tonuonu/NASA-Sample-Return-Robot/README.md

NASA-Sample-Return-Robot
========================

Some code related to https://www.facebook.com/TeamKuukulgur
