tonuonu/NASA-Sample-Return-Robot/SPI-Gyro-shield/Debugging/Rubeet.xlsx

Sheet: Sheet1
tspeed | load | dist | pidp | pidi | phase | cycles | tspeed | load | dist | pidp | pidi | phase | cycles | tspeed | load | dist | pidp | pidi | phase | cycles | tspeed | load | dist | pidp | pidi | phase | cycles
0 | 1 | 0 | -8 | 0 | 2 | 296 | 0 | -5 | 0 | 4 | 0 | 4 | 1025 | 0 | 7 | 0 | -9 | 0 | 2 | 1025 | 0 | -6 | 0 | 6 | 0 | 0 | 1025
0 | 1 | 0 | -8 | 0 | 2 | 296 | 0 | -5 | 0 | 4 | 0 | 4 | 1025 | 0 | 2 | 0 | -9 | 0 | 2 | 1025 | 0 | 7 | 1 | -7 | 0 | 1 | 296
0 | -8 | 0 | 4 | 0 | 3 | 1025 | 0 | 4 | 1 | -4 | 0 | 5 | 296 | 0 | 2 | 0 | -9 | 0 | 2 | 1025 | 0 | 6 | 0 | -5 | 0 | 1 | 296
0 | -6 | 1 | 2 | 0 | 4 | 203 | 0 | 4 | 0 | -4 | 0 | 5 | 296 | 0 | 1 | 0 | -9 | 0 | 2 | 1025 | 0 | 1 | 0 | -5 | 0 | 1 | 296
0 | 0 | 0 | 2 | 0 | 4 | 203 | 0 | 0 | 0 | -4 | 0 | 5 | 296 | 0 | 2 | 0 | -9 | 0 | 2 | 1025 | 0 | 1 | 0 | -5 | 0 | 1 | 296
0 | -1 | 0 | 2 | 0 | 4 | 203 | 0 | 0 | 0 | -3 | 0 | 5 | 296 | 0 | 1 | 0 | -9 | 0 | 2 | 1025 | 0 | 1 | 0 | -5 | 0 | 1 | 296
0 | -1 | 0 | 2 | 0 | 4 | 203 | 0 | 0 | 0 | -4 | 0 | 5 | 296 | 0 | -9 | 0 | 5 | 0 | 3 | 1025 | 0 | 1 | 0 | -5 | 0 | 1 | 296
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
