tonuonu/NASA-Sample-Return-Robot/PowerSupply/Hardware/kulgurpower2-unrouted.brd

## EAGLE design PowerSupply/Hardware/kulgurpower2-unrouted.brd (2014-05-24)

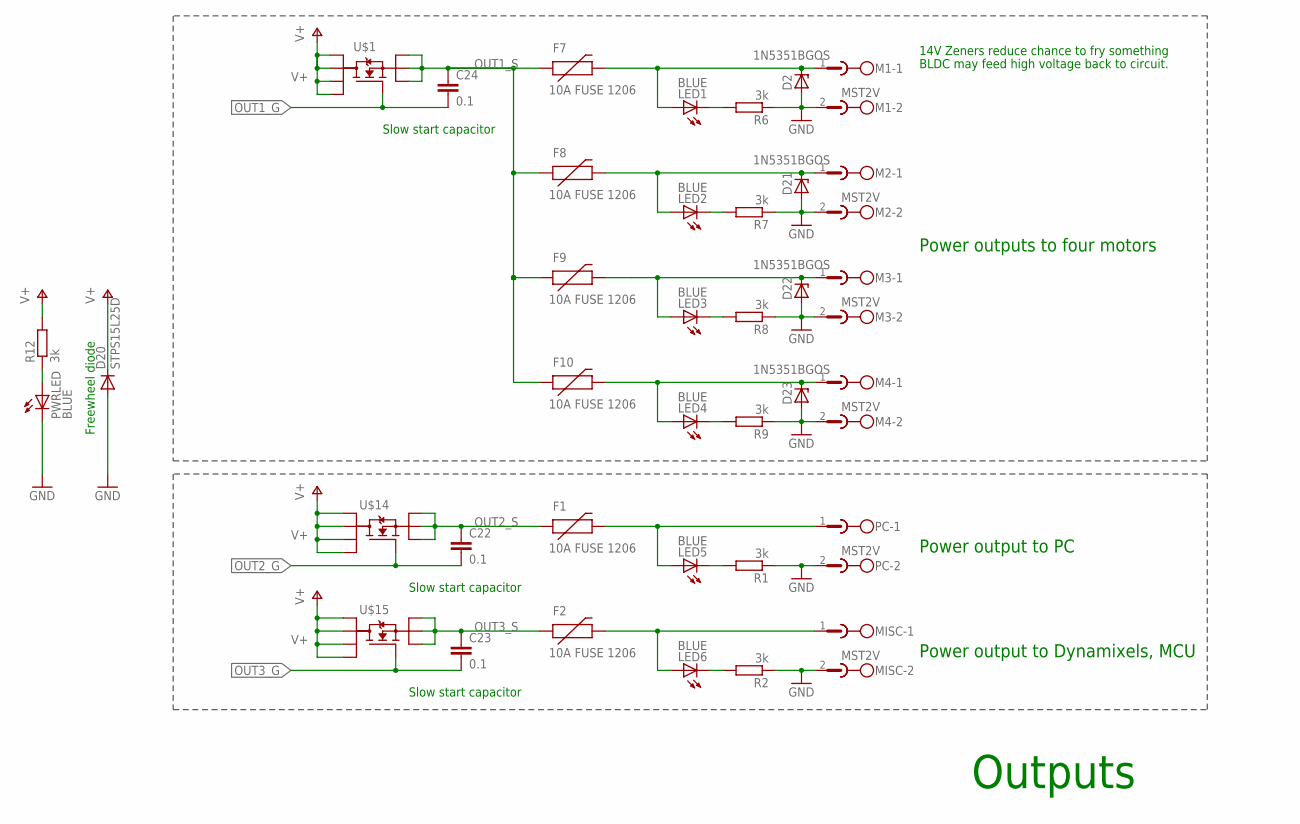
[picture p1: schematic kulgurpower2-unrouted.sch, sheet 1]

Parts:
C22, C23, C24: 0.1; C0603
D2, D21, D22, D23: 1N5351BGOS; C1702-15
D20: STPS15L25D; C221B1A
F1, F2, F7, F8, F9, F10: 10A FUSE 1206; PTC-1206
LED1, LED2, LED3, LED4, LED5, LED6: BLUE; CHIP-LED0603
M1, M2, M3, M4: MST2V; MSTBV2
MISC: MST2V; MSTBV2
PC: MST2V; MSTBV2
PWRLED: BLUE; CHIP-LED0603
R1, R2, R6, R7, R8, R9, R12: 3k; R0603
U$1, U$14, U$15: AON6500; POWER56

Connections:
GND: D2.A, D20.A, D21.A, D22.A, D23.A, M1.2, M2.2, M3.2, M4.2, MISC.2, PC.2, PWRLED.C, R1.1, R2.1, R6.1, R7.1, R8.1, R9.1; also elsewhere on the board
unnamed: LED1.C, R6.2
unnamed: LED2.C, R7.2
unnamed: LED3.C, R8.2
unnamed: LED4.C, R9.2
unnamed: LED5.C, R1.2
unnamed: LED6.C, R2.2
unnamed: PWRLED.A, R12.1
OUT1_G: C24.2, U$1.P$4 (G); also elsewhere on the board
OUT1_S: C24.1, F7.1, F8.1, F9.1, F10.1, U$1.P$1 (S1), U$1.P$2 (S2), U$1.P$3 (S3); also elsewhere on the board
OUT2_G: C22.2, U$14.P$4 (G); also elsewhere on the board
OUT2_S: C22.1, F1.1, U$14.P$1 (S1), U$14.P$2 (S2), U$14.P$3 (S3); also elsewhere on the board
OUT3_G: C23.2, U$15.P$4 (G); also elsewhere on the board
OUT3_S: C23.1, F2.1, U$15.P$1 (S1), U$15.P$2 (S2), U$15.P$3 (S3); also elsewhere on the board
PWR1: D2.C, F7.2, LED1.A, M1.1
PWR2: D21.C, F8.2, LED2.A, M2.1
PWR3: D22.C, F9.2, LED3.A, M3.1
PWR4: D23.C, F10.2, LED4.A, M4.1
PWR5: F1.2, LED5.A, PC.1
PWR6: F2.2, LED6.A, MISC.1
V+: D20.C, R12.2, U$1.P$5 (D4), U$1.P$6 (D3), U$1.P$7 (D2), U$1.P$8 (D1), U$14.P$5 (D4), U$14.P$6 (D3), U$14.P$7 (D2), U$14.P$8 (D1), U$15.P$5 (D4), U$15.P$6 (D3), U$15.P$7 (D2), U$15.P$8 (D1); also elsewhere on the board

Notes on the sheet:
Freewheel diode
BLDC may feed high voltage back to circuit.
14V Zeners reduce chance to fry something
Outputs
Power outputs to four motors
Power output to PC
Power output to Dynamixels, MCU
Slow start capacitor

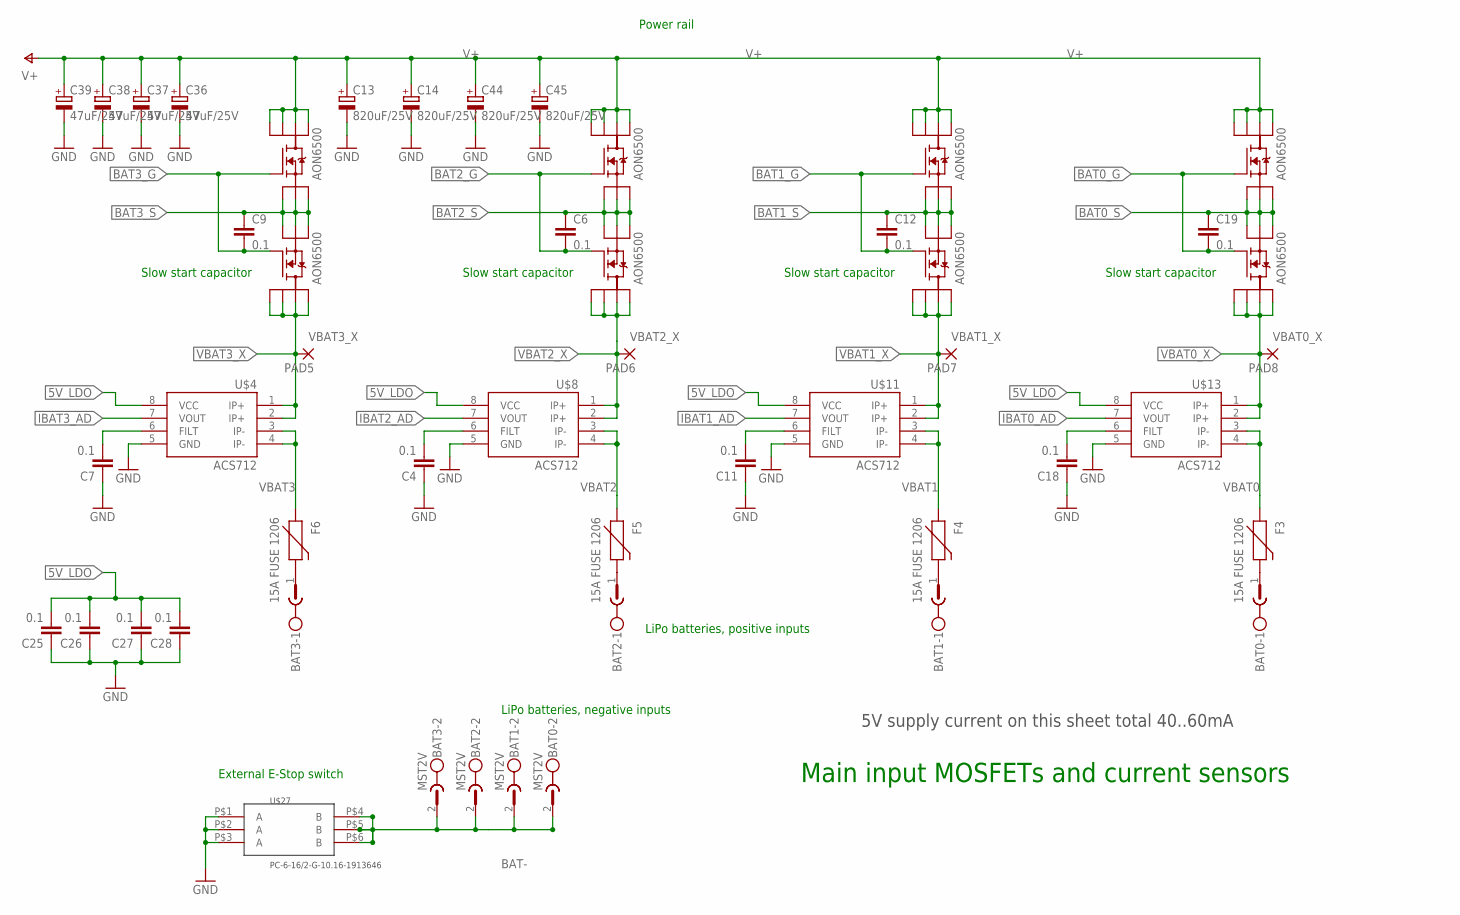
[picture p2: schematic kulgurpower2-unrouted.sch, sheet 2]

Parts:
BAT0, BAT1, BAT2, BAT3: MST2V; MSTBV2
C4, C6, C7, C9, C11, C12, C18, C19, C25, C26, C27, C28: 0.1; C0603
C13, C14, C44, C45: 820uF/25V; 153CLV-1014
C36, C37: 47uF/25V; C/6032-28R
C38, C39: 47uF/25V; 175TMP-0810
F3, F4, F5, F6: 15A FUSE 1206; PTC-1206
PAD5, PAD6, PAD7, PAD8: 1,6/0,9
U$2, U$3, U$5, U$6, U$7, U$9, U$10, U$12: AON6500; POWER56
U$4, U$8, U$11, U$13: ACS712; SO08
U$27: PC-6-16/2-G-10.16-1913646; PC-6-16/2-G-10.16

Connections:
5V_LDO: C25.2, C26.2, C27.2, C28.2, U$4.8 (VCC), U$8.8 (VCC), U$11.8 (VCC), U$13.8 (VCC); also elsewhere on the board
BAT0_G: C19.2, U$5.P$4 (G), U$12.P$4 (G); also elsewhere on the board
BAT0_S: C19.1, U$5.P$1 (S1), U$5.P$2 (S2), U$5.P$3 (S3), U$12.P$1 (S1), U$12.P$2 (S2), U$12.P$3 (S3); also elsewhere on the board
BAT1_G: C12.2, U$9.P$4 (G), U$10.P$4 (G); also elsewhere on the board
BAT1_S: C12.1, U$9.P$1 (S1), U$9.P$2 (S2), U$9.P$3 (S3), U$10.P$1 (S1), U$10.P$2 (S2), U$10.P$3 (S3); also elsewhere on the board
BAT2_G: C6.2, U$6.P$4 (G), U$7.P$4 (G); also elsewhere on the board
BAT2_S: C6.1, U$6.P$1 (S1), U$6.P$2 (S2), U$6.P$3 (S3), U$7.P$1 (S1), U$7.P$2 (S2), U$7.P$3 (S3); also elsewhere on the board
BAT3_G: C9.2, U$2.P$4 (G), U$3.P$4 (G); also elsewhere on the board
BAT3_S: C9.1, U$2.P$1 (S1), U$2.P$2 (S2), U$2.P$3 (S3), U$3.P$1 (S1), U$3.P$2 (S2), U$3.P$3 (S3); also elsewhere on the board
BAT-: BAT0.2, BAT1.2, BAT2.2, BAT3.2, U$27.P$4 (B), U$27.P$5 (B), U$27.P$6 (B)
GND: C4.1, C7.1, C11.1, C13.-, C14.-, C18.1, C25.1, C26.1, C27.1, C28.1, C36.-, C37.-, C38.-, C39.-, C44.-, C45.-, U$4.5 (GND), U$8.5 (GND), U$11.5 (GND), U$13.5 (GND), U$27.P$1 (A), U$27.P$2 (A), U$27.P$3 (A); also elsewhere on the board
IBAT0_AD: U$13.7 (VOUT); also elsewhere on the board
IBAT1_AD: U$11.7 (VOUT); also elsewhere on the board
IBAT2_AD: U$8.7 (VOUT); also elsewhere on the board
IBAT3_AD: U$4.7 (VOUT); also elsewhere on the board
unnamed: BAT0.1, F3.2
unnamed: BAT3.1, F6.2
unnamed: BAT1.1, F4.2
unnamed: C4.2, U$8.6 (FILT)
unnamed: BAT2.1, F5.2
unnamed: C11.2, U$11.6 (FILT)
unnamed: C7.2, U$4.6 (FILT)
unnamed: C18.2, U$13.6 (FILT)
V+: C13.+, C14.+, C36.+, C37.+, C38.+, C39.+, C44.+, C45.+, U$2.P$5 (D4), U$2.P$6 (D3), U$2.P$7 (D2), U$2.P$8 (D1), U$5.P$5 (D4), U$5.P$6 (D3), U$5.P$7 (D2), U$5.P$8 (D1), U$6.P$5 (D4), U$6.P$6 (D3), U$6.P$7 (D2), U$6.P$8 (D1), U$9.P$5 (D4), U$9.P$6 (D3), U$9.P$7 (D2), U$9.P$8 (D1); also elsewhere on the board
VBAT0: F3.1, U$13.3 (IP-), U$13.4 (IP-)
VBAT0_X: PAD8.1, U$12.P$5 (D4), U$12.P$6 (D3), U$12.P$7 (D2), U$12.P$8 (D1), U$13.1 (IP+), U$13.2 (IP+); also elsewhere on the board
VBAT1: F4.1, U$11.3 (IP-), U$11.4 (IP-)
VBAT1_X: PAD7.1, U$10.P$5 (D4), U$10.P$6 (D3), U$10.P$7 (D2), U$10.P$8 (D1), U$11.1 (IP+), U$11.2 (IP+); also elsewhere on the board
VBAT2: F5.1, U$8.3 (IP-), U$8.4 (IP-)
VBAT2_X: PAD6.1, U$7.P$5 (D4), U$7.P$6 (D3), U$7.P$7 (D2), U$7.P$8 (D1), U$8.1 (IP+), U$8.2 (IP+); also elsewhere on the board
VBAT3: F6.1, U$4.3 (IP-), U$4.4 (IP-)
VBAT3_X: PAD5.1, U$3.P$5 (D4), U$3.P$6 (D3), U$3.P$7 (D2), U$3.P$8 (D1), U$4.1 (IP+), U$4.2 (IP+); also elsewhere on the board

Notes on the sheet:
External E-Stop switch
LiPo batteries, positive inputs
LiPo batteries, negative inputs
Power rail
Main input MOSFETs and current sensors
5V supply current on this sheet total 40..60mA
Slow start capacitor

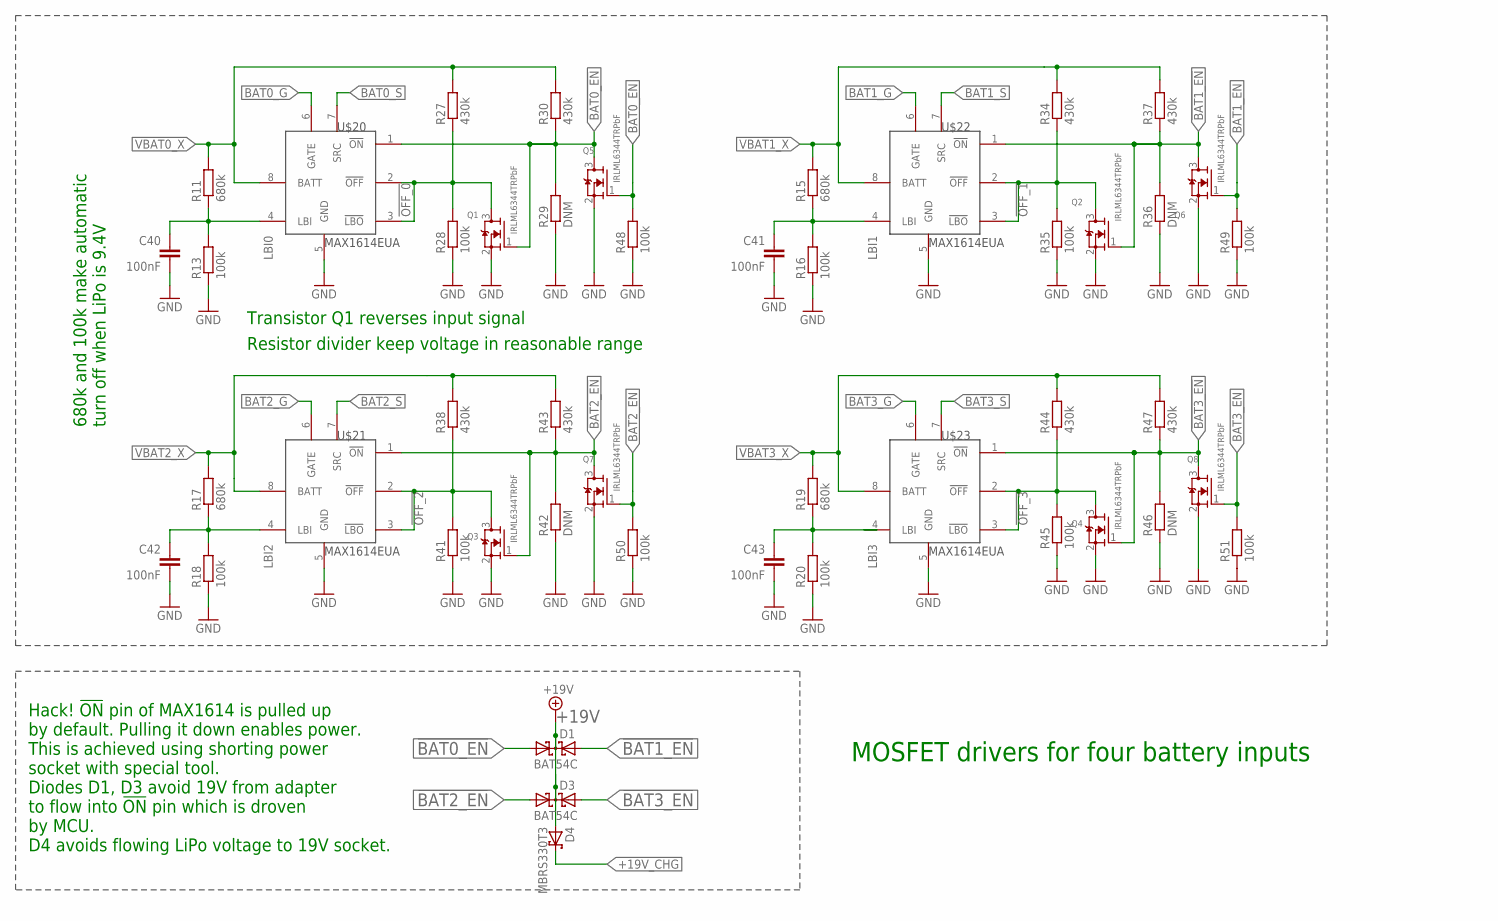
[picture p3: schematic kulgurpower2-unrouted.sch, sheet 3]

Parts:
C40, C41, C42, C43: 100nF; C0603
D1, D3: BAT54C; SOT23
D4: MBRS330T3; SMC
Q1, Q2, Q3, Q4, Q5, Q6, Q7, Q8: IRLML6344TRPbF; SOT23
R11, R15, R17, R19: 680k; R0603
R13, R16, R18, R20, R28, R35, R41, R45, R48, R49, R50, R51: 100k; R0603
R27, R30, R34, R37, R38, R43, R44, R47: 430k; R0603
R29, R36, R42, R46: DNM; R0603
U$20, U$21, U$22, U$23: MAX1614EUA

Connections:
!BAT0_EN: D1.1 (A1), Q1.1 (G), Q5.3 (D), R29.2, R30.1, U$20.1 (!ON)
!BAT1_EN: D1.2 (A2), Q2.1 (G), Q6.3 (D), R36.2, R37.1, U$22.1 (!ON)
!BAT2_EN: D3.1 (A1), Q3.1 (G), Q7.3 (D), R42.2, R43.1, U$21.1 (!ON)
!BAT3_EN: D3.2 (A2), Q4.1 (G), Q8.3 (D), R46.2, R47.1, U$23.1 (!ON)
!OFF_0: Q1.3 (D), R27.1, R28.2, U$20.2 (!OFF), U$20.3 (!LBO)
!OFF_1: Q2.3 (D), R34.1, R35.2, U$22.2 (!OFF), U$22.3 (!LBO)
!OFF_2: Q3.3 (D), R38.1, R41.2, U$21.2 (!OFF), U$21.3 (!LBO)
!OFF_3: Q4.3 (D), R44.1, R45.2, U$23.2 (!OFF), U$23.3 (!LBO)
+19V: D1.3 (CC), D3.3 (CC), D4.A; also elsewhere on the board
+19V_CHG: D4.C; also elsewhere on the board
BAT0_EN: Q5.1 (G), R48.2; also elsewhere on the board
BAT0_G: U$20.6 (GATE); also elsewhere on the board
BAT0_S: U$20.7 (SRC); also elsewhere on the board
BAT1_EN: Q6.1 (G), R49.2; also elsewhere on the board
BAT1_G: U$22.6 (GATE); also elsewhere on the board
BAT1_S: U$22.7 (SRC); also elsewhere on the board
BAT2_EN: Q7.1 (G), R50.2; also elsewhere on the board
BAT2_G: U$21.6 (GATE); also elsewhere on the board
BAT2_S: U$21.7 (SRC); also elsewhere on the board
BAT3_EN: Q8.1 (G), R51.2; also elsewhere on the board
BAT3_G: U$23.6 (GATE); also elsewhere on the board
BAT3_S: U$23.7 (SRC); also elsewhere on the board
GND: C40.2, C41.2, C42.2, C43.2, Q1.2 (S), Q2.2 (S), Q3.2 (S), Q4.2 (S), Q5.2 (S), Q6.2 (S), Q7.2 (S), Q8.2 (S), R13.1, R16.1, R18.1, R20.1, R28.1, R29.1, R35.1, R36.1, R41.1, R42.1, R45.1, R46.1, R48.1, R49.1, R50.1, R51.1, U$20.5 (GND), U$21.5 (GND), U$22.5 (GND), U$23.5 (GND); also elsewhere on the board
LBI0: C40.1, R11.1, R13.2, U$20.4 (LBI)
LBI1: C41.1, R15.1, R16.2, U$22.4 (LBI)
LBI2: C42.1, R17.1, R18.2, U$21.4 (LBI)
LBI3: C43.1, R19.1, R20.2, U$23.4 (LBI)
VBAT0_X: R11.2, R27.2, R30.2, U$20.8 (BATT); also elsewhere on the board
VBAT1_X: R15.2, R34.2, R37.2, U$22.8 (BATT); also elsewhere on the board
VBAT2_X: R17.2, R38.2, R43.2, U$21.8 (BATT); also elsewhere on the board
VBAT3_X: R19.2, R44.2, R47.2, U$23.8 (BATT); also elsewhere on the board

Notes on the sheet:
680k and 100k make automatic turn off when LiPo is 9.4V
MOSFET drivers for four battery inputs
Hack! !ON! pin of MAX1614 is pulled up by default. Pulling it down enables power. This is achieved using shorting power socket with special tool. Diodes D1, D3 avoid 19V from adapter to flow into !ON! pin which is droven by MCU. D4 avoids flowing LiPo voltage to 19V socket.
Resistor divider keep voltage in reasonable range
Transistor Q1 reverses input signal

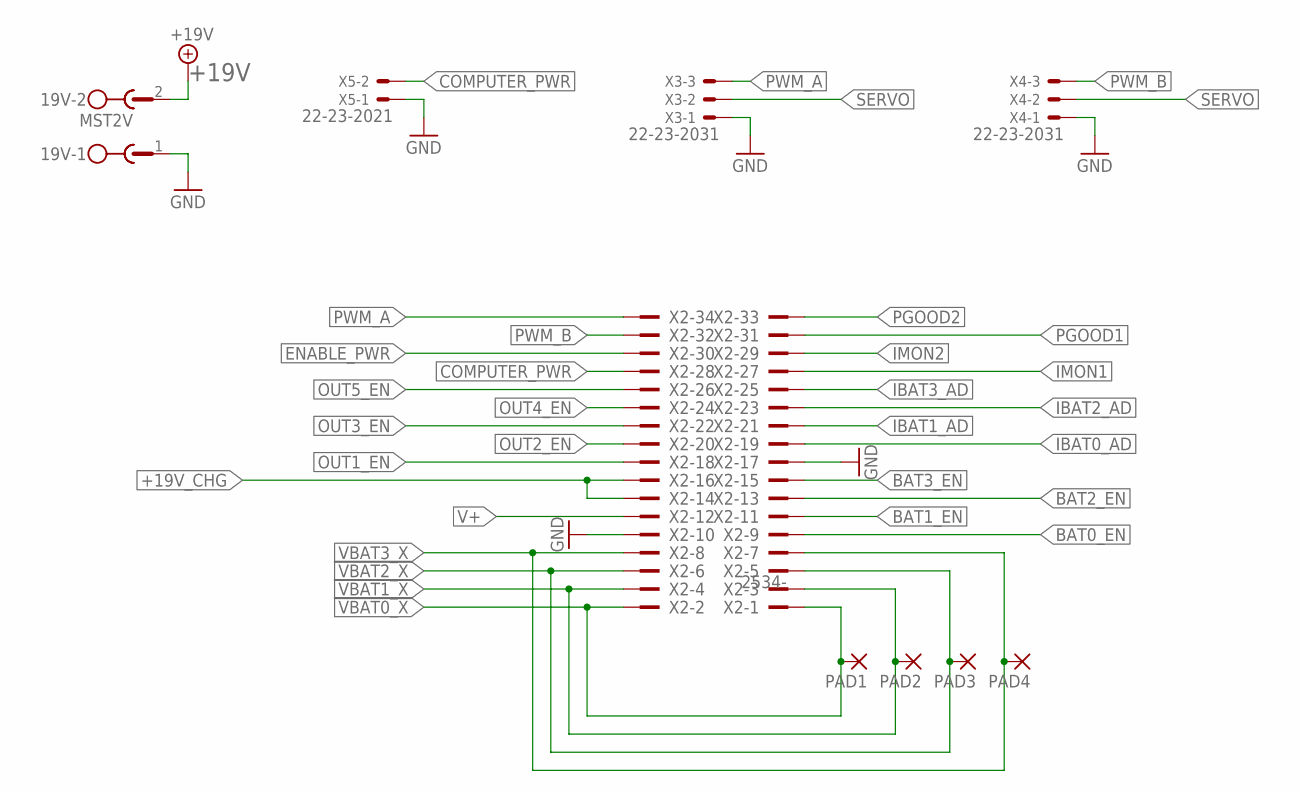
[picture p4: schematic kulgurpower2-unrouted.sch, sheet 4]

Parts:
19V: MST2V; MSTBV2
PAD1, PAD2, PAD3, PAD4: 1,6/0,9
X2: 2534-; PAK100/2500-34
X3, X4: 22-23-2031
X5: 22-23-2021

Connections:
+19V: 19V.2; also elsewhere on the board
+19V_CHG: X2.14, X2.16; also elsewhere on the board
BAT0_EN: X2.9; also elsewhere on the board
BAT1_EN: X2.11; also elsewhere on the board
BAT2_EN: X2.13; also elsewhere on the board
BAT3_EN: X2.15; also elsewhere on the board
COMPUTER_PWR: X2.28, X5.2
ENABLE_PWR: X2.30; also elsewhere on the board
GND: 19V.1, X2.10, X2.17, X3.1, X4.1, X5.1; also elsewhere on the board
IBAT0_AD: X2.19; also elsewhere on the board
IBAT1_AD: X2.21; also elsewhere on the board
IBAT2_AD: X2.23; also elsewhere on the board
IBAT3_AD: X2.25; also elsewhere on the board
IMON1: X2.27; also elsewhere on the board
IMON2: X2.29; also elsewhere on the board
OUT1_EN: X2.18; also elsewhere on the board
OUT2_EN: X2.20; also elsewhere on the board
OUT3_EN: X2.22; also elsewhere on the board
OUT4_EN: X2.24; also elsewhere on the board
OUT5_EN: X2.26; also elsewhere on the board
PGOOD1: X2.31; also elsewhere on the board
PGOOD2: X2.33; also elsewhere on the board
PWM_A: X2.34, X3.3
PWM_B: X2.32, X4.3
SERVO: X3.2, X4.2; also elsewhere on the board
V+: X2.12; also elsewhere on the board
VBAT0_X: PAD1.1, X2.1, X2.2; also elsewhere on the board
VBAT1_X: PAD2.1, X2.3, X2.4; also elsewhere on the board
VBAT2_X: PAD3.1, X2.5, X2.6; also elsewhere on the board
VBAT3_X: PAD4.1, X2.7, X2.8; also elsewhere on the board

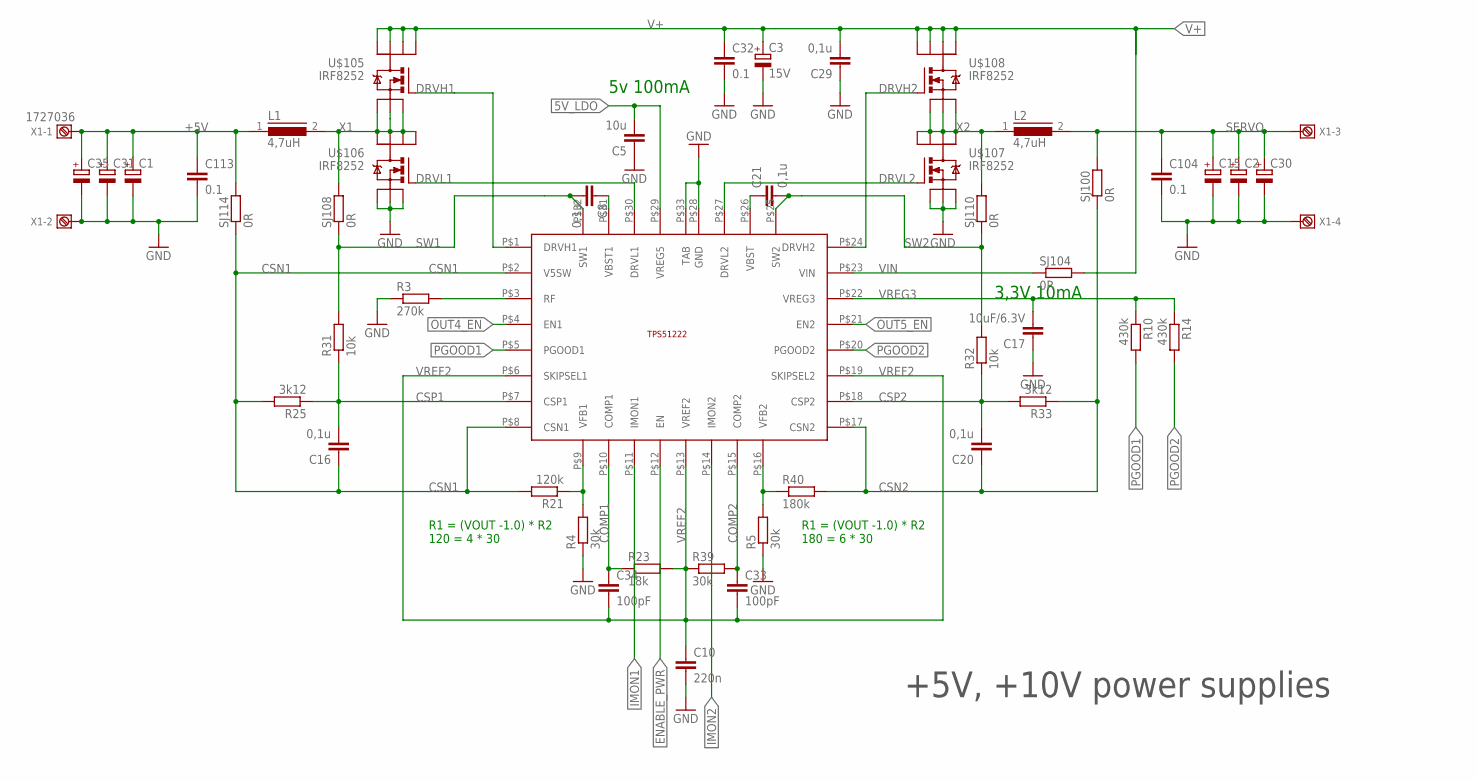
[picture p5: schematic kulgurpower2-unrouted.sch, sheet 5]

Parts:
C1, C2, C15, C30, C31, C35: CPOL-EUC/6032-28R; C/6032-28R
C3: 15V; C/6032-28R
C5: 10u; C1210
C8, C16, C20, C21, C29: 0,1u; C0603
C10: 220n; C0603
C17: 10uF/6.3V; C1210
C32, C104, C113: 0.1; C0603
C33, C34: 100pF; 0805
L1, L2: 4,7uH; DR125
R3: 270k; R0603
R4, R5, R39: 30k; R0603
R10, R14: 430k; R0603
R21: 120k; R0603
R23: 18k; R0603
R25, R33: 3k12; R0603
R31, R32: 10k; R0603
R40: 180k; R0603
SJ100, SJ104, SJ108, SJ110, SJ114: 0R; R0603
U$17: TPS51222RTVT; QFN-32
U$105, U$106, U$107, U$108: IRF8252; SO8
X1: 1727036

Connections:
5V_LDO: C5.2, U$17.P$29 (VREG5); also elsewhere on the board
+5V: C1.+, C31.+, C35.+, C113.1, L1.1, SJ114.2, X1.1
COMP1: C34.1, R23.1, U$17.P$10 (COMP1)
COMP2: C33.1, R39.2, U$17.P$15 (COMP2)
CSN1: C16.1, R21.2, R25.2, SJ114.1, U$17.P$2 (V5SW), U$17.P$8 (CSN1)
CSN2: C20.1, R33.1, R40.2, SJ100.1, U$17.P$17 (CSN2)
CSP1: C16.2, R25.1, R31.1, U$17.P$7 (CSP1)
CSP2: C20.2, R32.1, R33.2, U$17.P$18 (CSP2)
DRVH1: U$17.P$1 (DRVH1), U$105.4 (G)
DRVH2: U$17.P$24 (DRVH2), U$108.4 (G)
DRVL1: U$17.P$30 (DRVL1), U$106.4 (G)
DRVL2: U$17.P$27 (DRVL2), U$107.4 (G)
ENABLE_PWR: U$17.P$12 (EN); also elsewhere on the board
GND: C1.-, C2.-, C3.-, C5.1, C10.2, C15.-, C17.1, C29.1, C30.-, C31.-, C32.2, C35.-, C104.2, C113.2, R3.1, R4.1, R5.1, U$17.P$28 (GND), U$17.P$33 (TAB), U$106.1 (S), U$106.2 (S), U$106.3 (S), U$107.1 (S), U$107.2 (S), U$107.3 (S), X1.2, X1.4; also elsewhere on the board
IMON1: U$17.P$11 (IMON1); also elsewhere on the board
IMON2: U$17.P$14 (IMON2); also elsewhere on the board
unnamed: R4.2, R21.1, U$17.P$9 (VFB1)
unnamed: R5.2, R40.1, U$17.P$16 (VFB2)
unnamed: R3.2, U$17.P$3 (RF)
unnamed: C8.1, U$17.P$31 (VBST1)
unnamed: C21.1, U$17.P$26 (VBST)
OUT4_EN: U$17.P$4 (EN1); also elsewhere on the board
OUT5_EN: U$17.P$21 (EN2); also elsewhere on the board
PGOOD1: R10.2, U$17.P$5 (PGOOD1); also elsewhere on the board
PGOOD2: R14.2, U$17.P$20 (PGOOD2); also elsewhere on the board
SERVO: C2.+, C15.+, C30.+, C104.1, L2.2, SJ100.2, X1.3; also elsewhere on the board
SW1: C8.2, R31.2, SJ108.1, U$17.P$32 (SW1)
SW2: C21.2, R32.2, SJ110.1, U$17.P$25 (SW2)
V+: C3.+, C29.2, C32.1, SJ104.2, U$105.5 (D), U$105.6 (D), U$105.7 (D), U$105.8 (D), U$108.5 (D), U$108.6 (D), U$108.7 (D), U$108.8 (D); also elsewhere on the board
VIN: SJ104.1, U$17.P$23 (VIN)
VREF2: C10.1, C33.2, C34.2, R23.2, R39.1, U$17.P$6 (SKIPSEL1), U$17.P$13 (VREF2), U$17.P$19 (SKIPSEL2)
VREG3: C17.2, R10.1, R14.1, U$17.P$22 (VREG3)
X1: L1.2, SJ108.2, U$105.1 (S), U$105.2 (S), U$105.3 (S), U$106.5 (D), U$106.6 (D), U$106.7 (D), U$106.8 (D)
X2: L2.1, SJ110.2, U$107.5 (D), U$107.6 (D), U$107.7 (D), U$107.8 (D), U$108.1 (S), U$108.2 (S), U$108.3 (S)

Notes on the sheet:
+5V, +10V power supplies
3,3V 10mA
5v 100mA
R1 = (VOUT -1.0) * R2 120 = 4 * 30
R1 = (VOUT -1.0) * R2 180 = 6 * 30

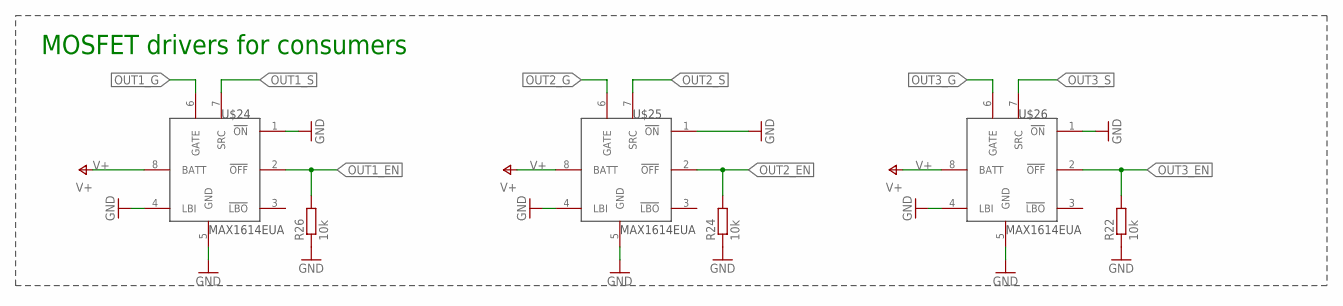
[picture p6: schematic kulgurpower2-unrouted.sch, sheet 6]

Parts:
R22, R24, R26: 10k; R0603
U$24, U$25, U$26: MAX1614EUA

Connections:
GND: R22.1, R24.1, R26.1, U$24.1 (!ON), U$24.4 (LBI), U$24.5 (GND), U$25.1 (!ON), U$25.4 (LBI), U$25.5 (GND), U$26.1 (!ON), U$26.4 (LBI), U$26.5 (GND); also elsewhere on the board
OUT1_EN: R26.2, U$24.2 (!OFF); also elsewhere on the board
OUT1_G: U$24.6 (GATE); also elsewhere on the board
OUT1_S: U$24.7 (SRC); also elsewhere on the board
OUT2_EN: R24.2, U$25.2 (!OFF); also elsewhere on the board
OUT2_G: U$25.6 (GATE); also elsewhere on the board
OUT2_S: U$25.7 (SRC); also elsewhere on the board
OUT3_EN: R22.2, U$26.2 (!OFF); also elsewhere on the board
OUT3_G: U$26.6 (GATE); also elsewhere on the board
OUT3_S: U$26.7 (SRC); also elsewhere on the board
V+: U$24.8 (BATT), U$25.8 (BATT), U$26.8 (BATT); also elsewhere on the board

Notes on the sheet:
MOSFET drivers for consumers

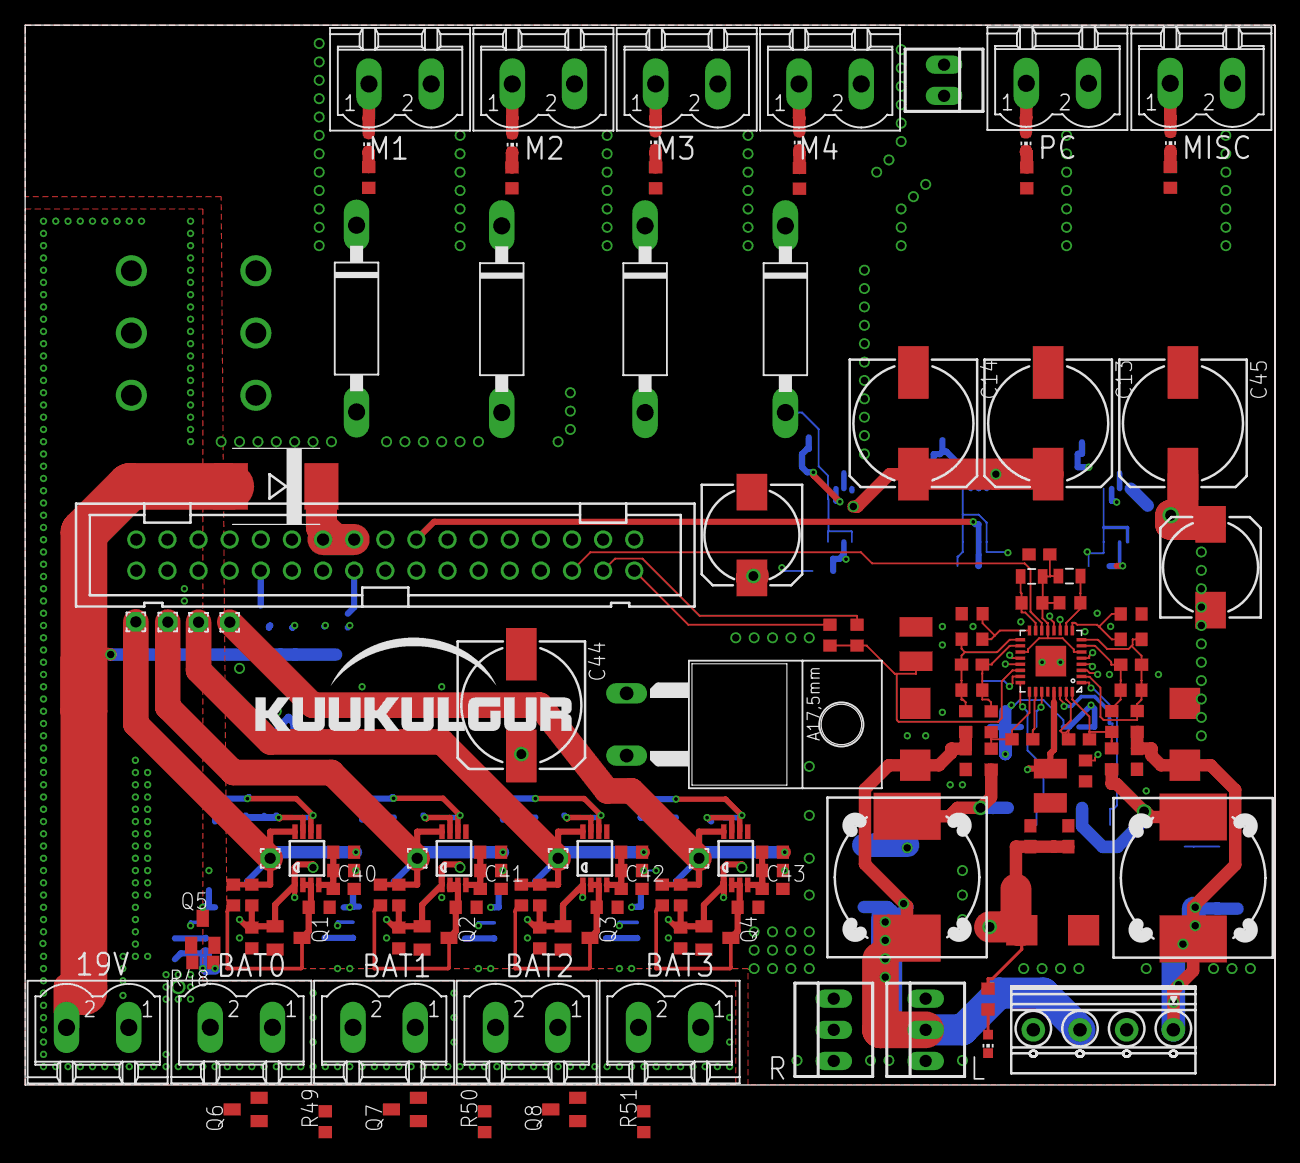
[picture p7: board kulgurpower2-unrouted.brd from above]

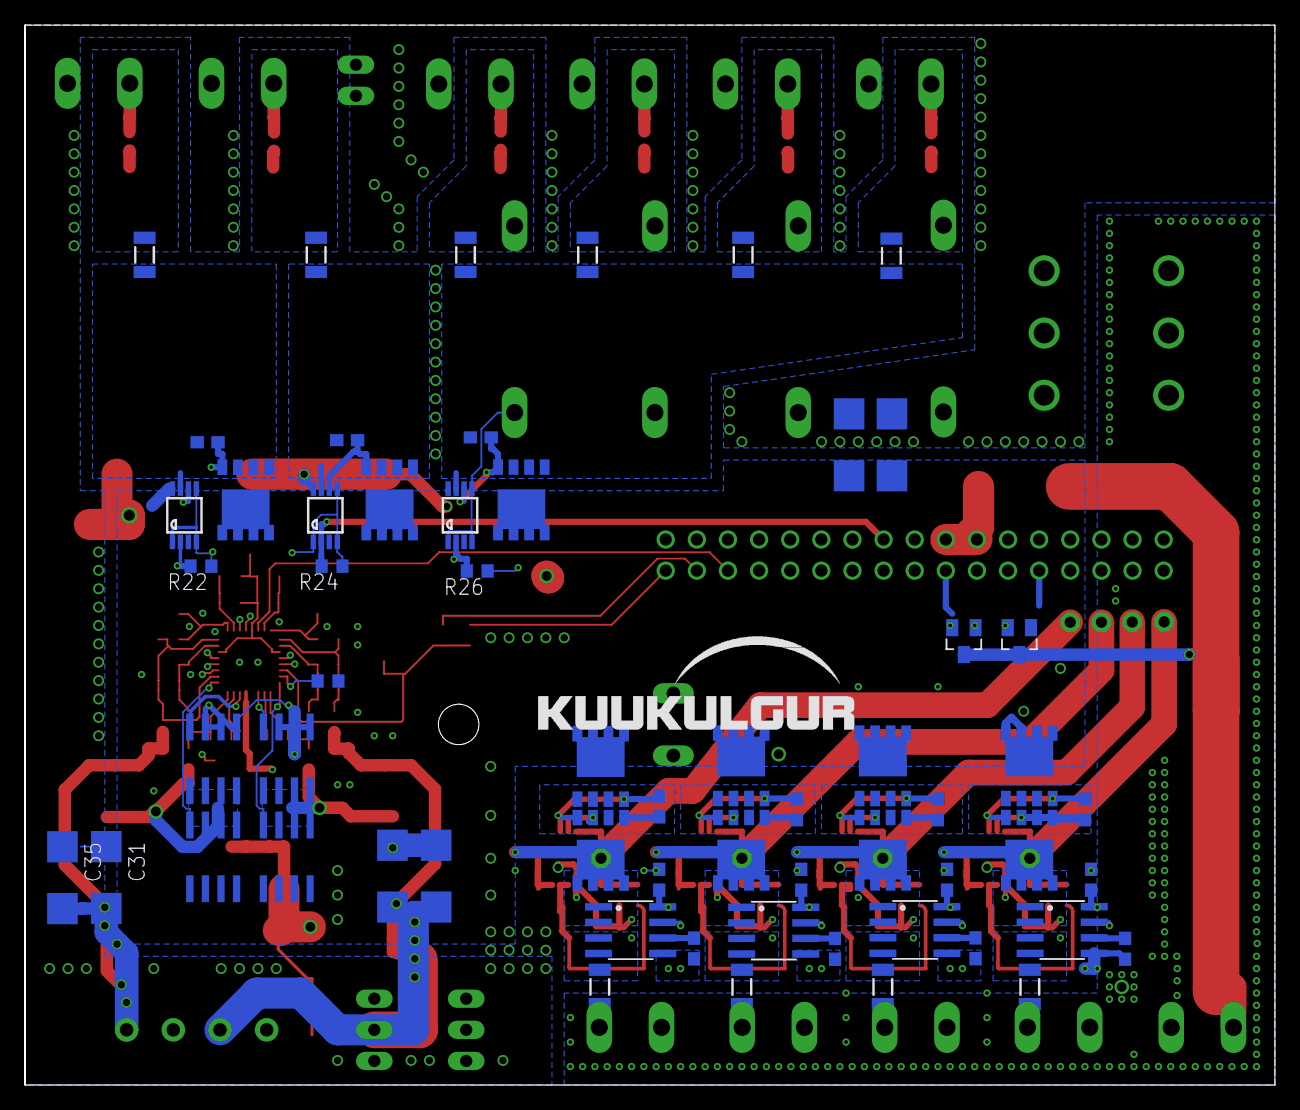
[picture p8: board kulgurpower2-unrouted.brd from below]

Board: 4 copper layers, 102.0 x 86.5 mm, 190 parts (59 on the bottom side), 106 nets.
