tonuonu/NASA-Sample-Return-Robot/PowerSupply/Hardware/kulgurpowerMCU3-unrouted.brd

## EAGLE design PowerSupply/Hardware/kulgurpowerMCU3-unrouted.brd (2014-05-14)

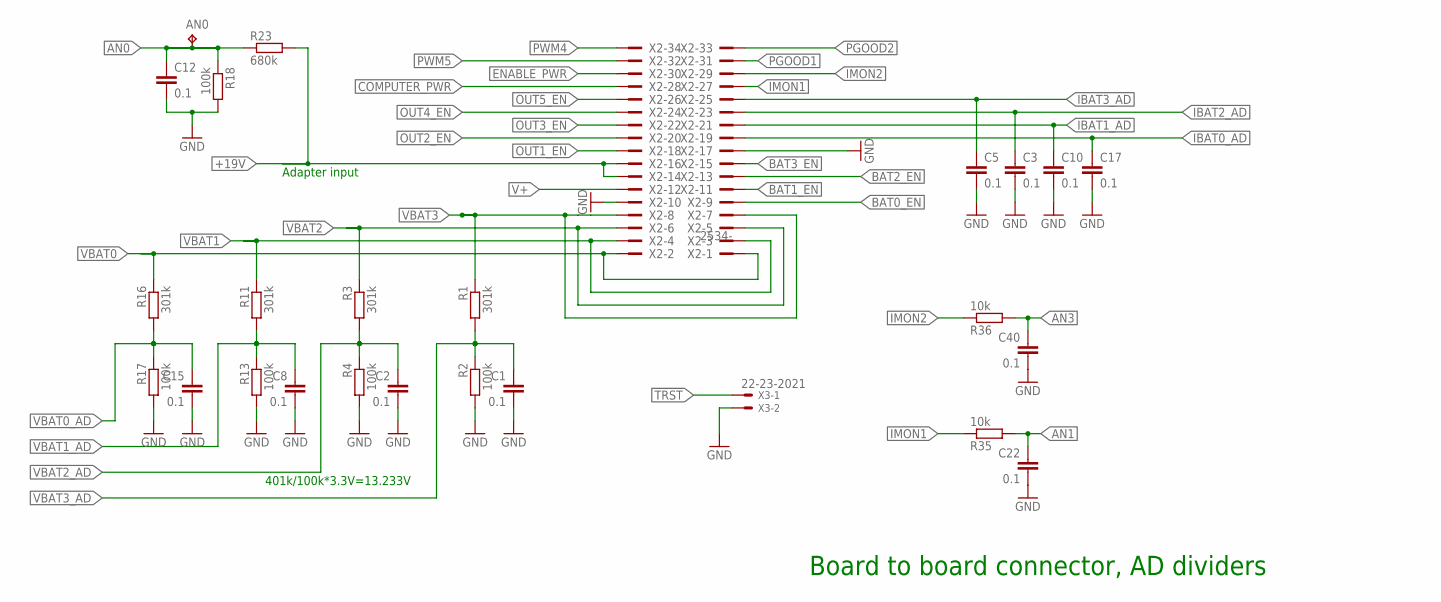
[picture p9: schematic kulgurpowerMCU3-unrouted.sch, sheet 1]

Parts:
AN0: TPB1,27; B1,27
C1, C2, C3, C5, C8, C10, C15, C17, C22, C40: 0.1; C0603
C12: 0.1; 0603-CAP
R1, R3, R11, R16: 301k; R0603
R2, R4, R13, R17, R18: 100k; R0603
R23: 680k; R0603
R35, R36: 10k; R0603
X2: 2534-; PAK100/2500-34
X3: 22-23-2021

Connections:
!TRST: X3.1; also elsewhere on the board
+19V: R23.2, X2.14, X2.16; also elsewhere on the board
AN0: AN0.TP, C12.1, R18.1, R23.1; also elsewhere on the board
AN1: C22.1, R35.2; also elsewhere on the board
AN3: C40.1, R36.2; also elsewhere on the board
BAT0_EN: X2.9; also elsewhere on the board
BAT1_EN: X2.11; also elsewhere on the board
BAT2_EN: X2.13; also elsewhere on the board
BAT3_EN: X2.15; also elsewhere on the board
COMPUTER_PWR: X2.28; also elsewhere on the board
ENABLE_PWR: X2.30; also elsewhere on the board
GND: C1.2, C2.2, C3.2, C5.2, C8.2, C10.2, C12.2, C15.2, C17.2, C22.2, C40.2, R2.2, R4.2, R13.2, R17.2, R18.2, X2.10, X2.17, X3.2; also elsewhere on the board
IBAT0_AD: C17.1, X2.19; also elsewhere on the board
IBAT1_AD: C10.1, X2.21; also elsewhere on the board
IBAT2_AD: C3.1, X2.23; also elsewhere on the board
IBAT3_AD: C5.1, X2.25; also elsewhere on the board
IMON1: R35.1, X2.27
IMON2: R36.1, X2.29
OUT1_EN: X2.18; also elsewhere on the board
OUT2_EN: X2.20; also elsewhere on the board
OUT3_EN: X2.22; also elsewhere on the board
OUT4_EN: X2.24; also elsewhere on the board
OUT5_EN: X2.26; also elsewhere on the board
PGOOD1: X2.31; also elsewhere on the board
PGOOD2: X2.33; also elsewhere on the board
PWM4: X2.34; also elsewhere on the board
PWM5: X2.32; also elsewhere on the board
V+: X2.12; also elsewhere on the board
VBAT0: R16.1, X2.1, X2.2; also elsewhere on the board
VBAT0_AD: C15.1, R16.2, R17.1; also elsewhere on the board
VBAT1: R11.1, X2.3, X2.4; also elsewhere on the board
VBAT1_AD: C8.1, R11.2, R13.1; also elsewhere on the board
VBAT2: R3.1, X2.5, X2.6; also elsewhere on the board
VBAT2_AD: C2.1, R3.2, R4.1; also elsewhere on the board
VBAT3: R1.1, X2.7, X2.8; also elsewhere on the board
VBAT3_AD: C1.1, R1.2, R2.1; also elsewhere on the board

Notes on the sheet:
401k/100k*3.3V=13.233V
Board to board connector, AD dividers
Adapter input
