tonuonu/NASA-Sample-Return-Robot/PowerSupply/Hardware/kulgurpowerMCU3-unrouted.brd

## EAGLE design PowerSupply/Hardware/kulgurpowerMCU3-unrouted.brd (continued)

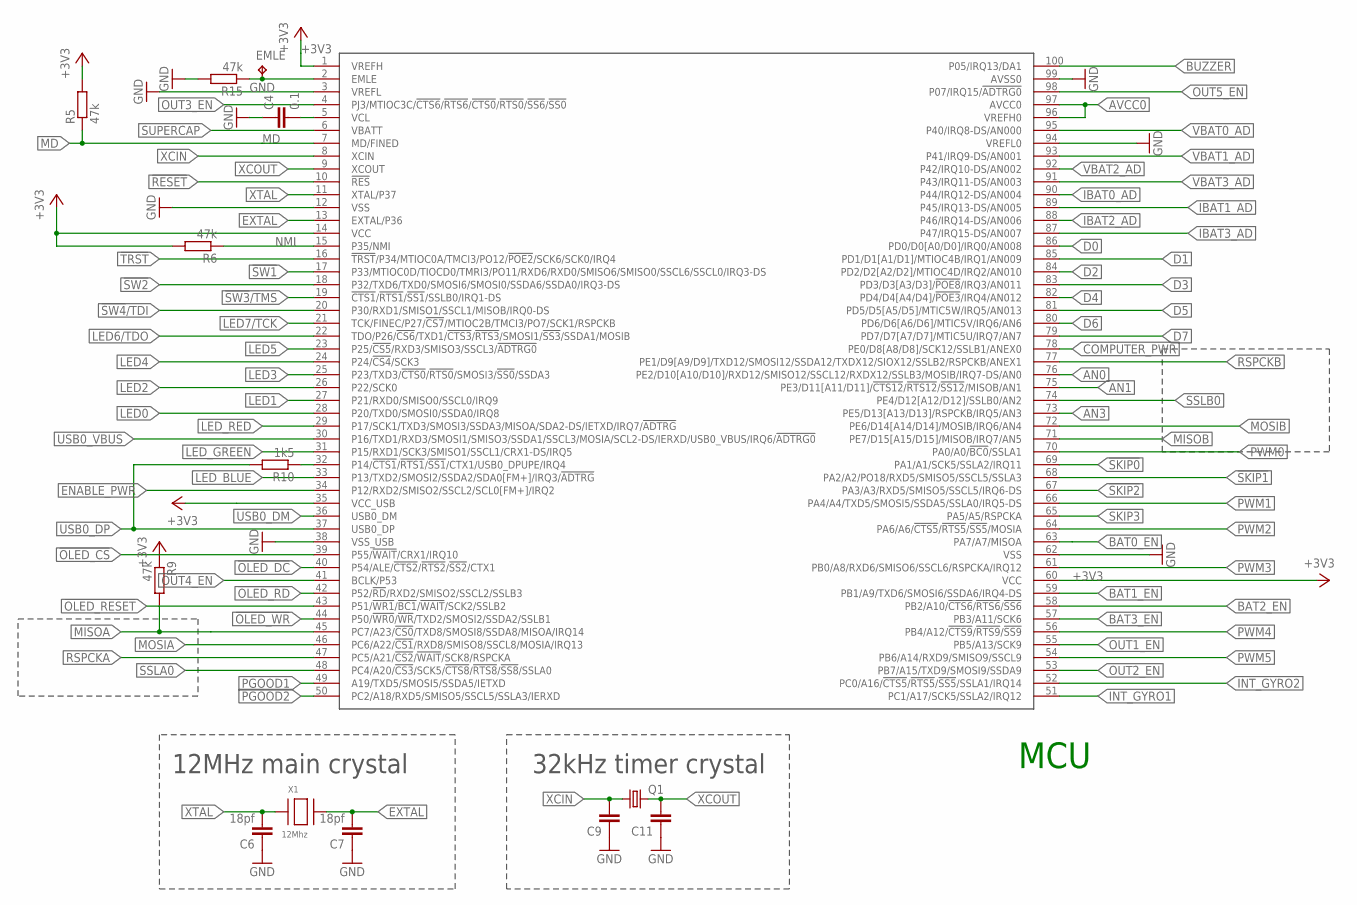
[picture p10: schematic kulgurpowerMCU3-unrouted.sch, sheet 2]

Parts:
C4: 0.1; 0603-CAP
C6, C7: 18pf; 0603-CAP
C9, C11: CAP0603-CAP; 0603-CAP
EMLE: TPB1,27; B1,27
Q1: CRYSTALMM20SS; MM20SS
R5, R6, R9, R15: 47k; R0603
R10: 1k5; R0603
U$14: R5F5630ADDFP; LTQFP100
X1: 12Mhz; NX5032

Connections:
!OLED_CS: U$14.39 (P55/!WAIT!/CRX1/IRQ10); also elsewhere on the board
!OLED_DC: U$14.40 (P54/ALE/!CTS2!/!RTS2!/!SS2!/CTX1); also elsewhere on the board
!OLED_RD: U$14.42 (P52/!RD!/RXD2/SMISO2/SSCL2/SSLB3); also elsewhere on the board
!OLED_RESET: U$14.43 (P51/!WR1!/!BC1!/!WAIT!/SCK2/SSLB2); also elsewhere on the board
!OLED_WR: U$14.44 (P50/!WR0!/!WR!/TXD2/SMOSI2/SSDA2/SSLB1); also elsewhere on the board
!RESET: U$14.10 (!RES!); also elsewhere on the board
!SKIP0: U$14.69 (PA1/A1/SCK5/SSLA2/IRQ11); also elsewhere on the board
!SKIP1: U$14.68 (PA2/A2/PO18/RXD5/SMISO5/SSCL5/SSLA3); also elsewhere on the board
!SKIP2: U$14.67 (PA3/A3/RXD5/SMISO5/SSCL5/IRQ6-DS); also elsewhere on the board
!SKIP3: U$14.65 (PA5/A5/RSPCKA); also elsewhere on the board
!SW1: U$14.17 (P33/MTIOC0D/TIOCD0/TMRI3/PO11/RXD6/RXD0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); also elsewhere on the board
!SW2: U$14.18 (P32/TXD6/TXD0/SMOSI6/SMOSI0/SSDA6/SSDA0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); also elsewhere on the board
!SW3!/TMS: U$14.19 (!CTS1!/!RTS1!/!SS1!/SSLB0/IRQ1-DS); also elsewhere on the board
!SW4!/TDI: U$14.20 (P30/RXD1/SMISO1/SSCL1/MISOB/IRQ0-DS); also elsewhere on the board
!TRST: U$14.16 (!TRST!/P34/MTIOC0A/TMCI3/PO12/!POE2!/SC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); also elsewhere on the board
+3V3: R5.2, R6.2, R9.1, U$14.1 (VREFH), U$14.14 (VCC), U$14.35 (VCC_USB), U$14.60 (VCC); also elsewhere on the board
AN0: U$14.76 (PE2/D10[A10/D10]/RXD12/SMISO12/SSCL12/R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); also elsewhere on the board
AN1: U$14.75 (PE3/D11[A11/D11]/!CTS12!/!RTS12!/!SS12!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); also elsewhere on the board
AN3: U$14.73 (PE5/D13[A13/D13]/RSPCKB/IRQ5/AN3); also elsewhere on the board
AVCC0: U$14.96 (VREFH0), U$14.97 (AVCC0); also elsewhere on the board
BAT0_EN: U$14.63 (PA7/A7/MISOA); also elsewhere on the board
BAT1_EN: U$14.59 (PB1/A9/TXD6/SMOSI6/SSDA6/IRQ4-DS); also elsewhere on the board
BAT2_EN: U$14.58 (PB2/A10/!CTS6!/!RTS6!/!SS6!); also elsewhere on the board
BAT3_EN: U$14.57 (PB3/A11/SCK6); also elsewhere on the board
BUZZER: U$14.100 (P05/IRQ13/DA1); also elsewhere on the board
COMPUTER_PWR: U$14.78 (PE0/D8[A8/D8]/SCK12/SSLB1/ANEX0); also elsewhere on the board
D0: U$14.86 (PD0/D0[A0/D0]/IRQ0/AN008); also elsewhere on the board
D1: U$14.85 (PD1/D1[A1/D1]/MTIOC4B/IRQ1/AN009); also elsewhere on the board
D2: U$14.84 (PD2/D2[A2/D2]/MTIOC4D/IRQ2/AN010); also elsewhere on the board
D3: U$14.83 (PD3/D3[A3/D3]/!POE8!/IRQ3/AN011); also elsewhere on the board
D4: U$14.82 (PD4/D4[A4/D4]/!POE3!/IRQ4/AN012); also elsewhere on the board
D5: U$14.81 (PD5/D5[A5/D5]/MTIC5W/IRQ5/AN013); also elsewhere on the board
D6: U$14.80 (PD6/D6[A6/D6]/MTIC5V/IRQ6/AN6); also elsewhere on the board
D7: U$14.79 (PD7/D7[A7/D7]/MTIC5U/IRQ7/AN7); also elsewhere on the board
EMLE: EMLE.TP, R15.1, U$14.2 (EMLE); also elsewhere on the board
ENABLE_PWR: U$14.34 (P12/RXD2/SMISO2/SSCL2/SCL0[FM+]/IRQ2); also elsewhere on the board
EXTAL: C7.2, U$14.13 (EXTAL/P36), X1.P$2
GND: C4.1, C6.1, C7.1, C9.1, C11.1, R15.2, U$14.3 (VREFL), U$14.12 (VSS), U$14.38 (VSS_USB), U$14.62 (VSS), U$14.94 (VREFL0), U$14.99 (AVSS0); also elsewhere on the board
IBAT0_AD: U$14.90 (P44/IRQ12-DS/AN004); also elsewhere on the board
IBAT1_AD: U$14.89 (P45/IRQ13-DS/AN005); also elsewhere on the board
IBAT2_AD: U$14.88 (P46/IRQ14-DS/AN006); also elsewhere on the board
IBAT3_AD: U$14.87 (P47/IRQ15-DS/AN007); also elsewhere on the board
INT_GYRO1: U$14.51 (PC1/A17/SCK5/SSLA2/IRQ12); also elsewhere on the board
INT_GYRO2: U$14.52 (PC0/A16/!CTS5!/!RTS5!/!SS5!/SSLA1/IRQ14); also elsewhere on the board
LED0: U$14.28 (P20/TXD0/SMOSI0/SSDA0/IRQ8); also elsewhere on the board
LED1: U$14.27 (P21/RXD0/SMISO0/SSCL0/IRQ9); also elsewhere on the board
LED2: U$14.26 (P22/SCK0); also elsewhere on the board
LED3: U$14.25 (P23/TXD3/!CTS0!/!RTS0!/SMOSI3/!SS0!/SSD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); also elsewhere on the board
LED4: U$14.24 (P24/!CS4!/SCK3); also elsewhere on the board
LED5: U$14.23 (P25/!CS5!/RXD3/SMISO3/SSCL3/!ADTRG0!); also elsewhere on the board
LED6/TDO: U$14.22 (TDO/P26/!CS6!/TXD1/!CTS3!/!RTS3!/SMOSI1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); also elsewhere on the board
LED7/TCK: U$14.21 (TCK/FINEC/P27/!CS7!/MTIOC2B/TMCI3/PO7/S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); also elsewhere on the board
LED_BLUE: U$14.33 (P13/TXD2/SMOSI2/SSDA2/SDA0[FM+]/IRQ3/!A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); also elsewhere on the board
LED_GREEN: U$14.31 (P15/RXD1/SCK3/SMISO1/SSCL1/CRX1-DS/IRQ5); also elsewhere on the board
LED_RED: U$14.29 (P17/SCK1/TXD3/SMOSI3/SSDA3/MISOA/SDA2-D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); also elsewhere on the board
MD: R5.1, U$14.7 (MD/FINED); also elsewhere on the board
MISOA: R9.2, U$14.45 (PC7/A23/!CS0!/TXD8/SMOSI8/SSDA8/MISOA/I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); also elsewhere on the board
MISOB: U$14.71 (PE7/D15[A15/D15]/MISOB/IRQ7/AN5); also elsewhere on the board
MOSIA: U$14.46 (PC6/A22/!CS1!/RXD8/SMISO8/SSCL8/MOSIA/I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); also elsewhere on the board
MOSIB: U$14.72 (PE6/D14[A14/D14]/MOSIB/IRQ6/AN4); also elsewhere on the board
unnamed: C4.2, U$14.5 (VCL)
NMI: R6.1, U$14.15 (P35/NMI)
OUT1_EN: U$14.55 (PB5/A13/SCK9); also elsewhere on the board
OUT2_EN: U$14.53 (PB7/A15/TXD9/SMOSI9/SSDA9); also elsewhere on the board
OUT3_EN: U$14.4 (PJ3/MTIOC3C/!CTS6!/!RTS6!/!CTS0!/!RTS0!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); also elsewhere on the board
OUT4_EN: U$14.41 (BCLK/P53); also elsewhere on the board
OUT5_EN: U$14.98 (P07/IRQ15/!ADTRG0); also elsewhere on the board
PGOOD1: U$14.49 (A19/TXD5/SMOSI5/SSDA5/IETXD); also elsewhere on the board
PGOOD2: U$14.50 (PC2/A18/RXD5/SMISO5/SSCL5/SSLA3/IERXD); also elsewhere on the board
PWM0: U$14.70 (PA0/A0/!BC0!/SSLA1); also elsewhere on the board
PWM1: U$14.66 (PA4/A4/TXD5/SMOSI5/SSDA5/SSLA0/IRQ5-DS); also elsewhere on the board
PWM2: U$14.64 (PA6/A6/!CTS5!/!RTS5!/!SS5!/MOSIA); also elsewhere on the board
PWM3: U$14.61 (PB0/A8/RXD6/SMISO6/SSCL6/RSPCKA/IRQ12); also elsewhere on the board
PWM4: U$14.56 (PB4/A12/!CTS9!/!RTS9!/!SS9!); also elsewhere on the board
PWM5: U$14.54 (PB6/A14/RXD9/SMISO9/SSCL9); also elsewhere on the board
RSPCKA: U$14.47 (PC5/A21/!CS2!/!WAIT!/SCK8/RSPCKA); also elsewhere on the board
RSPCKB: U$14.77 (PE1/D9[A9/D9]/TXD12/SMOSI12/SSDA12/TXDX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); also elsewhere on the board
SSLA0: U$14.48 (PC4/A20/!CS3!/SCK5/!CTS8!/!RTS8!/!SS8!/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); also elsewhere on the board
SSLB0: U$14.74 (PE4/D12[A12/D12]/SSLB0/AN2); also elsewhere on the board
SUPERCAP: U$14.6 (VBATT); also elsewhere on the board
USB0_DM: U$14.36 (USB0_DM); also elsewhere on the board
USB0_DP: R10.2, U$14.37 (USB0_DP); also elsewhere on the board
USB0_DPUPE: R10.1, U$14.32 (P14/!CTS1!/!RTS1!/!SS1!/CTX1/USB0_DPUPE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)
USB0_VBUS: U$14.30 (P16/TXD1/RXD3/SMOSI1/SMISO3/SSDA1/SSCL3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); also elsewhere on the board
VBAT0_AD: U$14.95 (P40/IRQ8-DS/AN000); also elsewhere on the board
VBAT1_AD: U$14.93 (P41/IRQ9-DS/AN001); also elsewhere on the board
VBAT2_AD: U$14.92 (P42/IRQ10-DS/AN002); also elsewhere on the board
VBAT3_AD: U$14.91 (P43/IRQ11-DS/AN003); also elsewhere on the board
XCIN: C9.2, Q1.1, U$14.8 (XCIN)
XCOUT: C11.2, Q1.4 (2), U$14.9 (XCOUT)
XTAL: C6.2, U$14.11 (XTAL/P37), X1.P$1

Notes on the sheet:
MCU
32kHz timer crystal
12MHz main crystal

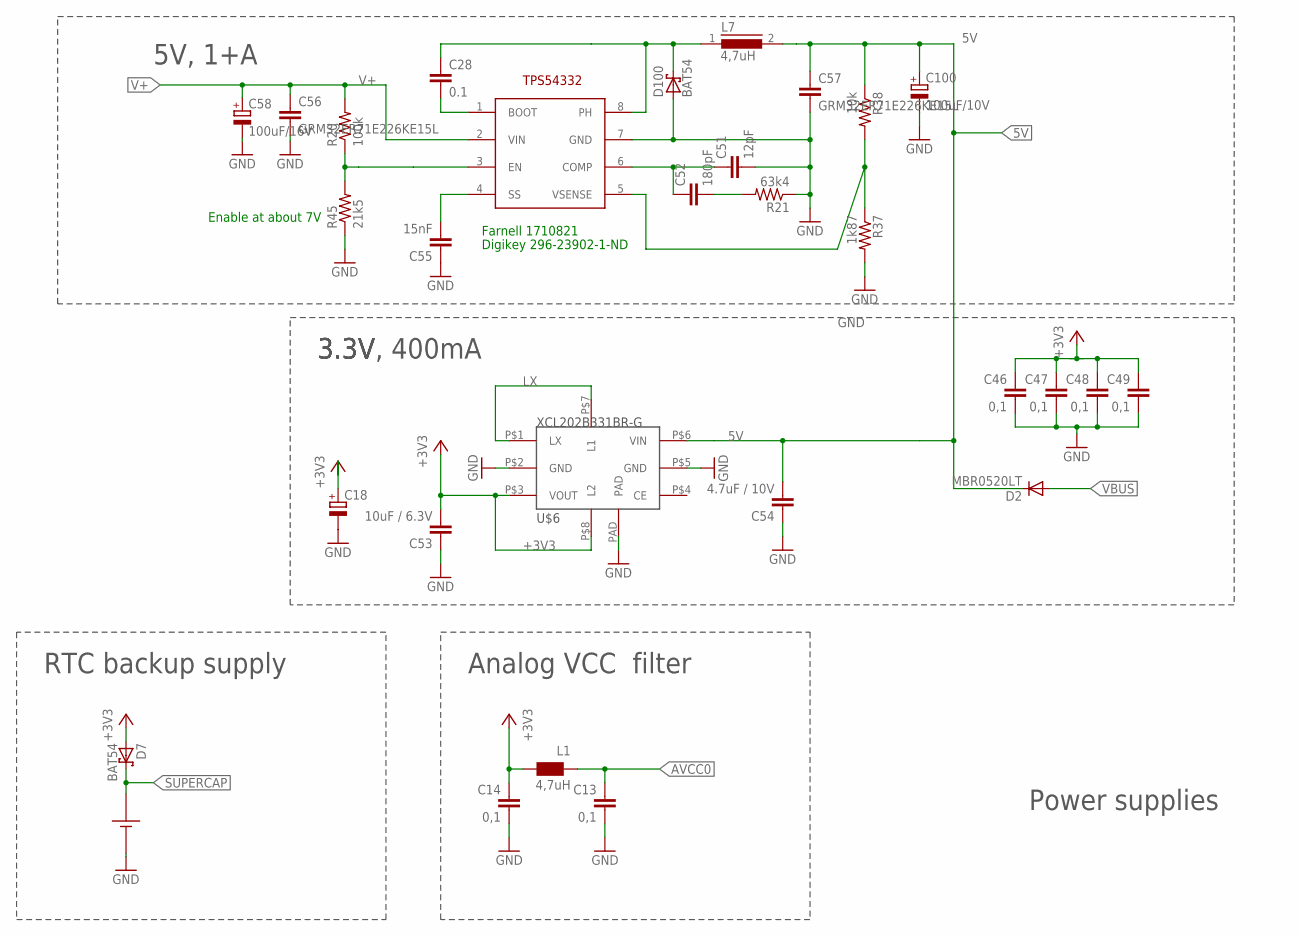
[picture p11: schematic kulgurpowerMCU3-unrouted.sch, sheet 3]

Parts:
C13, C14, C46, C47, C48, C49: 0,1; 0603-CAP
C18: CPOL-EUC/6032-28R; C/6032-28R
C28: 0.1; 0603-CAP
C51: 12pF; 0603-CAP
C52: 180pF; 0603-CAP
C53: 10uF / 6.3V; C0603
C54: 4.7uF / 10V; C0603
C55: 15nF; 0603-CAP
C56, C57: GRM32ER71E226KE15L; C1210
C58: 100uF/16V; C/6032-28R
C100: 100uF/10V; C/6032-28R
D2: MBR0520LT; SOD123
D7, D100: BAT54; SOT23
L1: 4,7uH; WE-KI_0805_B
L7: 4,7uH; DR73
R20: 100k; 0603-RES
R21: 63k4; 0603-RES
R37: 1k87; 0603-RES
R38: 10k; 0603-RES
R45: 21k5; 0603-RES
U$1: EDLRD224V3R6C
U$5: TPS54332; SO8
U$6: XCL202B331BR-G; CL2025

Connections:
5V: C54.2, C57.1, C100.+, D2.C, L7.2, R38.1, U$6.P$6 (VIN); also elsewhere on the board
+3V3: C14.1, C18.+, C46.1, C47.1, C48.1, C49.1, C53.2, D7.1 (A), L1.1 (2), U$6.P$3 (VOUT), U$6.P$8 (L2); also elsewhere on the board
AVCC0: C13.1, L1.2 (1); also elsewhere on the board
ENABLE_PANDA: R20.1, R45.2, U$5.3 (EN)
GND: C13.2, C14.2, C18.-, C46.2, C47.2, C48.2, C49.2, C51.2, C53.1, C54.1, C55.1, C56.2, C57.2, C58.-, C100.-, D100.1 (A), R21.1, R37.2, R45.1, U$1.N, U$5.7 (GND), U$6.P$2 (GND), U$6.P$5 (GND), U$6.PAD; also elsewhere on the board
LX: U$6.P$1 (LX), U$6.P$7 (L1)
unnamed: C55.2, U$5.4 (SS)
unnamed: C51.1, C52.1, U$5.6 (COMP)
unnamed: C52.2, R21.2
unnamed: C28.2, U$5.1 (BOOT)
unnamed: R37.1, R38.2, U$5.5 (VSENSE)
unnamed: C28.1, D100.3 (C), L7.1, U$5.8 (PH)
SUPERCAP: D7.3 (C), U$1.P; also elsewhere on the board
V+: C56.1, C58.+, R20.2, U$5.2 (VIN); also elsewhere on the board
VBUS: D2.A; also elsewhere on the board

Notes on the sheet:
Power supplies
3.3V
3.3V, 400mA
5V, 1+A
RTC backup supply
Analog VCC filter
Farnell 1710821
Digikey 296-23902-1-ND
Enable at about 7V

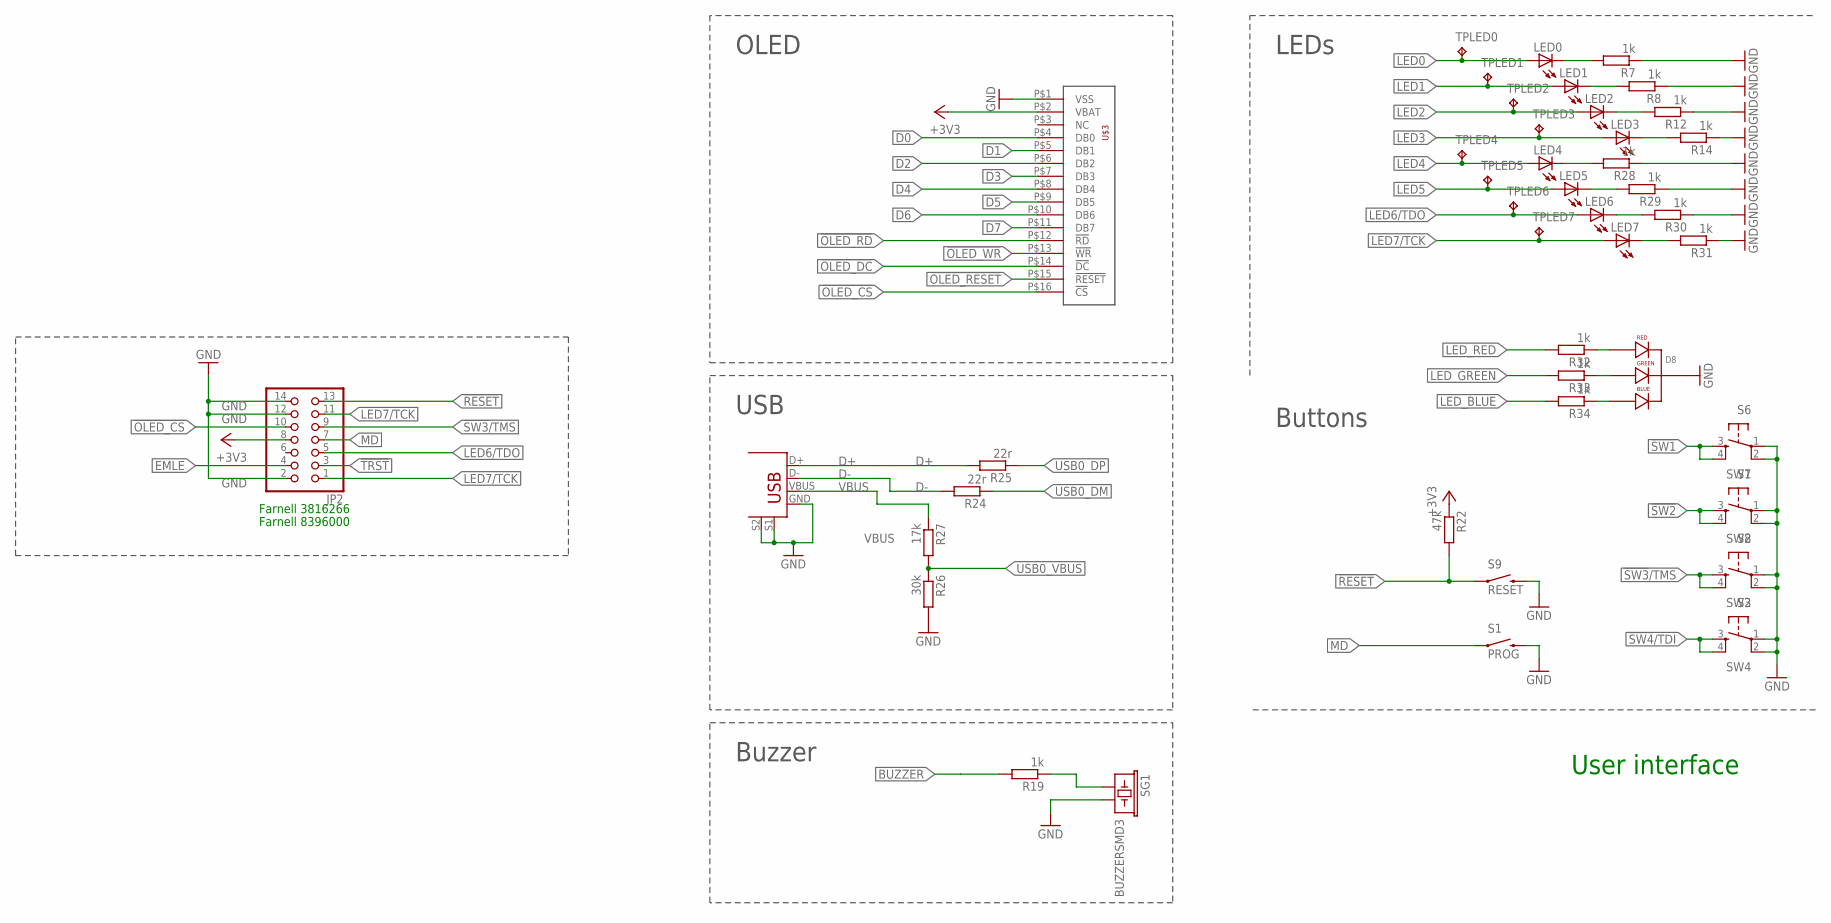
[picture p12: schematic kulgurpowerMCU3-unrouted.sch, sheet 4]

Parts:
D8: WP154A4SUREQBFZGW; LED-RGB-THRU
JP2: PINHD-2X7; 2X07
LED0, LED1, LED2, LED3, LED4, LED5, LED6, LED7: LED0603; LED-0603
R7, R8, R12, R14, R19, R28, R29, R30, R31, R32, R33, R34: 1k; R0603
R22: 47k; R0603
R24, R25: 22r; R0603
R26: 30k; R0603
R27: 17k; R0603
S1: PROG; TACTILE-PTH-SIDEEZ
S2: SW4; TACTILE-PTH
S6: SW1; TACTILE-PTH
S7: SW2; TACTILE-PTH
S8: SW3; TACTILE-PTH
S9: RESET; TACTILE-PTH-SIDEEZ
SG1: BUZZERSMD3; BUZZER-CMT1102
TPLED0, TPLED1, TPLED2, TPLED3, TPLED4, TPLED5, TPLED6, TPLED7: LED0; B1,27
U$2: USB+SHIELD; USB-B-PTH
U$3: ER-OLEDM032-1

Connections:
!OLED_CS: JP2.10, U$3.P$16 (!CS); also elsewhere on the board
!OLED_DC: U$3.P$14 (!DC); also elsewhere on the board
!OLED_RD: U$3.P$12 (!RD); also elsewhere on the board
!OLED_RESET: U$3.P$15 (!RESET); also elsewhere on the board
!OLED_WR: U$3.P$13 (!WR); also elsewhere on the board
!RESET: JP2.13, R22.2, S9.1; also elsewhere on the board
!SW1: S6.3, S6.4; also elsewhere on the board
!SW2: S7.3, S7.4; also elsewhere on the board
!SW3!/TMS: JP2.9, S8.3, S8.4; also elsewhere on the board
!SW4!/TDI: S2.3, S2.4; also elsewhere on the board
!TRST: JP2.3; also elsewhere on the board
+3V3: JP2.8, R22.1, U$3.P$2 (VBAT); also elsewhere on the board
BUZZER: R19.2; also elsewhere on the board
BUZZER_X: R19.1, SG1.1
D0: U$3.P$4 (DB0); also elsewhere on the board
D1: U$3.P$5 (DB1); also elsewhere on the board
D2: U$3.P$6 (DB2); also elsewhere on the board
D3: U$3.P$7 (DB3); also elsewhere on the board
D4: U$3.P$8 (DB4); also elsewhere on the board
D5: U$3.P$9 (DB5); also elsewhere on the board
D6: U$3.P$10 (DB6); also elsewhere on the board
D7: U$3.P$11 (DB7); also elsewhere on the board
D+: R25.2, U$2.D+
D-: R24.2, U$2.D-
EMLE: JP2.4; also elsewhere on the board
GND: D8.2 (CATHODE), JP2.2, JP2.12, JP2.14, R7.1, R8.1, R12.1, R14.1, R26.2, R28.1, R29.1, R30.1, R31.1, S1.2, S2.1, S2.2, S6.1, S6.2, S7.1, S7.2, S8.1, S8.2, S9.2, SG1.2, U$2.GND, U$2.S1, U$2.S2, U$3.P$1 (VSS); also elsewhere on the board
LED0: LED0.A, TPLED0.TP; also elsewhere on the board
LED1: LED1.A, TPLED1.TP; also elsewhere on the board
LED2: LED2.A, TPLED2.TP; also elsewhere on the board
LED3: LED3.A, TPLED3.TP; also elsewhere on the board
LED4: LED4.A, TPLED4.TP; also elsewhere on the board
LED5: LED5.A, TPLED5.TP; also elsewhere on the board
LED6/TDO: JP2.5, LED6.A, TPLED6.TP; also elsewhere on the board
LED7/TCK: JP2.1, JP2.11, LED7.A, TPLED7.TP; also elsewhere on the board
LED_BLUE: R34.2; also elsewhere on the board
LED_GREEN: R33.2; also elsewhere on the board
LED_RED: R32.2; also elsewhere on the board
MD: JP2.7, S1.1; also elsewhere on the board
unnamed: LED0.C, R7.2
unnamed: D8.1 (RED_CATHODE), R32.1
unnamed: LED1.C, R8.2
unnamed: LED2.C, R12.2
unnamed: LED3.C, R14.2
unnamed: LED4.C, R28.2
unnamed: LED5.C, R29.2
unnamed: LED6.C, R30.2
unnamed: LED7.C, R31.2
unnamed: D8.3 (GREEN_CATHODE), R33.1
unnamed: D8.4 (BLUE_CATHODE), R34.1
USB0_DM: R24.1; also elsewhere on the board
USB0_DP: R25.1; also elsewhere on the board
USB0_VBUS: R26.1, R27.2; also elsewhere on the board
VBUS: R27.1, U$2.VBUS; also elsewhere on the board

Notes on the sheet:
User interface
Farnell 8396000
Farnell 3816266
OLED
LEDs
Buttons
USB
Buzzer

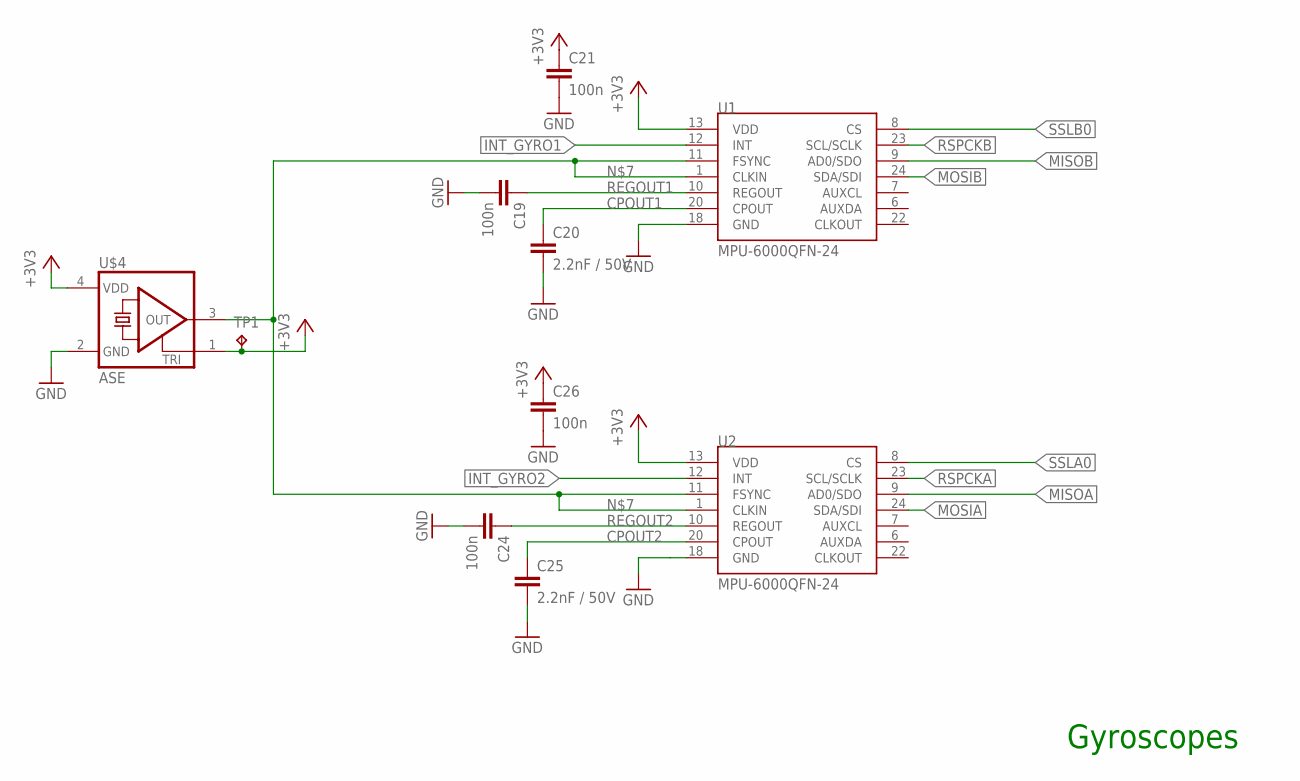
[picture p13: schematic kulgurpowerMCU3-unrouted.sch, sheet 5]

Parts:
C19, C21, C24, C26: 100n; C0603
C20, C25: 2.2nF / 50V; C0402
TP1: TPB1,27; B1,27
U1, U2: MPU-6000QFN-24; QFN-24-TESTING
U$4: ASE

Connections:
+3V3: C21.1, C26.1, TP1.TP, U1.13 (VDD), U2.13 (VDD), U$4.1 (TRI), U$4.4 (VDD); also elsewhere on the board
CPOUT1: C20.1, U1.20 (CPOUT)
CPOUT2: C25.1, U2.20 (CPOUT)
GND: C19.2, C20.2, C21.2, C24.2, C25.2, C26.2, U1.18 (GND), U2.18 (GND), U$4.2 (GND); also elsewhere on the board
INT_GYRO1: U1.12 (INT); also elsewhere on the board
INT_GYRO2: U2.12 (INT); also elsewhere on the board
MISOA: U2.9 (AD0/SDO); also elsewhere on the board
MISOB: U1.9 (AD0/SDO); also elsewhere on the board
MOSIA: U2.24 (SDA/SDI); also elsewhere on the board
MOSIB: U1.24 (SDA/SDI); also elsewhere on the board
unnamed: U1.1 (CLKIN), U1.11 (FSYNC), U2.1 (CLKIN), U2.11 (FSYNC), U$4.3 (OUT)
REGOUT1: C19.1, U1.10 (REGOUT)
REGOUT2: C24.1, U2.10 (REGOUT)
RSPCKA: U2.23 (SCL/SCLK); also elsewhere on the board
RSPCKB: U1.23 (SCL/SCLK); also elsewhere on the board
SSLA0: U2.8 (CS); also elsewhere on the board
SSLB0: U1.8 (CS); also elsewhere on the board

Notes on the sheet:
Gyroscopes

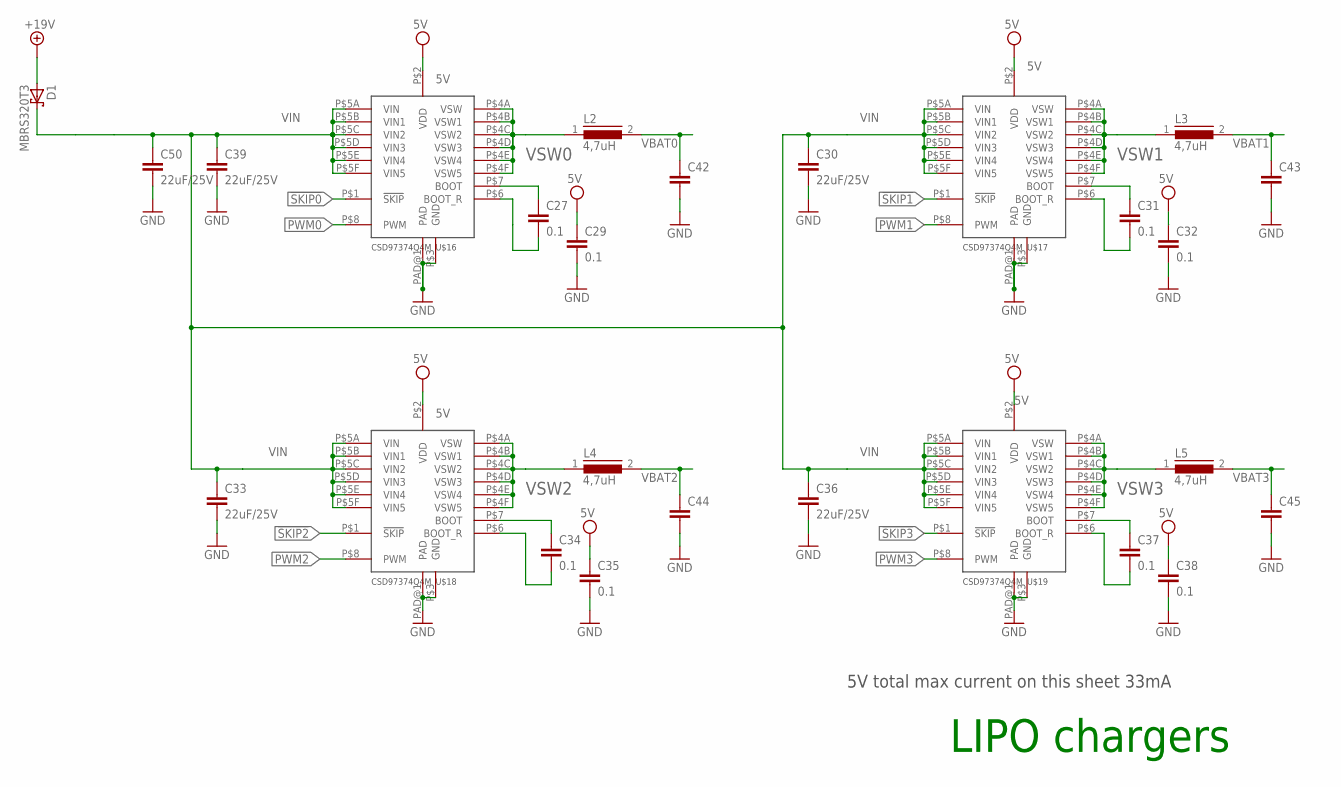
[picture p14: schematic kulgurpowerMCU3-unrouted.sch, sheet 6]

Parts:
C27, C29, C31, C32, C34, C35, C37, C38: 0.1; C0603
C30, C33, C36, C39, C50: 22uF/25V; C1210
C42, C43, C44, C45: C-EUC1210; C1210
D1: MBRS320T3; SMC
L2, L3, L4, L5: 4,7uH; DR73
U$16, U$17, U$18, U$19: CSD97374Q4M

Connections:
5V: C29.1, C32.1, C35.1, C38.1, U$16.P$2 (VDD), U$17.P$2 (VDD), U$18.P$2 (VDD), U$19.P$2 (VDD); also elsewhere on the board
!SKIP0: U$16.P$1 (!SKIP); also elsewhere on the board
!SKIP1: U$17.P$1 (!SKIP); also elsewhere on the board
!SKIP2: U$18.P$1 (!SKIP); also elsewhere on the board
!SKIP3: U$19.P$1 (!SKIP); also elsewhere on the board
+19V: D1.A; also elsewhere on the board
GND: C29.2, C30.2, C32.2, C33.2, C35.2, C36.2, C38.2, C39.2, C42.2, C43.2, C44.2, C45.2, C50.2, U$16.P$3 (GND), U$16.PAD@1 (PAD), U$17.P$3 (GND), U$17.PAD@1 (PAD), U$18.P$3 (GND), U$18.PAD@1 (PAD), U$19.P$3 (GND), U$19.PAD@1 (PAD); also elsewhere on the board
unnamed: C37.1, U$19.P$7 (BOOT)
unnamed: C31.1, U$17.P$7 (BOOT)
unnamed: C37.2, U$19.P$6 (BOOT_R)
unnamed: C31.2, U$17.P$6 (BOOT_R)
unnamed: C27.1, U$16.P$7 (BOOT)
unnamed: C27.2, U$16.P$6 (BOOT_R)
unnamed: C34.1, U$18.P$7 (BOOT)
unnamed: C34.2, U$18.P$6 (BOOT_R)
PWM0: U$16.P$8 (PWM); also elsewhere on the board
PWM1: U$17.P$8 (PWM); also elsewhere on the board
PWM2: U$18.P$8 (PWM); also elsewhere on the board
PWM3: U$19.P$8 (PWM); also elsewhere on the board
VBAT0: C42.1, L2.2; also elsewhere on the board
VBAT1: C43.1, L3.2; also elsewhere on the board
VBAT2: C44.1, L4.2; also elsewhere on the board
VBAT3: C45.1, L5.2; also elsewhere on the board
VIN: C30.1, C33.1, C36.1, C39.1, C50.1, D1.C, U$16.P$5A (VIN), U$16.P$5B (VIN1), U$16.P$5C (VIN2), U$16.P$5D (VIN3), U$16.P$5E (VIN4), U$16.P$5F (VIN5), U$17.P$5A (VIN), U$17.P$5B (VIN1), U$17.P$5C (VIN2), U$17.P$5D (VIN3), U$17.P$5E (VIN4), U$17.P$5F (VIN5), U$18.P$5A (VIN), U$18.P$5B (VIN1), U$18.P$5C (VIN2), U$18.P$5D (VIN3), U$18.P$5E (VIN4), U$18.P$5F (VIN5), U$19.P$5A (VIN), U$19.P$5B (VIN1), U$19.P$5C (VIN2), U$19.P$5D (VIN3), U$19.P$5E (VIN4), U$19.P$5F (VIN5)
VSW0: L2.1, U$16.P$4A (VSW), U$16.P$4B (VSW1), U$16.P$4C (VSW2), U$16.P$4D (VSW3), U$16.P$4E (VSW4), U$16.P$4F (VSW5)
VSW1: L3.1, U$17.P$4A (VSW), U$17.P$4B (VSW1), U$17.P$4C (VSW2), U$17.P$4D (VSW3), U$17.P$4E (VSW4), U$17.P$4F (VSW5)
VSW2: L4.1, U$18.P$4A (VSW), U$18.P$4B (VSW1), U$18.P$4C (VSW2), U$18.P$4D (VSW3), U$18.P$4E (VSW4), U$18.P$4F (VSW5)
VSW3: L5.1, U$19.P$4A (VSW), U$19.P$4B (VSW1), U$19.P$4C (VSW2), U$19.P$4D (VSW3), U$19.P$4E (VSW4), U$19.P$4F (VSW5)

Notes on the sheet:
LIPO chargers
5V total max current on this sheet 33mA

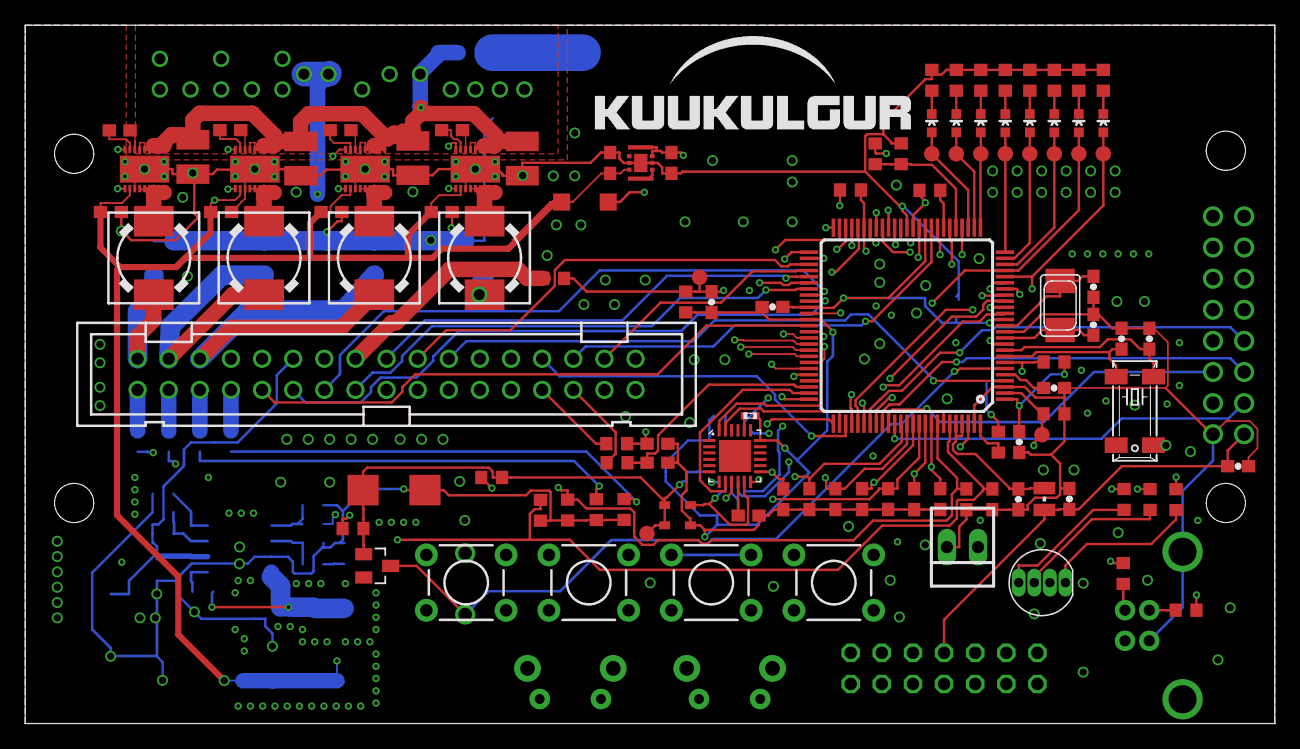
[picture p15: board kulgurpowerMCU3-unrouted.brd from above]

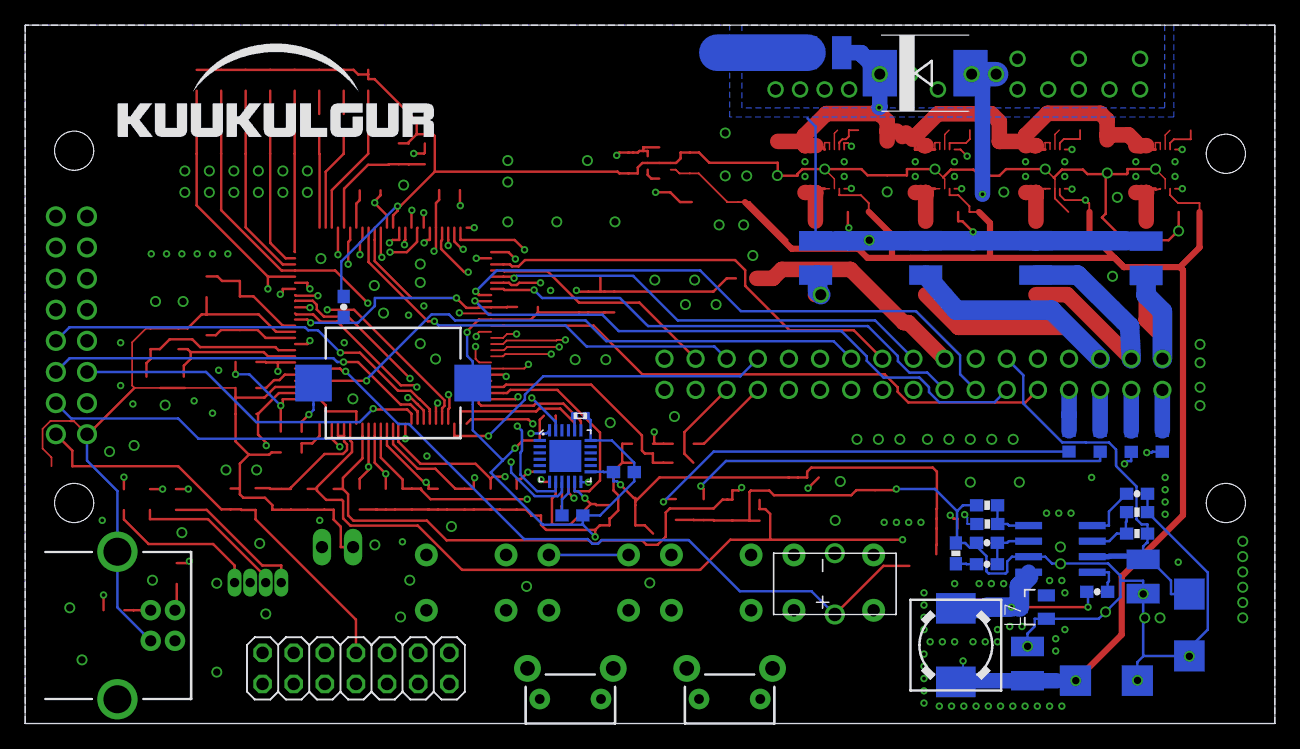
[picture p16: board kulgurpowerMCU3-unrouted.brd from below]

Board: 4 copper layers, 102.0 x 57.0 mm, 150 parts (37 on the bottom side), 141 nets.
