tonuonu/NASA-Sample-Return-Robot/SPI-Gyro-shield/Hardware/Arduino_kuukulgur-alternatiivne3.brd

## EAGLE design SPI-Gyro-shield/Hardware/Arduino_kuukulgur-alternatiivne3.brd (2014-04-11)

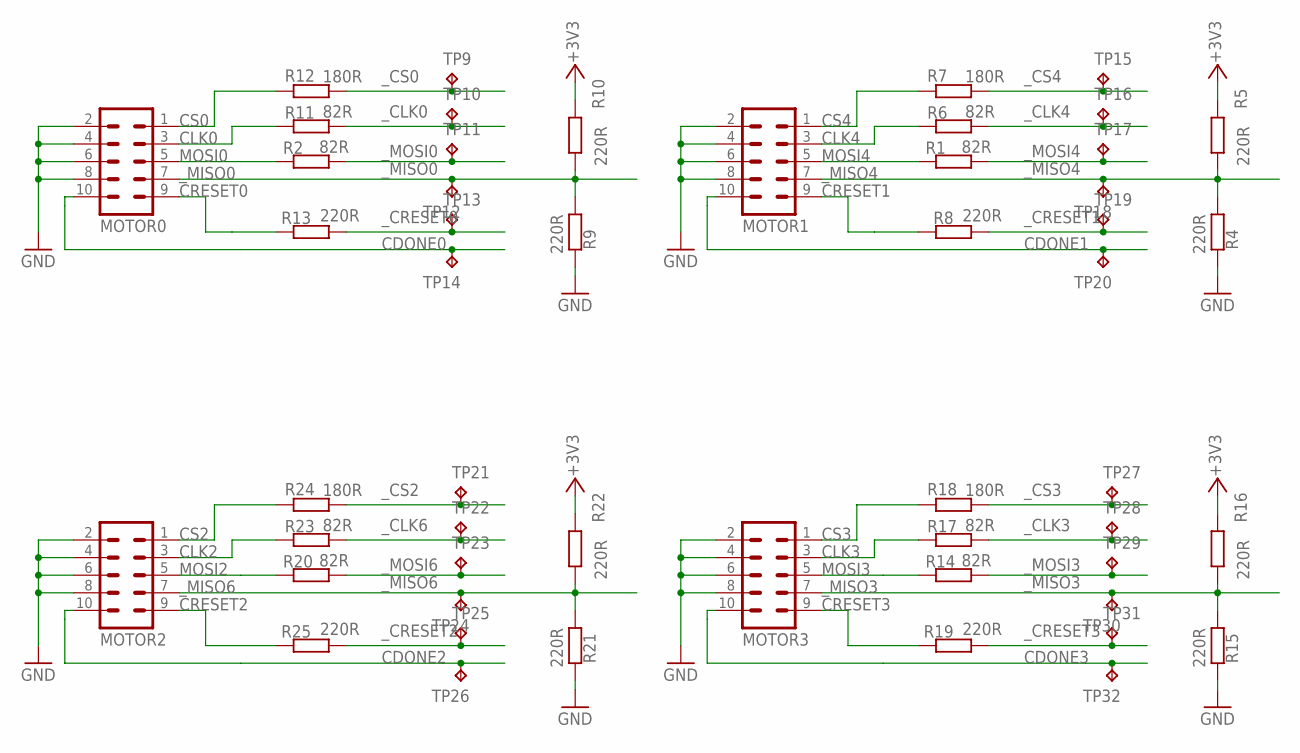
[picture p17: schematic Arduino_kuukulgur-alternatiivne3.sch, sheet 1]

Parts:
MOTOR0, MOTOR1, MOTOR2, MOTOR3: MA05-2
R1, R2, R6, R11, R14, R17, R20, R23: 82R; R0603-ROUND
R4, R5, R8, R9, R10, R13, R15, R16, R19, R21, R22, R25: 220R; R0603-ROUND
R7, R12, R18, R24: 180R; R0603-ROUND
TP9, TP10, TP11, TP12, TP13, TP14, TP15, TP16, TP17, TP18, TP19, TP20, TP21, TP22, TP23, TP24, TP25, TP26, TP27, TP28, TP29, TP30, TP31, TP32: TPB1,27; B1,27

Connections:
+4V5: R5.1, R10.1, R16.1, R22.1; also elsewhere on the board
CDONE0: MOTOR0.10, TP14.TP; also elsewhere on the board
CDONE1: MOTOR1.10, TP20.TP; also elsewhere on the board
CDONE2: MOTOR2.10, TP26.TP; also elsewhere on the board
CDONE3: MOTOR3.10, TP32.TP; also elsewhere on the board
CLK0: MOTOR0.3, R11.2
CLK2: MOTOR2.3, R23.2
CLK3: MOTOR3.3, R17.2
CLK4: MOTOR1.3, R6.2
CRESET0: MOTOR0.9, R13.1
CRESET1: MOTOR1.9, R8.1
CRESET2: MOTOR2.9, R25.1
CRESET3: MOTOR3.9, R19.1
CS0: MOTOR0.1, R12.2
CS2: MOTOR2.1, R24.2
CS3: MOTOR3.1, R18.2
CS4: MOTOR1.1, R7.2
GND: MOTOR0.2, MOTOR0.4, MOTOR0.6, MOTOR0.8, MOTOR1.2, MOTOR1.4, MOTOR1.6, MOTOR1.8, MOTOR2.2, MOTOR2.4, MOTOR2.6, MOTOR2.8, MOTOR3.2, MOTOR3.4, MOTOR3.6, MOTOR3.8, R4.2, R9.2, R15.2, R21.2; also elsewhere on the board
MOSI0: MOTOR0.5, R2.2
MOSI2: MOTOR2.5, R20.2
MOSI3: MOTOR3.5, R14.2
MOSI4: MOTOR1.5, R1.2
_CLK0: R11.1, TP10.TP; also elsewhere on the board
_CLK3: R17.1, TP28.TP; also elsewhere on the board
_CLK4: R6.1, TP16.TP; also elsewhere on the board
_CLK6: R23.1, TP22.TP; also elsewhere on the board
_CRESET0: R13.2, TP13.TP; also elsewhere on the board
_CRESET1: R8.2, TP19.TP; also elsewhere on the board
_CRESET2: R25.2, TP25.TP; also elsewhere on the board
_CRESET3: R19.2, TP31.TP; also elsewhere on the board
_CS0: R12.1, TP9.TP; also elsewhere on the board
_CS2: R24.1, TP21.TP; also elsewhere on the board
_CS3: R18.1, TP27.TP; also elsewhere on the board
_CS4: R7.1, TP15.TP; also elsewhere on the board
_MISO0: MOTOR0.7, R9.1, R10.2, TP12.TP; also elsewhere on the board
_MISO3: MOTOR3.7, R15.1, R16.2, TP30.TP; also elsewhere on the board
_MISO4: MOTOR1.7, R4.1, R5.2, TP18.TP; also elsewhere on the board
_MISO6: MOTOR2.7, R21.1, R22.2, TP24.TP
_MOSI0: R2.1, TP11.TP; also elsewhere on the board
_MOSI3: R14.1, TP29.TP; also elsewhere on the board
_MOSI4: R1.1, TP17.TP; also elsewhere on the board
_MOSI6: R20.1, TP23.TP; also elsewhere on the board
