tonuonu/NASA-Sample-Return-Robot/SPI-Gyro-shield/Hardware/Arduino_kuukulgur-alternatiivne3.brd

## EAGLE design SPI-Gyro-shield/Hardware/Arduino_kuukulgur-alternatiivne3.brd (continued)

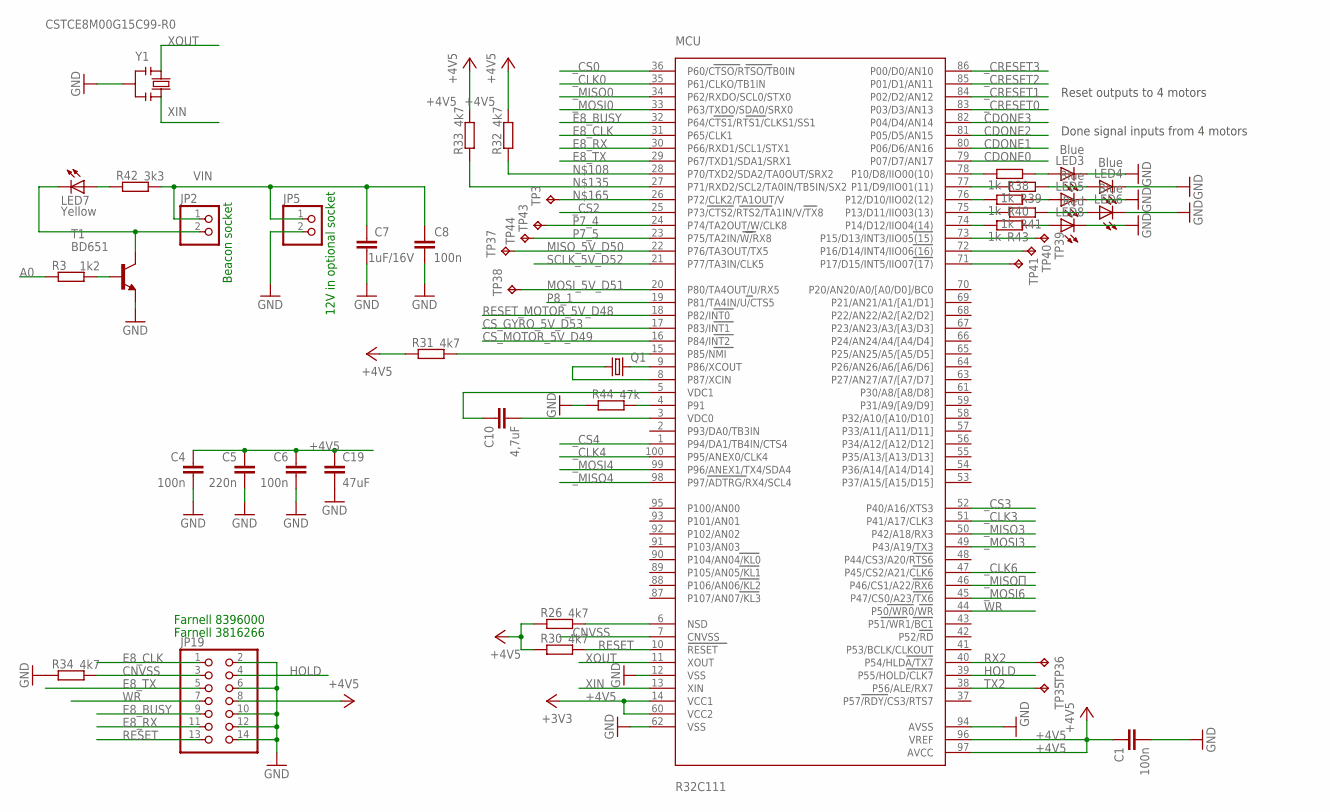
[picture p18: schematic Arduino_kuukulgur-alternatiivne3.sch, sheet 2]

Parts:
C1, C4, C6, C8: 100n; C0603-ROUND
C5: 220n; C0603-ROUND
C7: 1uF/16V; C0805
C10: 4,7uF; C0603-ROUND
C19: 47uF; C0805
JP2, JP5: PINHD-1X2; 1X02
JP19: PINHD-2X7; 2X07
LED3, LED4, LED5, LED6: Blue; CHIP-LED0603
LED7: Yellow; CHIP-LED0603
LED8: Red; CHIP-LED0603
MCU: R32C111; 100P6Q-A
Q1: CRYSTALMM20SS; MM20SS
R3: 1k2; R0603-ROUND
R26, R30, R31, R32, R33, R34: 4k7; R0603-ROUND
R38, R39, R40, R41, R43: 1k; R0603-ROUND
R42: 3k3; R0603-ROUND
R44: 47k; R0603-ROUND
T1: BD651; TO220
TP3, TP35, TP36, TP37, TP38, TP39, TP40, TP41, TP43, TP44: TPB1,27; B1,27
Y1: CSTCE8M00G15C99-R0; RESONATOR

Connections:
+4V5: C1.1, C4.1, C5.1, C6.1, C19.1, JP19.8, MCU.14 (VCC1), MCU.60 (VCC2), MCU.96 (VREF), MCU.97 (AVCC), R26.2, R30.2, R31.2, R32.1, R33.1; also elsewhere on the board
A0: R3.2; also elsewhere on the board
CDONE0: MCU.79 (P07/D7/AN17); also elsewhere on the board
CDONE1: MCU.80 (P06/D6/AN16); also elsewhere on the board
CDONE2: MCU.81 (P05/D5/AN15); also elsewhere on the board
CDONE3: MCU.82 (P04/D4/AN14); also elsewhere on the board
CNVSS: JP19.3, MCU.7 (CNVSS), R34.1
CS_GYRO_5V_D53: MCU.17 (P83/INT1); also elsewhere on the board
CS_MOTOR_5V_D49: MCU.16 (P84/INT2); also elsewhere on the board
E8_BUSY: JP19.9, MCU.32 (P64/CTS1/RTS1/CLKS1/SS1); also elsewhere on the board
E8_CLK: JP19.1, MCU.31 (P65/CLK1)
E8_RX: JP19.11, MCU.30 (P66/RXD1/SCL1/STX1); also elsewhere on the board
E8_TX: JP19.5, MCU.29 (P67/TXD1/SDA1/SRX1); also elsewhere on the board
GND: C1.2, C4.2, C5.2, C6.2, C7.2, C8.2, C19.2, JP5.2, JP19.2, JP19.6, JP19.10, JP19.12, JP19.14, LED3.C, LED4.C, LED5.C, LED6.C, LED8.C, MCU.12 (VSS), MCU.62 (VSS), MCU.94 (AVSS), R34.2, R44.2, T1.1 (E), Y1.2; also elsewhere on the board
HOLD: JP19.4, MCU.39 (P55/HOLD/CLK7)
MISO_5V_D50: MCU.22 (P76/TA3OUT/TX5), TP37.TP; also elsewhere on the board
MOSI_5V_D51: MCU.20 (P80/TA4OUT/U/RX5), TP38.TP; also elsewhere on the board
unnamed: C10.1, MCU.5 (VDC1)
unnamed: JP2.2, LED7.C, T1.2 (C)
unnamed: MCU.4 (P91), R44.1
unnamed: C10.2, MCU.3 (VDC0)
unnamed: R3.1, T1.3 (B)
unnamed: MCU.9 (P86/XCOUT), Q1.4 (2)
unnamed: MCU.8 (P87/XCIN), Q1.1
unnamed: MCU.6 (NSD), R26.1
unnamed: MCU.15 (P85/NMI), R31.1
unnamed: LED7.A, R42.2
unnamed: LED3.A, R38.2
unnamed: MCU.28 (P70/TXD2/SDA2/TA0OUT/SRX2), R32.2
unnamed: MCU.27 (P71/RXD2/SCL2/TA0IN/TB5IN/SX2), R33.2
unnamed: LED4.A, R39.2
unnamed: LED5.A, R40.2
unnamed: LED6.A, R41.2
unnamed: MCU.26 (P72/CLK2/TA1OUT/V), TP3.TP
unnamed: LED8.A, R43.2
P1_0: MCU.78 (P10/D8/IIO00(10)), R38.1
P1_1: MCU.77 (P11/D9/IIO01(11)), R39.1
P1_2: MCU.76 (P12/D10/IIO02(12)), R40.1
P1_3: MCU.75 (P13/D11/IIO03(13)), R41.1
P1_4: MCU.74 (P14/D12/IIO04(14)), R43.1
P1_5: MCU.73 (P15/D13/INT3/IIO05(15)), TP39.TP
P1_6: MCU.72 (P16/D14/INT4/IIO06(16)), TP40.TP
P1_7: MCU.71 (P17/D15/INT5/IIO07(17)), TP41.TP
P7_4: MCU.24 (P74/TA2OUT/W/CLK8), TP43.TP
P7_5: MCU.23 (P75/TA2IN/W/RX8), TP44.TP
P8_1: MCU.19 (P81/TA4IN/U/CTS5)
RESET: JP19.13, MCU.10 (RESET), R30.1; also elsewhere on the board
RESET_MOTOR_5V_D48: MCU.18 (P82/INT0); also elsewhere on the board
RX2: MCU.40 (P54/HLDA/TX7), TP36.TP; also elsewhere on the board
SCLK_5V_D52: MCU.21 (P77/TA3IN/CLK5); also elsewhere on the board
TX2: MCU.38 (P56/ALE/RX7), TP35.TP; also elsewhere on the board
VIN: C7.1, C8.1, JP2.1, JP5.1, R42.1; also elsewhere on the board
WR: JP19.7, MCU.44 (P50/WR0/WR)
XIN: MCU.13 (XIN), Y1.3
XOUT: MCU.11 (XOUT), Y1.1
_CLK0: MCU.35 (P61/CLKO/TB1IN); also elsewhere on the board
_CLK3: MCU.51 (P41/A17/CLK3); also elsewhere on the board
_CLK4: MCU.100 (P95/ANEX0/CLK4); also elsewhere on the board
_CLK6: MCU.47 (P45/CS2/A21/CLK6); also elsewhere on the board
_CRESET0: MCU.83 (P03/D3/AN13); also elsewhere on the board
_CRESET1: MCU.84 (P02/D2/AN12); also elsewhere on the board
_CRESET2: MCU.85 (P01/D1/AN11); also elsewhere on the board
_CRESET3: MCU.86 (P00/D0/AN10); also elsewhere on the board
_CS0: MCU.36 (P60/CTSO/RTSO/TB0IN); also elsewhere on the board
_CS2: MCU.25 (P73/CTS2/RTS2/TA1IN/V/TX8); also elsewhere on the board
_CS3: MCU.52 (P40/A16/XTS3); also elsewhere on the board
_CS4: MCU.1 (P94/DA1/TB4IN/CTS4); also elsewhere on the board
_MISO0: MCU.34 (P62/RXDO/SCL0/STX0); also elsewhere on the board
_MISO3: MCU.50 (P42/A18/RX3); also elsewhere on the board
_MISO4: MCU.98 (P97/ADTRG/RX4/SCL4); also elsewhere on the board
_MISO６: MCU.46 (P46/CS1/A22/RX6)
_MOSI0: MCU.33 (P63/TXDO/SDA0/SRX0); also elsewhere on the board
_MOSI3: MCU.49 (P43/A19/TX3); also elsewhere on the board
_MOSI4: MCU.99 (P96/ANEX1/TX4/SDA4); also elsewhere on the board
_MOSI6: MCU.45 (P47/CS0/A23/TX6); also elsewhere on the board

Notes on the sheet:
Farnell 8396000
Farnell 3816266
Beacon socket
12V in optional socket
Reset outputs to 4 motors
Done signal inputs from 4 motors

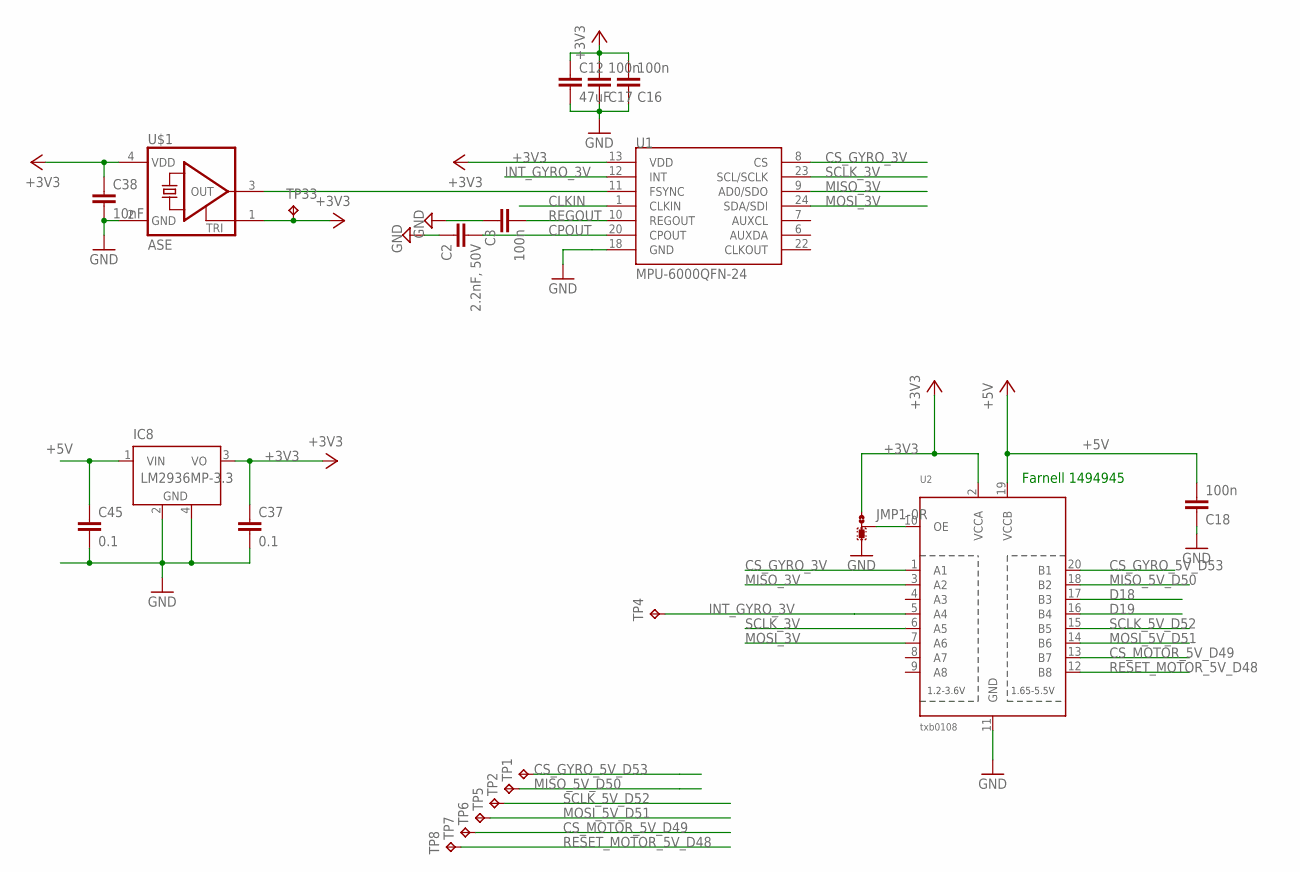
[picture p19: schematic Arduino_kuukulgur-alternatiivne3.sch, sheet 3]

Parts:
C2: 2.2nF, 50V; C0603-ROUND
C3, C16, C17, C18: 100n; C0603-ROUND
C12: 47uF; C0805
C37, C45: 0.1; 0603-CAP
C38: 10nF; C0603
IC8: LM2936MP-3.3; SOT223
JMP1: 0R-JUMPB; B0R-JMP
TP1, TP2, TP4, TP5, TP6, TP7, TP8, TP33: TPB1,27; B1,27
U1: MPU-6000QFN-24; QFN-24-TESTING
U2: txb0108; TSSOP20
U$1: ASE

Connections:
+3V3: C12.1, C16.2, C17.2, C37.1, C38.1, IC8.3 (VO), JMP1.1, TP33.TP, U1.13 (VDD), U2.2 (VCCA), U$1.1 (TRI), U$1.4 (VDD); also elsewhere on the board
+5V: C18.2, C45.1, IC8.1 (VIN), U2.19 (VCCB); also elsewhere on the board
CLKIN: U1.1 (CLKIN)
CPOUT: C2.2, U1.20 (CPOUT)
CS_GYRO_3V: U1.8 (CS), U2.1 (A1)
CS_GYRO_5V_D53: TP1.TP, U2.20 (B1); also elsewhere on the board
CS_MOTOR_5V_D49: TP7.TP, U2.13 (B7); also elsewhere on the board
D18: U2.17 (B3); also elsewhere on the board
D19: U2.16 (B4); also elsewhere on the board
GND: C2.1, C3.1, C12.2, C16.1, C17.1, C18.1, C37.2, C38.2, C45.2, IC8.2 (GND), IC8.4 (GND), JMP1.3, U1.18 (GND), U2.11 (GND), U$1.2 (GND); also elsewhere on the board
INT_GYRO_3V: TP4.TP, U1.12 (INT), U2.5 (A4)
MISO_3V: U1.9 (AD0/SDO), U2.3 (A2)
MISO_5V_D50: TP2.TP, U2.18 (B2); also elsewhere on the board
MOSI_3V: U1.24 (SDA/SDI), U2.7 (A6)
MOSI_5V_D51: TP6.TP, U2.14 (B6); also elsewhere on the board
unnamed: JMP1.2, U2.10 (OE)
unnamed: U1.11 (FSYNC), U$1.3 (OUT)
REGOUT: C3.2, U1.10 (REGOUT)
RESET_MOTOR_5V_D48: TP8.TP, U2.12 (B8); also elsewhere on the board
SCLK_3V: U1.23 (SCL/SCLK), U2.6 (A5)
SCLK_5V_D52: TP5.TP, U2.15 (B5); also elsewhere on the board

Notes on the sheet:
Farnell 1494945

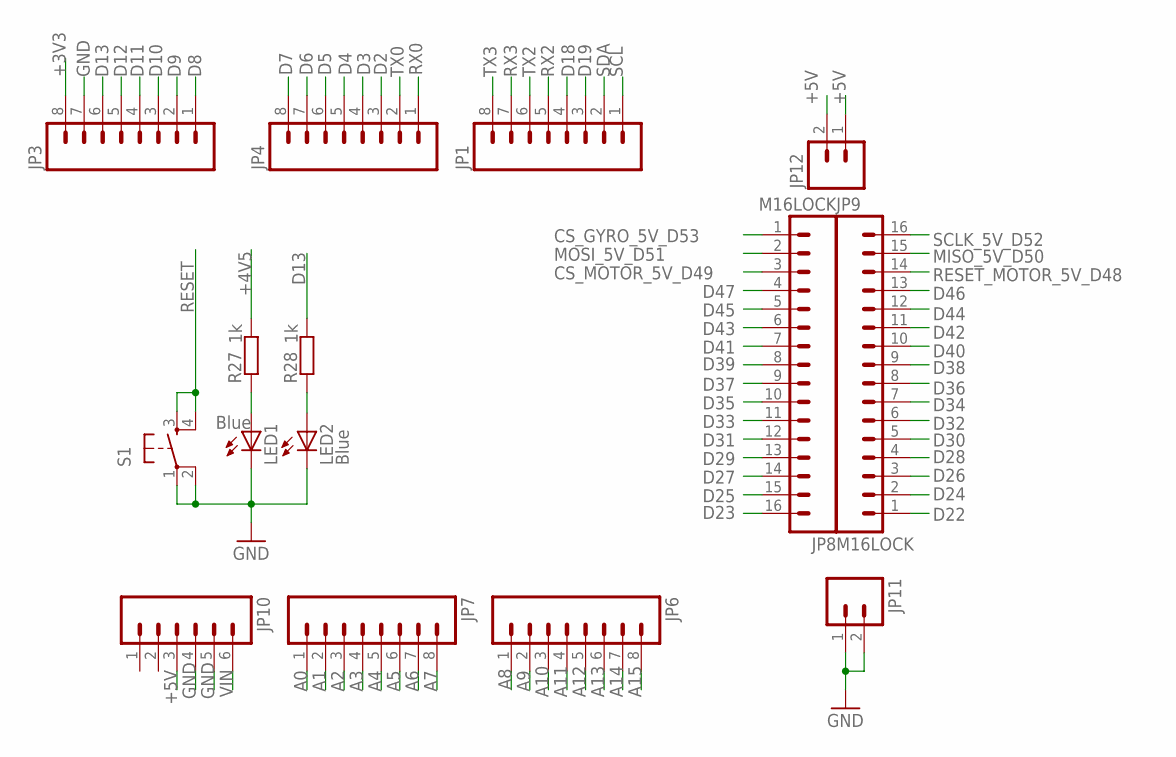
[picture p20: schematic Arduino_kuukulgur-alternatiivne3.sch, sheet 4]

Parts:
JP1, JP3, JP4, JP6, JP7: M08LOCK; 1X08_LOCK
JP8, JP9: M16LOCK; 1X16_LOCK
JP10: M06LOCK; 1X06_LOCK
JP11, JP12: M02LOCK; 1X02_LOCK
LED1, LED2: Blue; CHIP-LED0603
R27, R28: 1k; R0603-ROUND
S1: TAC_SWITCHPTH; TACTILE-PTH

Connections:
+3V3: JP3.8; also elsewhere on the board
+4V5: R27.1; also elsewhere on the board
+5V: JP10.3, JP12.1, JP12.2; also elsewhere on the board
A0: JP7.1; also elsewhere on the board
A1: JP7.2
A2: JP7.3; also elsewhere on the board
A3: JP7.4; also elsewhere on the board
A4: JP7.5; also elsewhere on the board
A5: JP7.6; also elsewhere on the board
A6: JP7.7; also elsewhere on the board
A7: JP7.8; also elsewhere on the board
A8: JP6.1
A9: JP6.2
A10: JP6.3
A11: JP6.4
A12: JP6.5
A13: JP6.6
A14: JP6.7
A15: JP6.8
CS_GYRO_5V_D53: JP8.1; also elsewhere on the board
CS_MOTOR_5V_D49: JP8.3; also elsewhere on the board
D2: JP4.3; also elsewhere on the board
D3: JP4.4; also elsewhere on the board
D4: JP4.5; also elsewhere on the board
D5: JP4.6; also elsewhere on the board
D6: JP4.7; also elsewhere on the board
D7: JP4.8; also elsewhere on the board
D8: JP3.1; also elsewhere on the board
D9: JP3.2; also elsewhere on the board
D10: JP3.3; also elsewhere on the board
D11: JP3.4; also elsewhere on the board
D12: JP3.5; also elsewhere on the board
D13: JP3.6, R28.1
D18: JP1.4; also elsewhere on the board
D19: JP1.3; also elsewhere on the board
D22: JP9.1
D23: JP8.16
D24: JP9.2
D25: JP8.15
D26: JP9.3
D27: JP8.14
D28: JP9.4
D29: JP8.13
D30: JP9.5
D31: JP8.12
D32: JP9.6
D33: JP8.11
D34: JP9.7
D35: JP8.10
D36: JP9.8
D37: JP8.9
D38: JP9.9
D39: JP8.8
D40: JP9.10
D41: JP8.7
D42: JP9.11
D43: JP8.6; also elsewhere on the board
D44: JP9.12; also elsewhere on the board
D45: JP8.5; also elsewhere on the board
D46: JP9.13; also elsewhere on the board
D47: JP8.4; also elsewhere on the board
GND: JP3.7, JP10.4, JP10.5, JP11.1, JP11.2, LED1.C, LED2.C, S1.1, S1.2; also elsewhere on the board
MISO_5V_D50: JP9.15; also elsewhere on the board
MOSI_5V_D51: JP8.2; also elsewhere on the board
unnamed: LED1.A, R27.2
unnamed: LED2.A, R28.2
RESET: S1.3, S1.4; also elsewhere on the board
RESET_MOTOR_5V_D48: JP9.14; also elsewhere on the board
RX0: JP4.1
RX2: JP1.5; also elsewhere on the board
RX3: JP1.7
SCL: JP1.1
SCLK_5V_D52: JP9.16; also elsewhere on the board
SDA: JP1.2
TX0: JP4.2
TX2: JP1.6; also elsewhere on the board
TX3: JP1.8
VIN: JP10.6; also elsewhere on the board

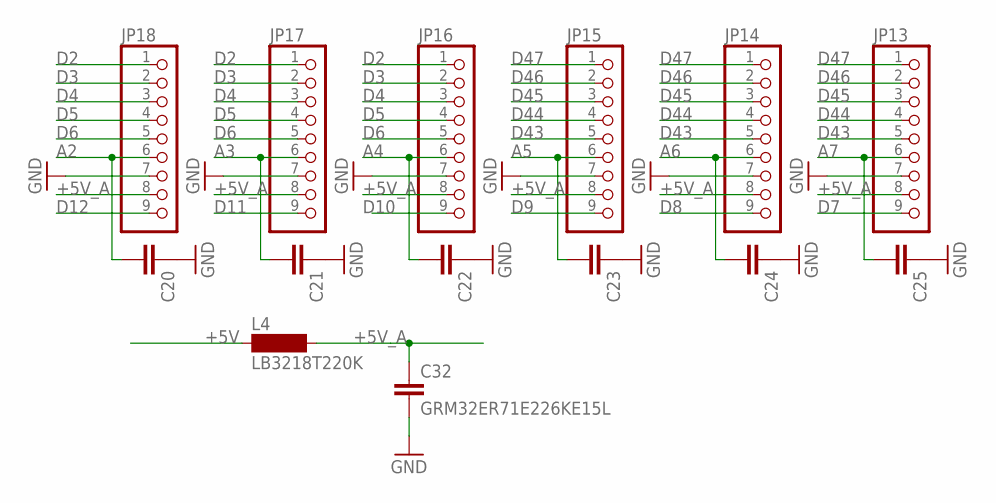
[picture p21: schematic Arduino_kuukulgur-alternatiivne3.sch, sheet 5]

Parts:
C20, C21, C22, C23, C24, C25: C-EUC0603; C0603
C32: GRM32ER71E226KE15L; C1210
JP13, JP14, JP15, JP16, JP17, JP18: PINHD-1X9; 1X09
L4: LB3218T220K; SM-1206

Connections:
+5V: L4.1; also elsewhere on the board
+5V_A: C32.1, JP13.8, JP14.8, JP15.8, JP16.8, JP17.8, JP18.8, L4.2
A2: C20.2, JP18.6; also elsewhere on the board
A3: C21.2, JP17.6; also elsewhere on the board
A4: C22.2, JP16.6; also elsewhere on the board
A5: C23.2, JP15.6; also elsewhere on the board
A6: C24.2, JP14.6; also elsewhere on the board
A7: C25.2, JP13.6; also elsewhere on the board
D2: JP16.1, JP17.1, JP18.1; also elsewhere on the board
D3: JP16.2, JP17.2, JP18.2; also elsewhere on the board
D4: JP16.3, JP17.3, JP18.3; also elsewhere on the board
D5: JP16.4, JP17.4, JP18.4; also elsewhere on the board
D6: JP16.5, JP17.5, JP18.5; also elsewhere on the board
D7: JP13.9; also elsewhere on the board
D8: JP14.9; also elsewhere on the board
D9: JP15.9; also elsewhere on the board
D10: JP16.9; also elsewhere on the board
D11: JP17.9; also elsewhere on the board
D12: JP18.9; also elsewhere on the board
D43: JP13.5, JP14.5, JP15.5; also elsewhere on the board
D44: JP13.4, JP14.4, JP15.4; also elsewhere on the board
D45: JP13.3, JP14.3, JP15.3; also elsewhere on the board
D46: JP13.2, JP14.2, JP15.2; also elsewhere on the board
D47: JP13.1, JP14.1, JP15.1; also elsewhere on the board
GND: C20.1, C21.1, C22.1, C23.1, C24.1, C25.1, C32.2, JP13.7, JP14.7, JP15.7, JP16.7, JP17.7, JP18.7; also elsewhere on the board

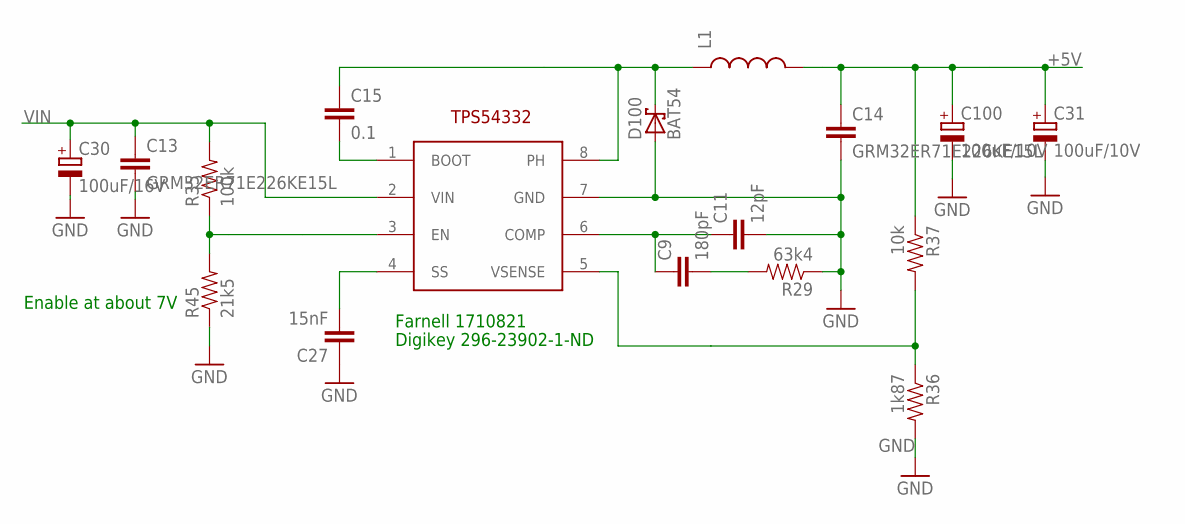
[picture p22: schematic Arduino_kuukulgur-alternatiivne3.sch, sheet 6]

Parts:
C9: 180pF; 0603-CAP
C11: 12pF; 0603-CAP
C13, C14: GRM32ER71E226KE15L; C1210
C15: 0.1; 0603-CAP
C27: 15nF; 0603-CAP
C30: 100uF/16V; C/6032-28R
C31, C100: 100uF/10V; C/6032-28R
D100: BAT54; SOT23
L1: INDUCTORSRU1038; SRU1038
R29: 63k4; 0603-RES
R35: 100k; 0603-RES
R36: 1k87; 0603-RES
R37: 10k; 0603-RES
R45: 21k5; 0603-RES
U$3: TPS54332; SO8

Connections:
+5V: C14.1, C31.+, C100.+, L1.2, R37.1; also elsewhere on the board
ENABLE_PANDA: R35.1, R45.2, U$3.3 (EN)
GND: C11.2, C13.2, C14.2, C27.1, C30.-, C31.-, C100.-, D100.1 (A), R29.1, R36.2, R45.1, U$3.7 (GND); also elsewhere on the board
unnamed: C27.2, U$3.4 (SS)
unnamed: C9.1, C11.1, U$3.6 (COMP)
unnamed: C9.2, R29.2
unnamed: C15.2, U$3.1 (BOOT)
unnamed: R36.1, R37.2, U$3.5 (VSENSE)
unnamed: C15.1, D100.3 (C), L1.1, U$3.8 (PH)
VIN: C13.1, C30.+, R35.2, U$3.2 (VIN); also elsewhere on the board

Notes on the sheet:
Farnell 1710821
Digikey 296-23902-1-ND
Enable at about 7V

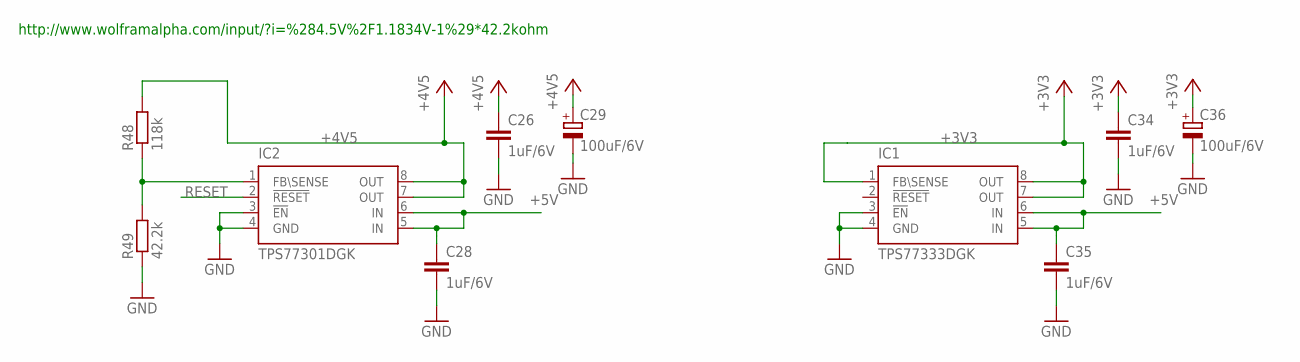
[picture p23: schematic Arduino_kuukulgur-alternatiivne3.sch, sheet 7]

Parts:
C26, C28, C34, C35: 1uF/6V; C0603
C29, C36: 100uF/6V; C/6032-28R
IC1: TPS77333DGK; MSOP8
IC2: TPS77301DGK; MSOP8
R48: 118k; R0603
R49: 42.2k; R0603

Connections:
+3V3: C34.1, C36.+, IC1.1 (FB\SENSE), IC1.7 (OUT), IC1.8 (OUT); also elsewhere on the board
+4V5: C26.1, C29.+, IC2.7 (OUT), IC2.8 (OUT), R48.2; also elsewhere on the board
+5V: C28.1, C35.1, IC1.5 (IN), IC1.6 (IN), IC2.5 (IN), IC2.6 (IN); also elsewhere on the board
GND: C26.2, C28.2, C29.-, C34.2, C35.2, C36.-, IC1.3 (!EN), IC1.4 (GND), IC2.3 (!EN), IC2.4 (GND), R49.1; also elsewhere on the board
unnamed: IC2.1 (FB\SENSE), R48.1, R49.2
RESET: IC2.2 (!RESET); also elsewhere on the board

Notes on the sheet:
http://www.wolframalpha.com/input/?i=%284.5V%2F1.1834V-1%29*42.2kohm

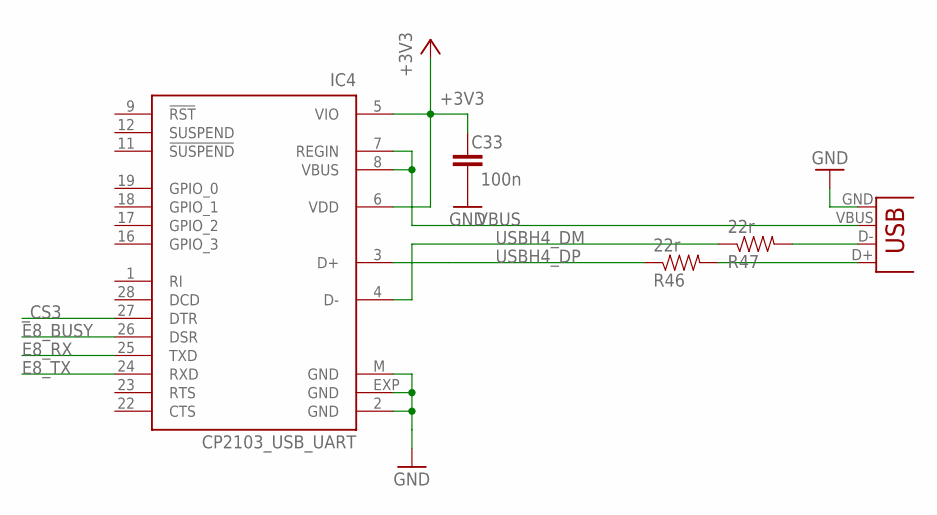
[picture p24: schematic Arduino_kuukulgur-alternatiivne3.sch, sheet 8]

Parts:
C33: 100n; C0603-ROUND
IC4: CP2103_USB_UART; MLP28
R46, R47: 22r; 0805
X2: USBSMD; USB-MINIB

Connections:
+3V3: C33.1, IC4.5 (VIO), IC4.6 (VDD); also elsewhere on the board
D+: R46.2, X2.D+
D-: R47.2, X2.D-
E8_BUSY: IC4.26 (DSR); also elsewhere on the board
E8_RX: IC4.25 (TXD); also elsewhere on the board
E8_TX: IC4.24 (RXD); also elsewhere on the board
GND: C33.2, IC4.2 (GND), IC4.EXP (GND), IC4.M (GND), X2.GND; also elsewhere on the board
USBH4_DM: IC4.4 (D-), R47.1
USBH4_DP: IC4.3 (D+), R46.1
VBUS: IC4.7 (REGIN), IC4.8 (VBUS), X2.VBUS
_CS3: IC4.27 (DTR); also elsewhere on the board

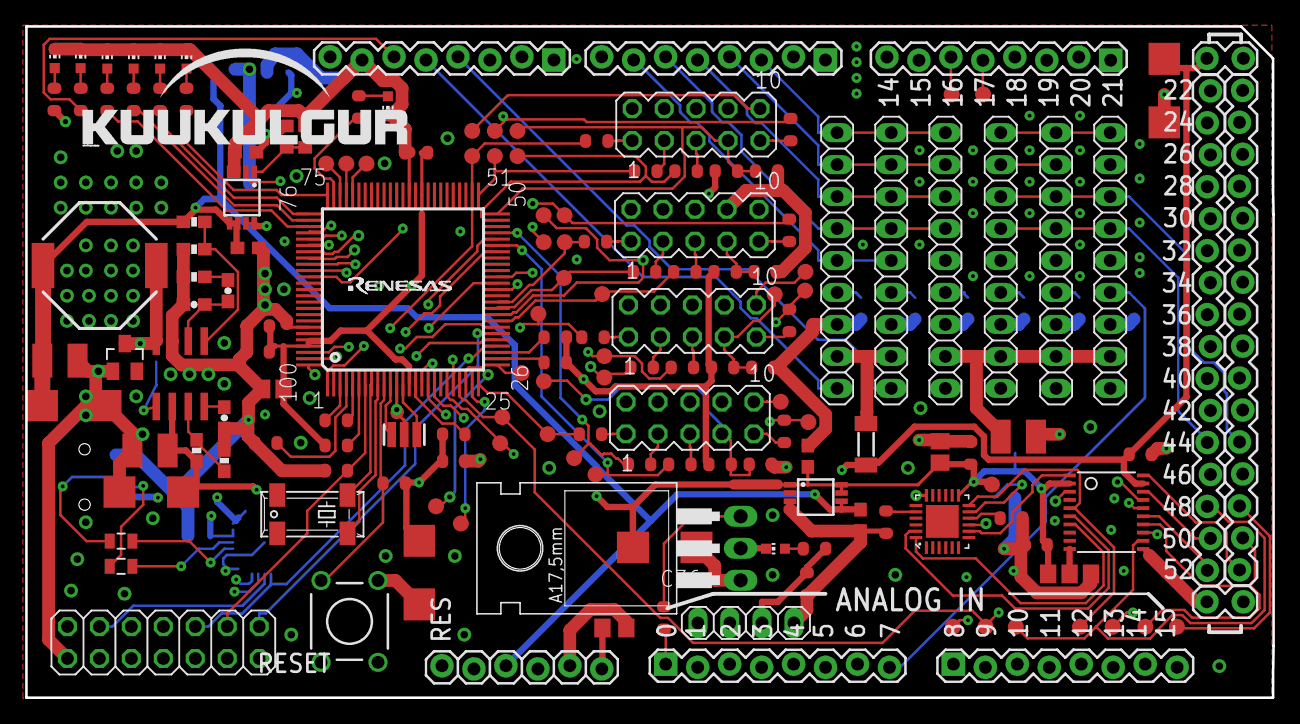
[picture p25: board Arduino_kuukulgur-alternatiivne3.brd from above]

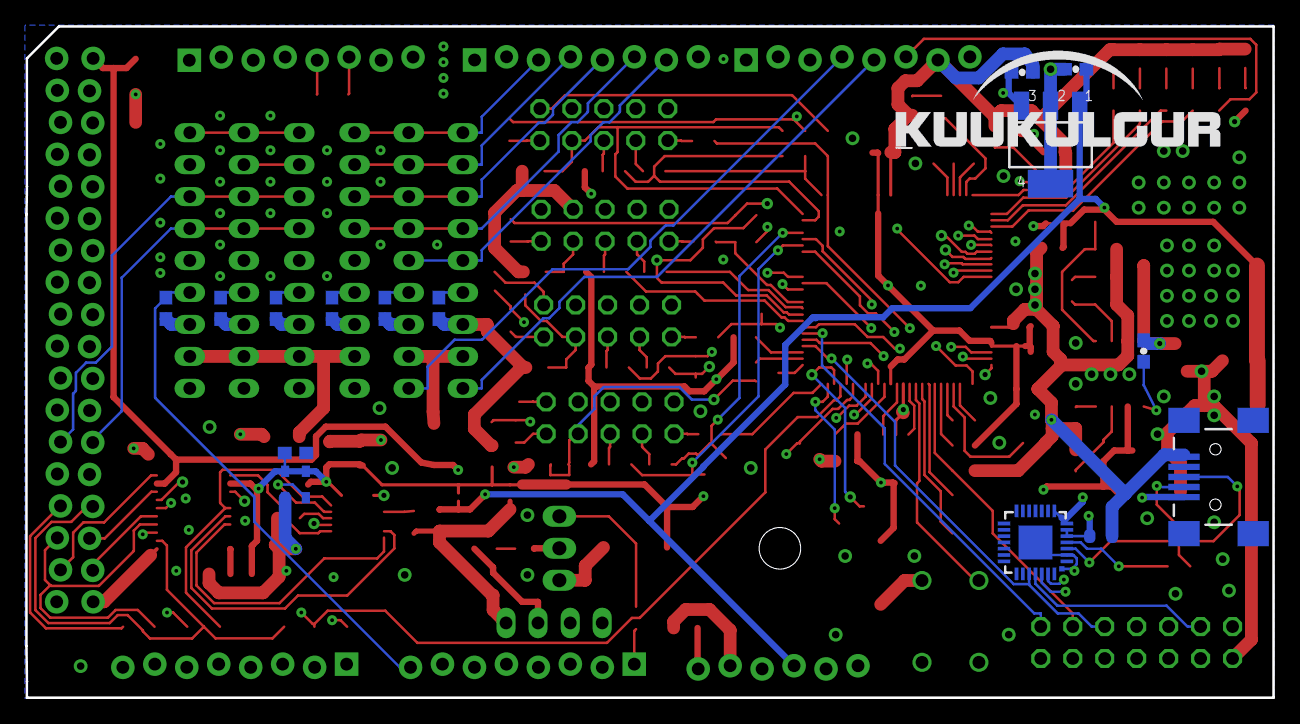
[picture p26: board Arduino_kuukulgur-alternatiivne3.brd from below]

Board: 4 copper layers, 99.1 x 53.3 mm, 180 parts (15 on the bottom side), 142 nets.
