tonuonu/NASA-Sample-Return-Robot/PowerSupply/Hardware/kulgurpowerproto.brd

## EAGLE design PowerSupply/Hardware/kulgurpowerproto.brd (2013-11-24)

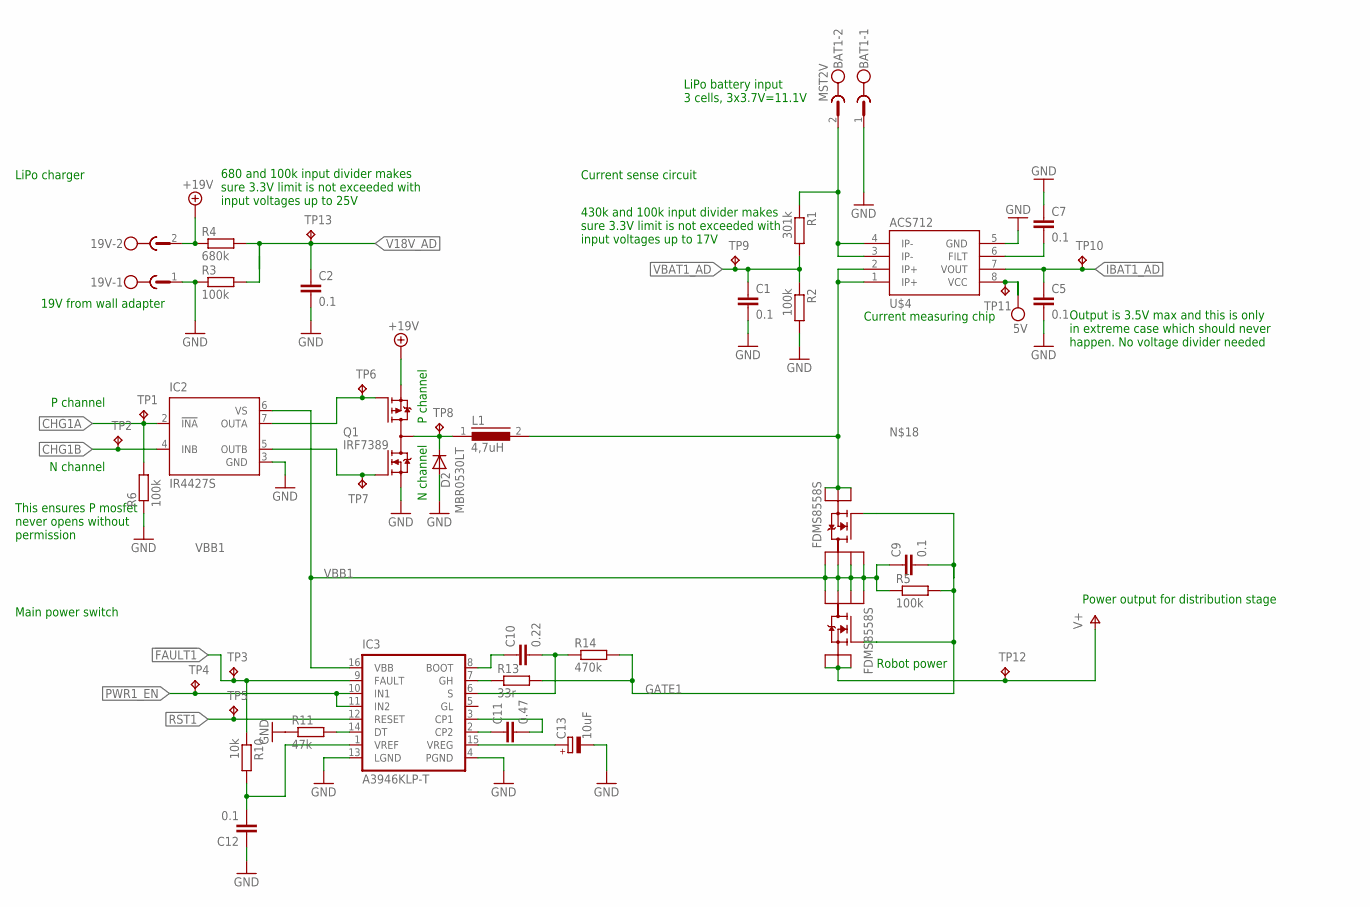
[picture p27: schematic kulgurpowerproto.sch]

Parts:
19V: MST2V; MSTBV2
BAT1: MST2V; MSTBV2
C1, C2, C5, C7, C9, C12: 0.1; C0603
C10: 0.22; C0603
C11: 0.47; C0603
C13: 10uF; A/3216-18R
D2: MBR0530LT; SOD123
IC2: IR4427S; SO08
IC3: A3946KLP-T; TSSOP16E
L1: 4,7uH; DR73
Q1: IRF7389; SO08-IRF
R1: 301k; R0603
R2, R3, R5, R6: 100k; R0603
R4: 680k; R0603
R10: 10k; R0603
R11: 47k; R0603
R13: 33r; R0603
R14: 470k; R0603
TP1, TP2, TP3, TP4, TP5, TP6, TP7, TP8, TP9, TP10, TP11, TP12, TP13: TPB2,54; B2,54
U$2, U$3: FDMS8558S; POWER56
U$4: ACS712; SO08

Connections:
5V: TP11.TP, U$4.8 (VCC)
!FAULT1: IC3.9 (FAULT), R10.1, TP3.TP
+19V: 19V.2, Q1.3 (P-S), R4.1
CHG1A: IC2.2 (!INA), R6.2, TP1.TP
CHG1B: IC2.4 (INB), TP2.TP
GATE1: C9.2, R5.2, R13.2, R14.2, U$2.P$4 (G), U$3.P$4 (G)
GND: 19V.1, BAT1.1, C1.2, C2.2, C5.2, C7.1, C12.1, C13.-, D2.A, IC2.3 (GND), IC3.4 (PGND), IC3.13 (LGND), Q1.1 (N-S), R2.2, R3.1, R6.1, R11.1, U$4.5 (GND)
IBAT1_AD: C5.1, TP10.TP, U$4.7 (VOUT)
unnamed: IC2.7 (OUTA), Q1.4 (P-G), TP6.TP
unnamed: IC2.5 (OUTB), Q1.2 (N-G), TP7.TP
unnamed: D2.C, L1.1, Q1.5 (D), Q1.6 (D), Q1.7 (D), Q1.8 (D), TP8.TP
unnamed: C10.1, IC3.8 (BOOT)
unnamed: L1.2, U$2.P$1 (S1), U$2.P$2 (S2), U$2.P$3 (S3), U$4.1 (IP+), U$4.2 (IP+)
unnamed: C10.2, IC3.6 (S), R14.1
unnamed: C7.2, U$4.6 (FILT)
unnamed: BAT1.2, R1.1, U$4.3 (IP-), U$4.4 (IP-)
unnamed: C11.1, IC3.2 (CP2)
unnamed: C11.2, IC3.3 (CP1)
unnamed: C12.2, IC3.1 (VREF), R10.2
unnamed: IC3.7 (GH), R13.1
unnamed: IC3.14 (DT), R11.2
unnamed: C13.+, IC3.15 (VREG)
PWR1_EN: IC3.10 (IN1), IC3.11 (IN2), TP4.TP
RST1: IC3.12 (RESET), TP5.TP
V18V_AD: C2.1, R3.2, R4.2, TP13.TP
V+: TP12.TP, U$3.P$1 (S1), U$3.P$2 (S2), U$3.P$3 (S3)
VBAT1_AD: C1.1, R1.2, R2.1, TP9.TP
VBB1: C9.1, IC2.6 (VS), IC3.16 (VBB), R5.1, U$2.P$5 (D4), U$2.P$6 (D3), U$2.P$7 (D2), U$2.P$8 (D1), U$3.P$5 (D4), U$3.P$6 (D3), U$3.P$7 (D2), U$3.P$8 (D1)

Notes on the sheet:
19V from wall adapter
LiPo battery input 3 cells, 3x3.7V=11.1V
Current measuring chip
Robot power
680 and 100k input divider makes sure 3.3V limit is not exceeded with input voltages up to 25V
430k and 100k input divider makes sure 3.3V limit is not exceeded with input voltages up to 17V
Output is 3.5V max and this is only in extreme case which should never happen. No voltage divider needed
LiPo charger
Current sense circuit
Main power switch
N channel
P channel
This ensures P mosfet never opens without permission
Power output for distribution stage

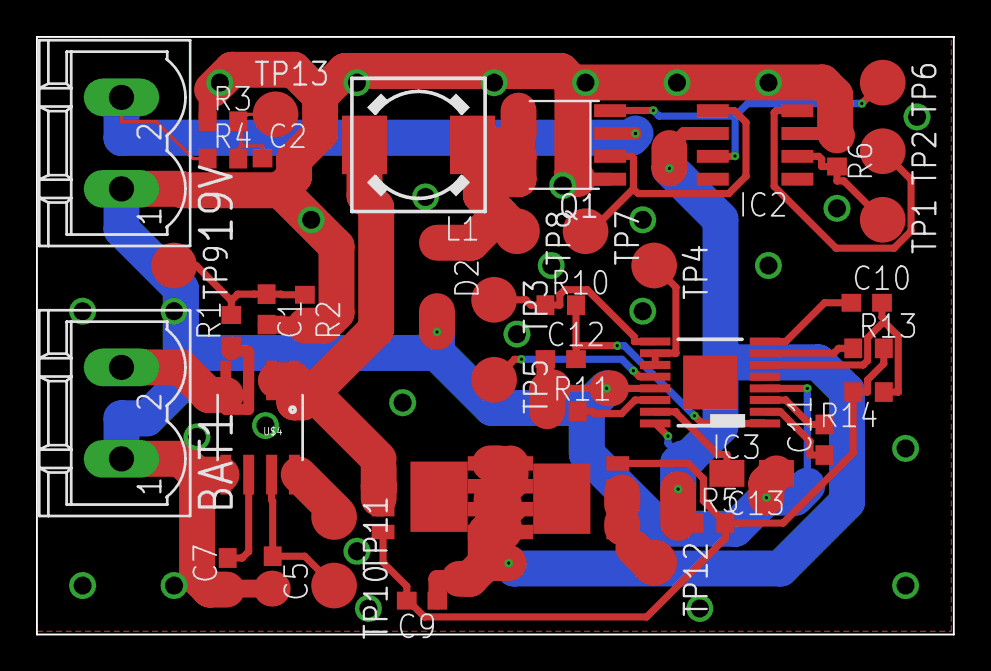
[picture p28: board kulgurpowerproto.brd from above]

Board: 2 copper layers, 50.9 x 33.2 mm, 42 parts (0 on the bottom side), 28 nets.
