tonuonu/NASA-Sample-Return-Robot/PowerSupply/Code/interrupt-main.cpp

/*
 *  Copyright (c) 2013, 2014 Tonu Samuel
 *  All rights reserved.
 *
 *  This file is part of robot "Kuukulgur".
 *
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
 */

#include "intrinsics.h"
#include "rtc.h"
#include "pwm.h"
#include "oled.h"
#include "hwsetup.h"
#include "spi.h"
#include "usb_hal.h"
#include "usb_cdc.h"
#include "usb.h"
#include "log.h"
#include "adc12repeat.h"
#include "interrupt-main.h"
#include "low_voltage_detection.h"
#include "rskrx630def.h"
#include "iorx630.h"
#include "stdbool.h"
#include "led.h"

/* Dclare a variable to hold the periodic delay specified */
volatile uint32_t gPeriodic_Delay;
/* Declare a variable to store the global delay count value */
volatile uint32_t gDelay_Counter = 0;

/******************************************************************************
* Outline    : Timer_Delay
* Description  : Function used to create delays in milliseconds or 
*          microseconds depending on the user selection for controlling 
*          the debug LCD function's calls. 
* Argument      : uint32_t   -   _Delay_Period
*          uint8   -   Unit  
* Return value  : none
******************************************************************************/
void Timer_Delay(uint32_t user_delay, uint8_t unit, uint8_t timer_mode) {
    /* Clear the timer's count */
    gDelay_Counter = 0;
    
    /* Check if microseconds delay is required */
    if(unit == 'u') {
        /* Select the PCLK clock division as PCLK/8 = 6MHz */ 
        CMT2.CMCR.BIT.CKS = 0x0;
    
        /* Store a copy of the user delay value to gPeriodic_Delay */
        gPeriodic_Delay = user_delay * 6;
  
        /* Specify the timer period */
        CMT2.CMCOR = gPeriodic_Delay;
    }
  
    /* Check if milliseconds delay is required */
    if(unit == 'm') {
        /* Select the PCLK clock division as PCLK/128 = 375KHz */ 
        CMT2.CMCR.BIT.CKS = 0x2;

        /* Store a copy of the user delay value to gPeriodic_Delay */
        gPeriodic_Delay = user_delay * 375;

        /* Specify the timer period */
        CMT2.CMCOR = gPeriodic_Delay;
    }
  
    /* Enable the compare match interrupt */
    CMT2.CMCR.BIT.CMIE = 1;

    /* Start CMT2 count */
    CMT.CMSTR1.BIT.STR2 = 1;

    /* Skip the following instructions if a periodic timer is required */
    if((timer_mode != PERIODIC_MODE)) {
        /* Wait for the timer to timeout */
        while((gDelay_Counter != gPeriodic_Delay)) {
            /* Wait */
        }  

        /* Stop CMT2 count */
        CMT.CMSTR1.BIT.STR2 = 0;
    }      
}

#define test(a) test_if_dangerous(__LINE__,a)

static void
test_if_dangerous(int lineno, int boolean) {
    int numinputs=BAT0_EN + BAT1_EN + BAT2_EN + BAT3_EN;
      
    if(numinputs == 1 && boolean) {      
        LED_RGB_set(RGB_RED);
        LED_RGB_blink();
        refresh();
        char buf[64];
        snprintf(buf,sizeof(buf),"--> lineno %d, numinputs %d <--",lineno,numinputs);
        OLED_Show_String(  1,buf, 0, 5*8);
        for(;;);
    }
}


#pragma vector=VECT_CMT2_CMI2
__interrupt void Excep_CMTU1_CMT2(void) {
    LED7 =LED_ON;
    /*
     * Resistor divider made from 33k and 100k 
     * Actual voltage is 133/33=4.03 times higher than ADC reading.
     * So when reference is 3.3V, maximum ADC reading is 133k/33k*3.3V=13.3V
     * Because we have 12bit ADC, formula for voltage is 13.3/(2^12-1)*reading
     * 13.3/(2^12)*4095=13.3V etc
     */
#define VCOEFF (((100.0+33.0)/33.0*3.3)/(4095.0))
    adc[0] =  (float)(S12AD.ADDR0>>4)*VCOEFF; // VBAT0_AD 
    adc[1] =  (float)(S12AD.ADDR1>>4)*VCOEFF; // VBAT1_AD
    adc[2] =  (float)(S12AD.ADDR2>>4)*VCOEFF; // VBAT2_AD
    adc[3] =  (float)(S12AD.ADDR3>>4)*VCOEFF; // VBAT3_AD
  
    /*
     * ACS712 20A version outputs 100mV for each A
     * Center is at VCC/2, so 5V/2=2.5V
     * Theoretical maximum current we can measure is 2.5/0.1=25A?
     * Zero current point is (2^12-1)/3.3*2.5
     * 4095/3.3*2.5 = ~3102 
     * For every volt 4095/3.3=1240.90909091 units
     * For every amper change is 4095/3.3*0.1=~124.09 units on ADC
     */
#define ICOEFF (4095.0/3.3*   0.1*-1)
#define IZBASE (   4095.0/3.3*2.53  )
    adc[4] = 0.8*adc[4] + 0.2*((float)(S12AD.ADDR4>>4)-IZBASE)/ICOEFF; // IBAT0_AD
    adc[5] = 0.8*adc[5] + 0.2*((float)(S12AD.ADDR5>>4)-IZBASE)/ICOEFF; // IBAT1_AD
    adc[6] = 0.8*adc[6] + 0.2*((float)(S12AD.ADDR6>>4)-IZBASE)/ICOEFF; // IBAT2_AD
    adc[7] = 0.8*adc[7] + 0.2*((float)(S12AD.ADDR7>>4)-IZBASE)/ICOEFF; // IBAT3_AD
    /*
     * Every volt on AD input 1023.0/3.3 
     * Resistor divider 680k and 100k makes (680.0+100.0)/100.0
     */
#define VCOEFF2 (((680.0+100.0)/100.0*3.3)/(1023.0))
    // AN0 is external adapter input
    adapter = (float) AD.ADDRA*VCOEFF2;
    
    /*
     * IMON1 and IMON2 are current measuring outputs of TPS51222
     * The measure voltage drop over output inductor and amplyify it by 50.
     * I = 0.066V / 0.008ohm = 8.25A 
     * Additionally there is a resistor divider on board from 10k and 3k12. 
     * This means we need to multiply value by ~1.0312
     * Measured current is not exact as inductor actualy drop may differ.
     * PGOOD indicates if power supply actually works. If not, current always
     * shows maximum value.
     */
    if(PGOOD1) {
        imon1 = (float) AD.ADDRC / 1023.0 * (0.066 / 0.010) * ((10.0+3.12)/3.12);
        imon1max = imon1 > imon1max ? imon1 : imon1max;
    } else {
        imon1 = 0.0f;
    }

    if(PGOOD2) {
        imon2 = (float) AD.ADDRD / 1023.0 * (0.066 / 0.010) * ((10.0+3.12)/3.12);
        imon2max = imon2 > imon2max ? imon2 : imon2max;
        if(imon2 > 10.0) { // Excess current on steering power supply
            static int da=0;
            da ^= 0xffff;
            DA.DADR1=da;
        }
    } else {
        imon2 = 0.0f;
    }
    
    if(!PGOOD1 || !PGOOD2) {
        static int restart=0;
        switch(restart) {
        case 10000:
            LED_RGB_set(RGB_RED);
            ENABLE_PWR=0;
            OUT4_EN=0;
            OUT5_EN=0;
            break;
        case 20000:
            LED_RGB_set(RGB_YELLOW);
            ENABLE_PWR=1;
            OUT4_EN=1;
            OUT5_EN=1;
            break;
        case 30000:
            restart=-1;
        }
        restart++; 
      
      
    } else {
        LED_RGB_set(RGB_BLUE);
    }
    
#define CURRENT_MAX     16.0
#define CURRENT_MIN     -4.0
#define VOLTAGE_MAX     12.6 * 1.1 // Allow some overhead before forcing shut off
#define VOLTAGE_MIN     9.0  * 0.9

    int BAT0_error=0;
    int BAT1_error=0;
    int BAT2_error=0;
    int BAT3_error=0;

    char buf[65];
#if 1
        
    /* check for voltages */   
    if(adc[0] > VOLTAGE_MAX || adc[0] < VOLTAGE_MIN) { // BAT0
        uint8_t flag=BAT0_EN;
        test(BAT0_EN!=MAX1614_OFF);
        BAT0_EN=MAX1614_OFF; // Turn off MOSFET
        BAT0_error=1;
        if(flag==MAX1614_ON) {
            snprintf(buf,sizeof(buf),"E:BAT0:%.2fV",adc[0]);
            logerror(buf);
        }
    }
    if(adc[1] > VOLTAGE_MAX || adc[1] < VOLTAGE_MIN) { // BAT1
        uint8_t flag=BAT1_EN;
        test(BAT1_EN!=MAX1614_OFF);
        BAT1_EN=MAX1614_OFF; // Turn off MOSFET
        BAT1_error=1;
        if(flag==MAX1614_ON) {
            snprintf(buf,sizeof(buf),"E:BAT1:%.2fV",adc[1]);
            logerror(buf);
        }
    }
    if(adc[2] > VOLTAGE_MAX || adc[2] < VOLTAGE_MIN) { // BAT2
        uint8_t flag=BAT2_EN;
        test(BAT2_EN!=MAX1614_OFF);
        BAT2_EN=MAX1614_OFF; // Turn off MOSFET
        BAT2_error=1;
        if(flag==MAX1614_ON) {
            snprintf(buf,sizeof(buf),"E:BAT2:%.2fV",adc[2]);
            logerror(buf);
        }
    }
    if(adc[3] > VOLTAGE_MAX || adc[3] < VOLTAGE_MIN) { // BAT3
        uint8_t flag=BAT3_EN;
        test(BAT3_EN!=MAX1614_OFF);
        BAT3_EN=MAX1614_OFF; // Turn off MOSFET
        BAT3_error=1;
        if(flag==MAX1614_ON) {
            snprintf(buf,sizeof(buf),"E:BAT3:%.2fV",adc[3]);
            logerror(buf);
        }
    }

    /* Find out which is maximum current on active batteries. */
    float maxcurrent=0.0;
    maxcurrent=maxcurrent < adc[4] ? adc[4] : maxcurrent; 
    maxcurrent=maxcurrent < adc[5] ? adc[5] : maxcurrent; 
    maxcurrent=maxcurrent < adc[6] ? adc[6] : maxcurrent; 
    maxcurrent=maxcurrent < adc[7] ? adc[7] : maxcurrent; 

    // make sure consumption is big enough to rule out too small values
    if(maxcurrent > 1.0f) {
        if(adc[4] < 0.5f) { // Input is enabled but battery is not connected          
            test(BAT0_EN!=MAX1614_OFF);
            BAT0_EN=MAX1614_OFF; // Turn off MOSFET
        }
        if(adc[5] < 0.5f) { // Input is enabled but battery is not connected
            test(BAT1_EN!=MAX1614_OFF);
            BAT1_EN=MAX1614_OFF; // Turn off MOSFET
        }
        if(adc[6] < 0.5f) { // Input is enabled but battery is not connected
            test(BAT2_EN!=MAX1614_OFF);
            BAT2_EN=MAX1614_OFF; // Turn off MOSFET
        }
        if(adc[7] < 0.5f) { // Input is enabled but battery is not connected
            test(BAT3_EN!=MAX1614_OFF);
            BAT3_EN=MAX1614_OFF; // Turn off MOSFET
        }
    }
    
    /* check for battery currents */   
    if(adc[4] > CURRENT_MAX || adc[4] < CURRENT_MIN) { // BAT0
        uint8_t flag=BAT0_EN;
        test(BAT0_EN!=MAX1614_OFF);
        BAT0_EN=MAX1614_OFF; // Turn off MOSFET
        BAT0_error=1;
        if(flag==MAX1614_ON) {
            snprintf(buf,sizeof(buf),"E:BAT0:%.2fA",adc[4]);
            logerror(buf);
        }
    }
    if(adc[5] > CURRENT_MAX || adc[5] < CURRENT_MIN) { // BAT1
        uint8_t flag=BAT1_EN;
        test(BAT1_EN!=MAX1614_OFF);
        BAT1_EN=MAX1614_OFF; // Turn off MOSFET
        BAT1_error=1;
        if(flag==MAX1614_ON) {
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
            PWM3--; // 
            LED_RGB_set(RGB_GREEN);
        }
    } else {
  //    LED_RGB_set(RGB_PINK);
    }
    
    PWM0 = PWM0 > 10 ? 10 : PWM0;
    PWM1 = PWM1 > 10 ? 10 : PWM1;
    PWM2 = PWM2 > 10 ? 10 : PWM2;
    PWM3 = PWM3 > 10 ? 10 : PWM3;

    PWM0 = PWM0 < 0 ? 0 : PWM0;
    PWM1 = PWM1 < 0 ? 0 : PWM1;
    PWM2 = PWM2 < 0 ? 0 : PWM2;
    PWM3 = PWM3 < 0 ? 0 : PWM3;

    /* 
     * if PWM is enabled, enable CSD97374Q4M chip by applying 0 to !SKIPx pin
     * If PWM is disabled, make !SKIPx pin into high impendance (input).
     */
    SKIP0=0;
    SKIP1=0;
    SKIP2=0;
    SKIP3=0;
    SKIP0_DIR= PWM0 ? 1 : 0;
    SKIP1_DIR= PWM1 ? 1 : 0;
    SKIP2_DIR= PWM2 ? 1 : 0;
    SKIP3_DIR= PWM3 ? 1 : 0;
        
    TPU3.TGRA = 10-PWM3;
    TPU3.TGRB = 10;

    TPU2.TGRA = 20-PWM2;
    TPU2.TGRB = 20;

    TPU1.TGRA = 30-PWM1;
    TPU1.TGRB = 30;

    TPU0.TGRA = 40-PWM0;
    TPU0.TGRB = 40;

#endif
    /* update gyroscope and accelerometer values */ 
    read_gyro();
    static int cnt=0;
    static int da=0;
    if(cnt++<1000) {
        da= da == 0 ? 0xffff : 0;
//        DA.DADR1=da;
    } else {
        if(cnt>10000)
            cnt=0;
    }
    
//    LED_RGB_set(RGB_BLUE);
    LED7 =LED_OFF;
}
