tonuonu/NASA-Sample-Return-Robot/PowerSupply/Code/main.cpp

/*
 *  Copyright (c) 2013 Tonu Samuel
 *  All rights reserved.
 *
 *  This file is part of robot "Kuukulgur".
 *
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
 */

#include "intrinsics.h"
#include "rtc.h"
#include "pwm.h"
#include "oled.h"
#include "hwsetup.h"
#include "spi.h"
#include "usb_hal.h"
#include "usb_cdc.h"
#include "usb.h"
#include "log.h"
#include "shell.h"
#include "string.h"
#include "stdio.h"
#include "adc12repeat.h"
#include "low_voltage_detection.h"
#include "interrupt-main.h"
#include "rskrx630def.h"
#include "iorx630.h"


extern volatile bool mems_realtime;
int main() {
    BAT0_EN = MAX1614_OFF; // Make sure battery inputs are NOT enabled here.
    BAT1_EN = MAX1614_OFF; // They may have problems like low voltage, high voltage etc.,  
    BAT2_EN = MAX1614_OFF; // they later get checked and enabled if possible
    BAT3_EN = MAX1614_OFF; 

    BAT0_EN_DIR = 1; // Make output
    BAT1_EN_DIR = 1;
    BAT2_EN_DIR = 1; 
    BAT3_EN_DIR = 1;

    logerror("Boot");
    HardwareSetup();
    Init_OLED(); // Make sure noone else calls OLED calls in interrupts before init
    
    ENABLE_PWR=1; /* Enable TPS51222. 
                   * Basically 5V is enabled to ACS712 current sensors
                   */
    ENABLE_PWR_DIR=1; // Make it output AFTER to avoid power glitch.
    
    OUT1_EN = MAX1614_ON; // Configure all power supply main outputs   
    OUT2_EN = MAX1614_ON; // Enable PC
    OUT3_EN = MAX1614_ON;
    OUT1_EN_DIR = 1;
    OUT2_EN_DIR = 1;
    OUT3_EN_DIR = 1;
    
    OUT4_EN = 1; // Configure TPS51222 DC DC outputs
    OUT5_EN = 1; // 1 is enable, 0 is disable
    OUT4_EN_DIR = 1; 
    OUT5_EN_DIR = 1; 
    
    Init_PWM();
    // Init_VoltageDetect();
    Init_RTC();
    Init_ADC12Repeat();
    Init_SPI();
    Init_Gyros();
    USBCDC_Init();  
    /* 
     * Configure a 1 ms periodic delay used 
     * to update the ADC and Gyro results and check for safety
     * This is sort of high priority "main loop" for us.
     * Low priority things can go into usual main loop.
     */
    Timer_Delay(100, 'u', PERIODIC_MODE);
      
    __enable_interrupt();  
    __delay_cycles(96UL*2000UL); // 2000us delay    
    OLED_Fill_RAM(0x00);				   // Clear Screen
    while(1) {
        __wait_for_interrupt();
        static bool done=false;
        if(USBCDC_IsConnected()) {
            volatile uint32_t DelayPreWrite = DELAY_VALUE_INITIAL;
            /*
             * Wait for enmeration to happen before starting to send data
             */
            if(!done) {
                done=true;
                while(0 != DelayPreWrite){DelayPreWrite--;}
                USBCDC_WriteString("\r\nRobot!\r\n");

            } 
            /*Start a Read*/
            USBCDC_Read_Async(BUFFER_SIZE, g_pBuffEmpty, CBDoneRead);
            /*This continues in the CBDoneRead function...*/
                
            if(mode==E_GYRO) {
                refresh();
            }
        } else {
            done=false;
            mems_realtime=false;
        }
#if 0
        /* Temporary HW validation code */
        if(mode==E_GYRO) {
            if(PORT3.PIDR.BIT.B4==1) {
                OUT1_EN = MAX1614_ON;
                OUT2_EN = MAX1614_ON; 
                OUT3_EN = MAX1614_ON;
            } else {
                OUT1_EN = MAX1614_OFF;
                OUT2_EN = MAX1614_OFF; 
                OUT3_EN = MAX1614_OFF;
            }
        }        
#endif
    }
}
