tonuonu/NASA-Sample-Return-Robot/PowerSupply/Code/iorx630_usb.h

/* IAR file generator: v1.0 */

                                                                         
                                                                         
                                                                         
                                                                         
                                                                         
                                                                         
                                                                         
                                                                         
                                                                         
                                                                         
                                                                         
/*********************************************************************************
*
* Device     : RX/RX600/RX630
*
* File Name  : iodefine.h
*
* Abstract   : Definition of I/O Register.
*
* History    : 0.10  (2010-10-06)  [Hardware Manual Revision : 0.11]
*            : 1.0A  (2011-08-04)  [Hardware Manual Revision : 1.00]
*            : 1.2D  (2012-06-17)  [Hardware Manual Revision : 1.20]
*
* NOTE       : THIS IS A TYPICAL EXAMPLE.
*
* Copyright (C) 2012(2010) Renesas Electronics Corporation
* and Renesas Solutions Corp. All rights reserved.
*
*********************************************************************************/
/********************************************************************************/
/*                                                                              */
/*  DESCRIPTION : Definition of ICU Register                                    */
/*  CPU TYPE    : RX630                                                         */
/*                                                                              */
/*  Usage : IR,DTCER,IER,IPR of ICU Register                                    */
/*     The following IR, DTCE, IEN, IPR macro functions simplify usage.         */
/*     The bit access operation is "Bit_Name(interrupt source,name)".           */
/*     A part of the name can be omitted.                                       */
/*     for example :                                                            */
/*       IR(TPU0,TGI0A) = 0;     expands to :                                   */
/*         ICU.IR[126].BIT.IR = 0;                                              */
/*                                                                              */
/*       DTCE(ICU,IRQ0) = 1;     expands to :                                   */
/*         ICU.DTCER[64].BIT.DTCE = 1;                                          */
/*                                                                              */
/*       IEN(CMT0,CMI0) = 1;     expands to :                                   */
/*         ICU.IER[0x03].BIT.IEN4 = 1;                                          */
/*                                                                              */
/*       IPR(SCI12,SCIX0) = 2;   expands to :                                   */
/*       IPR(SCI12,SCI  ) = 2;    // SCIX0,SCIX1,SCIX2,SCIX3 share IPR level.    */
/*         ICU.IPR[122].BIT.IPR = 2;                                            */
/*                                                                              */
/*       IPR(SCI0,RXI0) = 3;     expands to :                                   */
/*       IPR(SCI0,    ) = 3;     // SCI0 uses single IPR for all sources.       */
/*         ICU.IPR[214].BIT.IPR = 3;                                            */
/*                                                                              */
/*  Usage : #pragma interrupt Function_Identifier(vect=**)                      */
/*     The number of vector is "(interrupt source, name)".                      */
/*     for example :                                                            */
/*       #pragma interrupt INT_IRQ0(vect=VECT(ICU,IRQ0))          expands to :  */
/*         #pragma interrupt INT_IRQ0(vect=64)                                  */
/*       #pragma interrupt INT_CMT0_CMI0(vect=VECT(CMT0,CMI0))    expands to :  */
/*         #pragma interrupt INT_CMT0_CMI0(vect=28)                             */
/*       #pragma interrupt INT_MTU0_TGIA0(vect=VECT(MTU0,TGIA0))  expands to :  */
/*         #pragma interrupt INT_MTU0_TGIA0(vect=142)                           */
/*       #pragma interrupt INT_TPU0_TGI0A(vect=VECT(TPU0,TGI0A))  expands to :  */
/*         #pragma interrupt INT_TPU0_TGI0A(vect=126)                           */
/*                                                                              */
/*  Usage : MSTPCRA,MSTPCRB,MSTPCRC of SYSTEM Register                          */
/*     The bit access operation is "MSTP(name)".                                */
/*     The name that can be used is a macro name defined with "iodefine.h".     */
/*     for example :                                                            */
/*       MSTP(TMR2) = 0;    // TMR2,TMR3,TMR23                    expands to :  */
/*         SYSTEM.MSTPCRA.BIT.MSTPA4  = 0;                                      */
/*       MSTP(SCI0) = 0;    // SCI0,SMCI0                         expands to :  */
/*         SYSTEM.MSTPCRB.BIT.MSTPB31 = 0;                                      */
/*       MSTP(MTU4) = 0;    // MTU,MTU0,MTU1,MTU2,MTU3,MTU4,MTU5  expands to :  */
/*         SYSTEM.MSTPCRA.BIT.MSTPA9  = 0;                                      */
/*       MSTP(TPU4) = 0;    // TPU0,TPU1,TPU2,TPU3,TPU4,TPU5      expands to :  */
/*         SYSTEM.MSTPCRA.BIT.MSTPA13 = 0;                                      */
/*       MSTP(CMT3) = 0;    // CMT2,CMT3                          expands to :  */
/*         SYSTEM.MSTPCRA.BIT.MSTPA14 = 0;                                      */
/*                                                                              */
/*                                                                              */
/********************************************************************************/
#ifndef __RX630IODEFINE_HEADER__
#define __RX630IODEFINE_HEADER__

#ifdef __IAR_SYSTEMS_ICC__
#pragma language=save
#pragma language=extended
#ifndef _SYSTEM_BUILD
#pragma system_include
#endif
#endif

#ifdef __IAR_SYSTEMS_ICC__
#define __evenaccess
#else
#define __sfr
#endif


#ifdef __IAR_SYSTEMS_ICC__
#pragma bitfields=reversed
#else
#pragma bit_order left
#endif

#ifndef __IAR_SYSTEMS_ICC__
#pragma unpack
#endif

struct st_ad {
	unsigned short ADDRA;
	unsigned short ADDRB;
	unsigned short ADDRC;
	unsigned short ADDRD;
	unsigned short ADDRE;
	unsigned short ADDRF;
	unsigned short ADDRG;
	unsigned short ADDRH;
	union {
		unsigned char BYTE;
		struct {
			unsigned char :1;
			unsigned char ADIE:1;
			unsigned char ADST:1;
			unsigned char :2;
			unsigned char CH:3;
		} BIT;
	} ADCSR;
	union {
		unsigned char BYTE;
		struct {
			unsigned char TRGS:3;
			unsigned char :1;
			unsigned char CKS:2;
			unsigned char MODE:2;
		} BIT;
	} ADCR;
	union {
		unsigned char BYTE;
		struct {
			unsigned char DPSEL:1;
			unsigned char EXOEN:1;
			unsigned char EXSEL:2;
		} BIT;
	} ADCR2;
	unsigned char  ADSSTR;
	char           wk0[11];
	union {
		unsigned char BYTE;
		struct {
			unsigned char :6;
			unsigned char DIAG:2;
		} BIT;
	} ADDIAGR;
};

struct st_bsc {
	union {
		unsigned char BYTE;
		struct {
			unsigned char :7;
			unsigned char STSCLR:1;
		} BIT;
	} BERCLR;
	char           wk0[3];
	union {
		unsigned char BYTE;
		struct {
			unsigned char :6;
			unsigned char TOEN:1;
			unsigned char IGAEN:1;
		} BIT;
	} BEREN;
	char           wk1[3];
	union {
		unsigned char BYTE;
		struct {
			unsigned char :1;
			unsigned char MST:3;
			unsigned char :2;
			unsigned char TO:1;
			unsigned char IA:1;
		} BIT;
	} BERSR1;
	char           wk2[1];
	union {
		unsigned short WORD;
		struct {
			unsigned short ADDR:13;
		} BIT;
	} BERSR2;
	char           wk3[4];
	union {
		unsigned short WORD;
		struct {
			unsigned short :2;
			unsigned short BPEB:2;
			unsigned short BPFB:2;
			unsigned short :2;
			unsigned short BPGB:2;
			unsigned short BPIB:2;
			unsigned short BPRO:2;
			unsigned short BPRA:2;
		} BIT;
	} BUSPRI;
	char           wk4[7408];
	union {
		unsigned short WORD;
		struct {
			unsigned short PRMOD:1;
			unsigned short :5;
			unsigned short PWENB:1;
			unsigned short PRENB:1;
			unsigned short :4;
			unsigned short EWENB:1;
			unsigned short :2;
			unsigned short WRMOD:1;
		} BIT;
	} CS0MOD;
	union {
		unsigned long LONG;
		struct {
			unsigned long :3;
			unsigned long CSRWAIT:5;
			unsigned long :3;
			unsigned long CSWWAIT:5;
			unsigned long :5;
			unsigned long CSPRWAIT:3;
			unsigned long :5;
			unsigned long CSPWWAIT:3;
		} BIT;
	} CS0WCR1;
	union {
		unsigned long LONG;
		struct {
			unsigned long :1;
			unsigned long CSON:3;
			unsigned long :1;
			unsigned long WDON:3;
			unsigned long :1;
			unsigned long WRON:3;
			unsigned long :1;
			unsigned long RDON:3;
			unsigned long :2;
			unsigned long AWAIT:2;
			unsigned long :1;
			unsigned long WDOFF:3;
			unsigned long :1;
			unsigned long CSWOFF:3;
			unsigned long :1;
			unsigned long CSROFF:3;
		} BIT;
	} CS0WCR2;
	char           wk5[6];
	union {
		unsigned short WORD;
		struct {
			unsigned short PRMOD:1;
			unsigned short :5;
			unsigned short PWENB:1;
			unsigned short PRENB:1;
			unsigned short :4;
			unsigned short EWENB:1;
			unsigned short :2;
			unsigned short WRMOD:1;
		} BIT;
	} CS1MOD;
	union {
		unsigned long LONG;
		struct {
			unsigned long :3;
			unsigned long CSRWAIT:5;
			unsigned long :3;
			unsigned long CSWWAIT:5;
			unsigned long :5;
			unsigned long CSPRWAIT:3;
			unsigned long :5;
			unsigned long CSPWWAIT:3;
		} BIT;
	} CS1WCR1;
	union {
		unsigned long LONG;
		struct {
			unsigned long :1;
			unsigned long CSON:3;
			unsigned long :1;
			unsigned long WDON:3;
			unsigned long :1;
			unsigned long WRON:3;
			unsigned long :1;
			unsigned long RDON:3;
			unsigned long :2;
			unsigned long AWAIT:2;
			unsigned long :1;
			unsigned long WDOFF:3;
			unsigned long :1;
			unsigned long CSWOFF:3;
			unsigned long :1;
			unsigned long CSROFF:3;
		} BIT;
	} CS1WCR2;
	char           wk6[6];
	union {
		unsigned short WORD;
		struct {
			unsigned short PRMOD:1;
			unsigned short :5;
			unsigned short PWENB:1;
			unsigned short PRENB:1;
			unsigned short :4;
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
			unsigned char MB30:1;
			unsigned char MB29:1;
			unsigned char MB28:1;
			unsigned char MB27:1;
			unsigned char MB26:1;
			unsigned char MB25:1;
			unsigned char MB24:1;
			unsigned char MB23:1;
			unsigned char MB22:1;
			unsigned char MB21:1;
			unsigned char MB20:1;
			unsigned char MB19:1;
			unsigned char MB18:1;
			unsigned char MB17:1;
			unsigned char MB16:1;
			unsigned char MB15:1;
			unsigned char MB14:1;
			unsigned char MB13:1;
			unsigned char MB12:1;
			unsigned char MB11:1;
			unsigned char MB10:1;
			unsigned char MB9:1;
			unsigned char MB8:1;
			unsigned char MB7:1;
			unsigned char MB6:1;
			unsigned char MB5:1;
			unsigned char MB4:1;
			unsigned char MB3:1;
			unsigned char MB2:1;
			unsigned char MB1:1;
			unsigned char MB0:1;
		} BIT;
	} MIER;
	char           wk0[1008];
	union {
		unsigned char BYTE;
		union {
			struct {
				unsigned char TRMREQ:1;
				unsigned char RECREQ:1;
				unsigned char :1;
				unsigned char ONESHOT:1;
				unsigned char :1;
				unsigned char TRMABT:1;
				unsigned char TRMACTIVE:1;
				unsigned char SENTDATA:1;
			} TX;
			struct {
				unsigned char TRMREQ:1;
				unsigned char RECREQ:1;
				unsigned char :1;
				unsigned char ONESHOT:1;
				unsigned char :1;
				unsigned char MSGLOST:1;
				unsigned char INVALDATA:1;
				unsigned char NEWDATA:1;
			} RX;
		} BIT;
	} MCTL[32];
	union {
		unsigned short WORD;
		struct {
			unsigned char H;
			unsigned char L;
		} BYTE;
		struct {
			unsigned char :2;
			unsigned char RBOC:1;
			unsigned char BOM:2;
			unsigned char SLPM:1;
			unsigned char CANM:2;
			unsigned char TSPS:2;
			unsigned char TSRC:1;
			unsigned char TPM:1;
			unsigned char MLM:1;
			unsigned char IDFM:2;
			unsigned char MBM:1;
		} BIT;
	} CTLR;
	union {
		unsigned short WORD;
		struct {
			unsigned char H;
			unsigned char L;
		} BYTE;
		struct {
			unsigned char :1;
			unsigned char RECST:1;
			unsigned char TRMST:1;
			unsigned char BOST:1;
			unsigned char EPST:1;
			unsigned char SLPST:1;
			unsigned char HLTST:1;
			unsigned char RSTST:1;
			unsigned char EST:1;
			unsigned char TABST:1;
			unsigned char FMLST:1;
			unsigned char NMLST:1;
			unsigned char TFST:1;
			unsigned char RFST:1;
			unsigned char SDST:1;
			unsigned char NDST:1;
		} BIT;
	} STR;
	union {
		unsigned long LONG;
		struct {
			unsigned short H;
			unsigned short L;
		} WORD;
		struct {
			unsigned char HH;
			unsigned char HL;
			unsigned char LH;
			unsigned char LL;
		} BYTE;
		struct {
			unsigned long TSEG1:4;
			unsigned long :2;
			unsigned long BRP:10;
			unsigned long :2;
			unsigned long SJW:2;
			unsigned long :1;
			unsigned long TSEG2:3;
			unsigned long :7;
			unsigned long CCLKS:1;
		} BIT;
	} BCR;
	union {
		unsigned char BYTE;
		struct {
			unsigned char RFEST:1;
			unsigned char RFWST:1;
			unsigned char RFFST:1;
			unsigned char RFMLF:1;
			unsigned char RFUST:3;
			unsigned char RFE:1;
		} BIT;
	} RFCR;
	unsigned char  RFPCR;
	union {
		unsigned char BYTE;
		struct {
			unsigned char TFEST:1;
			unsigned char TFFST:1;
			unsigned char :2;
			unsigned char TFUST:3;
			unsigned char TFE:1;
		} BIT;
	} TFCR;
	unsigned char  TFPCR;
	union {
		unsigned char BYTE;
		struct {
			unsigned char BLIE:1;
			unsigned char OLIE:1;
			unsigned char ORIE:1;
			unsigned char BORIE:1;
			unsigned char BOEIE:1;
			unsigned char EPIE:1;
			unsigned char EWIE:1;
			unsigned char BEIE:1;
		} BIT;
	} EIER;
	union {
		unsigned char BYTE;
		struct {
			unsigned char BLIF:1;
			unsigned char OLIF:1;
			unsigned char ORIF:1;
			unsigned char BORIF:1;
			unsigned char BOEIF:1;
			unsigned char EPIF:1;
			unsigned char EWIF:1;
			unsigned char BEIF:1;
		} BIT;
	} EIFR;
	unsigned char  RECR;
	unsigned char  TECR;
	union {
		unsigned char BYTE;
		struct {
			unsigned char EDPM:1;
			unsigned char ADEF:1;
			unsigned char BE0F:1;
			unsigned char BE1F:1;
			unsigned char CEF:1;
			unsigned char AEF:1;
			unsigned char FEF:1;
			unsigned char SEF:1;
		} BIT;
	} ECSR;
	unsigned char  CSSR;
	union {
		unsigned char BYTE;
		struct {
			unsigned char SEST:1;
			unsigned char :2;
			unsigned char MBNST:5;
		} BIT;
	} MSSR;
	union {
		unsigned char BYTE;
		struct {
			unsigned char :6;
			unsigned char MBSM:2;
		} BIT;
	} MSMR;
	unsigned short TSR;
	unsigned short AFSR;
	union {
		unsigned char BYTE;
		struct {
			unsigned char :5;
			unsigned char TSTM:2;
			unsigned char TSTE:1;
		} BIT;
	} TCR;
};

struct st_cmt {
	union {
		unsigned short WORD;
		struct {
			unsigned short :14;
			unsigned short STR1:1;
			unsigned short STR0:1;
		} BIT;
	} CMSTR0;
	char           wk0[14];
	union {
		unsigned short WORD;
		struct {
			unsigned short :14;
			unsigned short STR3:1;
			unsigned short STR2:1;
		} BIT;
	} CMSTR1;
};

struct st_cmt0 {
	union {
		unsigned short WORD;
		struct {
			unsigned short :9;
			unsigned short CMIE:1;
			unsigned short :4;
			unsigned short CKS:2;
		} BIT;
	} CMCR;
	unsigned short CMCNT;
	unsigned short CMCOR;
};

struct st_crc {
	union {
		unsigned char BYTE;
		struct {
			unsigned char DORCLR:1;
			unsigned char :4;
			unsigned char LMS:1;
			unsigned char GPS:2;
		} BIT;
	} CRCCR;
	unsigned char  CRCDIR;
	unsigned short CRCDOR;
};

struct st_da {
	unsigned short DADR0;
	unsigned short DADR1;
	union {
		unsigned char BYTE;
		struct {
			unsigned char DAOE1:1;
			unsigned char DAOE0:1;
			unsigned char DAE:1;
		} BIT;
	} DACR;
	union {
		unsigned char BYTE;
		struct {
			unsigned char DPSEL:1;
		} BIT;
	} DADPR;
	union {
		unsigned char BYTE;
		struct {
			unsigned char DAADST:1;
		} BIT;
	} DAADSCR;
};

struct st_dmac {
	union {
		unsigned char BYTE;
		struct {
			unsigned char :7;
			unsigned char DMST:1;
		} BIT;
	} DMAST;
};

struct st_dmac0 {
	void          *DMSAR;
	void          *DMDAR;
	unsigned long  DMCRA;
	unsigned short DMCRB;
	char           wk0[2];
	union {
		unsigned short WORD;
		struct {
			unsigned short MD:2;
			unsigned short DTS:2;
			unsigned short :2;
			unsigned short SZ:2;
			unsigned short :6;
			unsigned short DCTG:2;
		} BIT;
	} DMTMD;
	char           wk1[1];
	union {
		unsigned char BYTE;
		struct {
			unsigned char :3;
			unsigned char DTIE:1;
			unsigned char ESIE:1;
			unsigned char RPTIE:1;
			unsigned char SARIE:1;
			unsigned char DARIE:1;
		} BIT;
	} DMINT;
	union {
		unsigned short WORD;
		struct {
			unsigned short SM:2;
			unsigned short :1;
			unsigned short SARA:5;
			unsigned short DM:2;
			unsigned short :1;
			unsigned short DARA:5;
		} BIT;
	} DMAMD;
	char           wk2[2];
	unsigned long  DMOFR;
	union {
		unsigned char BYTE;
		struct {
			unsigned char :7;
			unsigned char DTE:1;
		} BIT;
	} DMCNT;
	union {
		unsigned char BYTE;
		struct {
			unsigned char :3;
			unsigned char CLRS:1;
			unsigned char :3;
			unsigned char SWREQ:1;
		} BIT;
	} DMREQ;
	union {
		unsigned char BYTE;
		struct {
			unsigned char ACT:1;
			unsigned char :2;
			unsigned char DTIF:1;
			unsigned char :3;
			unsigned char ESIF:1;
		} BIT;
	} DMSTS;
	union {
		unsigned char BYTE;
		struct {
			unsigned char :7;
			unsigned char DISEL:1;
		} BIT;
	} DMCSL;
};

struct st_dmac1 {
	void          *DMSAR;
	void          *DMDAR;
	unsigned long  DMCRA;
	unsigned short DMCRB;
	char           wk0[2];
	union {
		unsigned short WORD;
		struct {
			unsigned short MD:2;
			unsigned short DTS:2;
			unsigned short :2;
			unsigned short SZ:2;
			unsigned short :6;
			unsigned short DCTG:2;
		} BIT;
	} DMTMD;
	char           wk1[1];
	union {
		unsigned char BYTE;
		struct {
			unsigned char :3;
			unsigned char DTIE:1;
			unsigned char ESIE:1;
			unsigned char RPTIE:1;
			unsigned char SARIE:1;
			unsigned char DARIE:1;
		} BIT;
	} DMINT;
	union {
		unsigned short WORD;
		struct {
			unsigned short SM:2;
			unsigned short :1;
			unsigned short SARA:5;
			unsigned short DM:2;
			unsigned short :1;
			unsigned short DARA:5;
		} BIT;
	} DMAMD;
	char           wk2[6];
	union {
		unsigned char BYTE;
		struct {
			unsigned char :7;
			unsigned char DTE:1;
		} BIT;
	} DMCNT;
	union {
		unsigned char BYTE;
		struct {
			unsigned char :3;
			unsigned char CLRS:1;
			unsigned char :3;
			unsigned char SWREQ:1;
		} BIT;
	} DMREQ;
	union {
		unsigned char BYTE;
		struct {
			unsigned char ACT:1;
			unsigned char :2;
			unsigned char DTIF:1;
			unsigned char :3;
			unsigned char ESIF:1;
		} BIT;
	} DMSTS;
	union {
		unsigned char BYTE;
		struct {
			unsigned char :7;
			unsigned char DISEL:1;
		} BIT;
	} DMCSL;
};

struct st_dtc {
	union {
		unsigned char BYTE;
		struct {
			unsigned char :3;
			unsigned char RRS:1;
		} BIT;
	} DTCCR;
	char           wk0[3];
	void          *DTCVBR;
	union {
		unsigned char BYTE;
		struct {
			unsigned char :7;
			unsigned char SHORT:1;
		} BIT;
	} DTCADMOD;
	char           wk1[3];
	union {
		unsigned char BYTE;
		struct {
			unsigned char :7;
			unsigned char DTCST:1;
		} BIT;
	} DTCST;
	char           wk2[1];
	union {
		unsigned short WORD;
		struct {
			unsigned short ACT:1;
			unsigned short :7;
			unsigned short VECN:8;
		} BIT;
	} DTCSTS;
};

struct st_flash {
	union {
		unsigned char BYTE;
		struct {
			unsigned char :6;
			unsigned char FLWE:2;
		} BIT;
	} FWEPROR;
	char           wk0[7799147];
	union {
		unsigned char BYTE;
		struct {
			unsigned char :3;
			unsigned char FRDMD:1;
		} BIT;
	} FMODR;
	char           wk1[13];
	union {
		unsigned char BYTE;
		struct {
			unsigned char ROMAE:1;
			unsigned char :2;
			unsigned char CMDLK:1;
			unsigned char DFLAE:1;
			unsigned char :1;
			unsigned char DFLRPE:1;
			unsigned char DFLWPE:1;
		} BIT;
	} FASTAT;
	union {
		unsigned char BYTE;
		struct {
			unsigned char ROMAEIE:1;
			unsigned char :2;
			unsigned char CMDLKIE:1;
			unsigned char DFLAEIE:1;
			unsigned char :1;
			unsigned char DFLRPEIE:1;
			unsigned char DFLWPEIE:1;
		} BIT;
	} FAEINT;
	union {
		unsigned char BYTE;
		struct {
			unsigned char :7;
			unsigned char FRDYIE:1;
		} BIT;
	} FRDYIE;
	char           wk2[45];
	union {
		unsigned short WORD;
		struct {
			unsigned short KEY:8;
			unsigned short DBRE07:1;
			unsigned short DBRE06:1;
			unsigned short DBRE05:1;
			unsigned short DBRE04:1;
			unsigned short DBRE03:1;
			unsigned short DBRE02:1;
			unsigned short DBRE01:1;
			unsigned short DBRE00:1;
		} BIT;
	} DFLRE0;
	union {
		unsigned short WORD;
		struct {
			unsigned short KEY:8;
			unsigned short DBRE15:1;
			unsigned short DBRE14:1;
			unsigned short DBRE13:1;
			unsigned short DBRE12:1;
			unsigned short DBRE11:1;
			unsigned short DBRE10:1;
			unsigned short DBRE09:1;
			unsigned short DBRE08:1;
		} BIT;
	} DFLRE1;
	char           wk3[12];
	union {
		unsigned short WORD;
		struct {
			unsigned short KEY:8;
			unsigned short DBWE07:1;
			unsigned short DBW006:1;
			unsigned short DBWE05:1;
			unsigned short DBWE04:1;
			unsigned short DBWE03:1;
			unsigned short DBWE02:1;
			unsigned short DBWE01:1;
			unsigned short DBWE00:1;
		} BIT;
	} DFLWE0;
	union {
		unsigned short WORD;
		struct {
			unsigned short KEY:8;
			unsigned short DBWE15:1;
			unsigned short DBWE14:1;
			unsigned short DBWE13:1;
			unsigned short DBWE12:1;
			unsigned short DBWE11:1;
			unsigned short DBWE10:1;
			unsigned short DBWE09:1;
			unsigned short DBWE08:1;
		} BIT;
	} DFLWE1;
	union {
		unsigned short WORD;
		struct {
			unsigned short KEY:8;
			unsigned short :7;
			unsigned short FCRME:1;
		} BIT;
	} FCURAME;
	char           wk4[15194];
	union {
		unsigned char BYTE;
		struct {
			unsigned char FRDY:1;
			unsigned char ILGLERR:1;
			unsigned char ERSERR:1;
			unsigned char PRGERR:1;
			unsigned char SUSRDY:1;
			unsigned char :1;
			unsigned char ERSSPD:1;
			unsigned char PRGSPD:1;
		} BIT;
	} FSTATR0;
	union {
		unsigned char BYTE;
		struct {
			unsigned char FCUERR:1;
			unsigned char :2;
			unsigned char FLOCKST:1;
		} BIT;
	} FSTATR1;
	union {
		unsigned short WORD;
		struct {
			unsigned short FEKEY:8;
			unsigned short FENTRYD:1;
			unsigned short :3;
			unsigned short FENTRY3:1;
			unsigned short FENTRY2:1;
			unsigned short FENTRY1:1;
			unsigned short FENTRY0:1;
		} BIT;
	} FENTRYR;
	union {
		unsigned short WORD;
		struct {
			unsigned short FPKEY:8;
			unsigned short :7;
			unsigned short FPROTCN:1;
		} BIT;
	} FPROTR;
	union {
		unsigned short WORD;
		struct {
			unsigned short FRKEY:8;
			unsigned short :7;
			unsigned short FRESET:1;
		} BIT;
	} FRESETR;
	char           wk5[2];
	union {
		unsigned short WORD;
		struct {
			unsigned short CMDR:8;
			unsigned short PCMDR:8;
		} BIT;
	} FCMDR;
	char           wk6[12];
	union {
		unsigned short WORD;
		struct {
			unsigned short :15;
			unsigned short ESUSPMD:1;
		} BIT;
	} FCPSR;
	union {
		unsigned short WORD;
		struct {
			unsigned short BCSIZE:1;
			unsigned short :4;
			unsigned short BCADR:11;
		} BIT;
	} DFLBCCNT;
	union {
		unsigned short WORD;
		struct {
			unsigned short :8;
			unsigned short PEERRST:8;
		} BIT;
	} FPESTAT;
	union {
		unsigned short WORD;
		struct {
			unsigned short :15;
			unsigned short BCST:1;
		} BIT;
	} DFLBCSTAT;
	char           wk7[24];
	union {
		unsigned short WORD;
		struct {
			unsigned short :8;
			unsigned short PCKA:8;
		} BIT;
	} PCKAR;
};

struct st_icu {
	union {
		unsigned char BYTE;
		struct {
			unsigned char :7;
			unsigned char IR:1;
		} BIT;
	} IR[254];
	char           wk0[2];
	union {
		unsigned char BYTE;
		struct {
			unsigned char :7;
			unsigned char DTCE:1;
		} BIT;
	} DTCER[252];
	char           wk1[4];
	union {
		unsigned char BYTE;
		struct {
			unsigned char IEN7:1;
			unsigned char IEN6:1;
			unsigned char IEN5:1;
			unsigned char IEN4:1;
			unsigned char IEN3:1;
			unsigned char IEN2:1;
			unsigned char IEN1:1;
			unsigned char IEN0:1;
		} BIT;
	} IER[32];
	char           wk2[192];
	union {
		unsigned char BYTE;
		struct {
			unsigned char :7;
			unsigned char SWINT:1;
		} BIT;
	} SWINTR;
	char           wk3[15];
	union {
		unsigned short WORD;
		struct {
			unsigned short FIEN:1;
			unsigned short :7;
			unsigned short FVCT:8;
		} BIT;
	} FIR;
	char           wk4[14];
	union {
		unsigned char BYTE;
		struct {
			unsigned char :4;
			unsigned char IPR:4;
		} BIT;
	} IPR[254];
	char           wk5[2];
	unsigned char  DMRSR0;
	char           wk6[3];
	unsigned char  DMRSR1;
	char           wk7[3];
	unsigned char  DMRSR2;
	char           wk8[3];
	unsigned char  DMRSR3;
	char           wk9[243];
	union {
		unsigned char BYTE;
		struct {
			unsigned char :4;
			unsigned char IRQMD:2;
		} BIT;
	} IRQCR[16];
	union {
		unsigned char BYTE;
		struct {
			unsigned char FLTEN7:1;
			unsigned char FLTEN6:1;
			unsigned char FLTEN5:1;
			unsigned char FLTEN4:1;
			unsigned char FLTEN3:1;
			unsigned char FLTEN2:1;
			unsigned char FLTEN1:1;
			unsigned char FLTEN0:1;
		} BIT;
	} IRQFLTE0;
	union {
		unsigned char BYTE;
		struct {
			unsigned char FLTEN15:1;
			unsigned char FLTEN14:1;
			unsigned char FLTEN13:1;
			unsigned char FLTEN12:1;
			unsigned char FLTEN11:1;
			unsigned char FLTEN10:1;
			unsigned char FLTEN9:1;
			unsigned char FLTEN8:1;
		} BIT;
	} IRQFLTE1;
	char           wk10[2];
	union {
		unsigned short WORD;
		struct {
			unsigned short FCLKSEL7:2;
			unsigned short FCLKSEL6:2;
			unsigned short FCLKSEL5:2;
			unsigned short FCLKSEL4:2;
			unsigned short FCLKSEL3:2;
			unsigned short FCLKSEL2:2;
			unsigned short FCLKSEL1:2;
			unsigned short FCLKSEL0:2;
		} BIT;
	} IRQFLTC0;
	union {
		unsigned short WORD;
		struct {
			unsigned short FCLKSEL15:2;
			unsigned short FCLKSEL14:2;
			unsigned short FCLKSEL13:2;
			unsigned short FCLKSEL12:2;
			unsigned short FCLKSEL11:2;
			unsigned short FCLKSEL10:2;
			unsigned short FCLKSEL9:2;
			unsigned short FCLKSEL8:2;
		} BIT;
	} IRQFLTC1;
	char           wk11[104];
	union {
		unsigned char BYTE;
		struct {
			unsigned char :2;
			unsigned char LVD2ST:1;
			unsigned char LVD1ST:1;
			unsigned char IWDTST:1;
			unsigned char WDTST:1;
			unsigned char OSTST:1;
			unsigned char NMIST:1;
		} BIT;
	} NMISR;
	union {
		unsigned char BYTE;
		struct {
			unsigned char :2;
			unsigned char LVD2EN:1;
			unsigned char LVD1EN:1;
			unsigned char IWDTEN:1;
			unsigned char WDTEN:1;
			unsigned char OSTEN:1;
			unsigned char NMIEN:1;
		} BIT;
	} NMIER;
	union {
		unsigned char BYTE;
		struct {
			unsigned char :2;
			unsigned char LVD2CLR:1;
			unsigned char LVD1CLR:1;
			unsigned char IWDTCLR:1;
			unsigned char WDTCLR:1;
			unsigned char OSTCLR:1;
			unsigned char NMICLR:1;
		} BIT;
	} NMICLR;
	union {
		unsigned char BYTE;
		struct {
			unsigned char :4;
			unsigned char NMIMD:1;
		} BIT;
	} NMICR;
	char           wk12[12];
	union {
		unsigned char BYTE;
		struct {
			unsigned char :7;
			unsigned char NFLTEN:1;
		} BIT;
	} NMIFLTE;
	char           wk13[3];
	union {
		unsigned char BYTE;
		struct {
			unsigned char :6;
			unsigned char NFCLKSEL:2;
		} BIT;
	} NMIFLTC;
	char           wk14[19819];
	union {
		unsigned long LONG;
		struct {
			unsigned long :16;
			unsigned long IS15:1;
			unsigned long IS14:1;
			unsigned long IS13:1;
			unsigned long IS12:1;
			unsigned long IS11:1;
			unsigned long IS10:1;
			unsigned long IS9:1;
			unsigned long IS8:1;
			unsigned long IS7:1;
			unsigned long IS6:1;
			unsigned long IS5:1;
			unsigned long IS4:1;
			unsigned long IS3:1;
			unsigned long IS2:1;
			unsigned long IS1:1;
			unsigned long IS0:1;
		} BIT;
	} GRP[13];
	char           wk15[12];
	union {
		unsigned long LONG;
		struct {
			unsigned long :16;
			unsigned long EN15:1;
			unsigned long EN14:1;
			unsigned long EN13:1;
			unsigned long EN12:1;
			unsigned long EN11:1;
			unsigned long EN10:1;
			unsigned long EN9:1;
			unsigned long EN8:1;
			unsigned long EN7:1;
			unsigned long EN6:1;
			unsigned long EN5:1;
			unsigned long EN4:1;
			unsigned long EN3:1;
			unsigned long EN2:1;
			unsigned long EN1:1;
			unsigned long EN0:1;
		} BIT;
	} GEN[13];
	char           wk16[12];
	union {
		unsigned long LONG;
		struct {
			unsigned long :16;
			unsigned long CLR15:1;
			unsigned long CLR14:1;
			unsigned long CLR13:1;
			unsigned long CLR12:1;
			unsigned long CLR11:1;
			unsigned long CLR10:1;
			unsigned long CLR9:1;
			unsigned long CLR8:1;
			unsigned long CLR7:1;
			unsigned long CLR6:1;
			unsigned long CLR5:1;
			unsigned long CLR4:1;
			unsigned long CLR3:1;
			unsigned long CLR2:1;
			unsigned long CLR1:1;
			unsigned long CLR0:1;
		} BIT;
	} GCR[13];
	char           wk17[12];
	union {
		unsigned long LONG;
		struct {
			unsigned long :26;
			unsigned long CN5:1;
			unsigned long CN4:1;
			unsigned long CN3:1;
			unsigned long CN2:1;
			unsigned long CN1:1;
			unsigned long CN0:1;
		} BIT;
	} SEL;
};

struct st_ieb {
	union {
		unsigned char BYTE;
		struct {
			unsigned char :1;
			unsigned char IOL:1;
			unsigned char DEE:1;
			unsigned char :1;
			unsigned char RE:1;
		} BIT;
	} IECTR;
	union {
		unsigned char BYTE;
		struct {
			unsigned char :5;
			unsigned char CMD:3;
		} BIT;
	} IECMR;
	union {
		unsigned char BYTE;
		struct {
			unsigned char SS:1;
			unsigned char RN:3;
			unsigned char CTL:4;
		} BIT;
	} IEMCR;
	union {
		unsigned char BYTE;
		struct {
			unsigned char IARL4:4;
			unsigned char IMD:2;
			unsigned char :1;
			unsigned char STE:1;
		} BIT;
	} IEAR1;
	union {
		unsigned char BYTE;
		struct {
			unsigned char IARU8:8;
		} BIT;
	} IEAR2;
	union {
		unsigned char BYTE;
		struct {
			unsigned char ISAL4:4;
		} BIT;
	} IESA1;
	union {
		unsigned char BYTE;
		struct {
			unsigned char ISAU8:8;
		} BIT;
	} IESA2;
	union {
		unsigned char BYTE;
		struct {
			unsigned char IBFL:8;
		} BIT;
	} IETBFL;
	char           wk0[1];
	union {
		unsigned char BYTE;
		struct {
			unsigned char IMAL4:4;
		} BIT;
	} IEMA1;
	union {
		unsigned char BYTE;
		struct {
			unsigned char IMAU8:8;
		} BIT;
	} IEMA2;
	union {
		unsigned char BYTE;
		struct {
			unsigned char :4;
			unsigned char RCTL:4;
		} BIT;
	} IERCTL;
	union {
		unsigned char BYTE;
		struct {
			unsigned char RBFL:8;
		} BIT;
	} IERBFL;
	char           wk1[1];
	union {
		unsigned char BYTE;
		struct {
			unsigned char ILAL8:8;
		} BIT;
	} IELA1;
	union {
		unsigned char BYTE;
		struct {
			unsigned char :4;
			unsigned char ILAU4:4;
		} BIT;
	} IELA2;
	union {
		unsigned char BYTE;
		struct {
			unsigned char CMX:1;
			unsigned char MRQ:1;
			unsigned char SRQ:1;
			unsigned char SRE:1;
			unsigned char LCK:1;
			unsigned char :1;
			unsigned char RSS:1;
			unsigned char GG:1;
		} BIT;
	} IEFLG;
	union {
		unsigned char BYTE;
		struct {
			unsigned char :1;
			unsigned char TXS:1;
			unsigned char TXF:1;
			unsigned char :1;
			unsigned char TXEAL:1;
			unsigned char TXETTME:1;
			unsigned char TXERO:1;
			unsigned char TXEACK:1;
		} BIT;
	} IETSR;
	union {
		unsigned char BYTE;
		struct {
			unsigned char :1;
			unsigned char TXSE:1;
			unsigned char TXFE:1;
			unsigned char :1;
			unsigned char TXEALE:1;
			unsigned char TXETTMEE:1;
			unsigned char TXEROE:1;
			unsigned char TXEACKE:1;
		} BIT;
	} IEIET;
	char           wk2[1];
	union {
		unsigned char BYTE;
		struct {
			unsigned char RXBSY:1;
			unsigned char RXS:1;
			unsigned char RXF:1;
			unsigned char RXEDE:1;
			unsigned char RXEOVE:1;
			unsigned char RXERTME:1;
			unsigned char RXEDLE:1;
			unsigned char RXEPE:1;
		} BIT;
	} IERSR;
	union {
		unsigned char BYTE;
		struct {
			unsigned char RXBSYE:1;
			unsigned char RXSE:1;
			unsigned char RXFE:1;
			unsigned char RXEDEE:1;
			unsigned char RXEOVEE:1;
			unsigned char RXERTMEE:1;
			unsigned char RXEDLEE:1;
			unsigned char RXEPEE:1;
		} BIT;
	} IEIER;
	char           wk3[2];
	union {
		unsigned char BYTE;
		struct {
			unsigned char FLT:1;
			unsigned char FCKS:2;
			unsigned char CKS3:1;
			unsigned char SRSTP:1;
			unsigned char CKS:3;
		} BIT;
	} IECKSR;
	char           wk4[230];
	unsigned char  IETB[33];
	char           wk5[223];
	unsigned char  IERB[33];
};

struct st_iwdt {
	unsigned char  IWDTRR;
	char           wk0[1];
	union {
		unsigned short WORD;
		struct {
			unsigned short :2;
			unsigned short RPSS:2;
			unsigned short :2;
			unsigned short RPES:2;
			unsigned short CKS:4;
			unsigned short :2;
			unsigned short TOPS:2;
		} BIT;
	} IWDTCR;
	union {
		unsigned short WORD;
		struct {
			unsigned short REFEF:1;
			unsigned short UNDFF:1;
			unsigned short CNTVAL:14;
		} BIT;
	} IWDTSR;
	union {
		unsigned char BYTE;
		struct {
			unsigned char RSTIRQS:1;
		} BIT;
	} IWDTRCR;
	char           wk1[1];
	union {
		unsigned char BYTE;
		struct {
			unsigned char SLCSTP:1;
		} BIT;
	} IWDTCSTPR;
};

struct st_mpc {
	union {
		unsigned char BYTE;
		struct {
			unsigned char CS7E:1;
			unsigned char CS6E:1;
			unsigned char CS5E:1;
			unsigned char CS4E:1;
			unsigned char CS3E:1;
			unsigned char CS2E:1;
			unsigned char CS1E:1;
			unsigned char CS0E:1;
		} BIT;
	} PFCSE;
	char           wk0[1];
	union {
		unsigned char BYTE;
		struct {
			unsigned char CS3S:2;
			unsigned char CS2S:2;
			unsigned char CS1S:2;
			unsigned char :1;
			unsigned char CS0S:1;
		} BIT;
	} PFCSS0;
	union {
		unsigned char BYTE;
		struct {
			unsigned char CS7S:2;
			unsigned char CS6S:2;
			unsigned char CS5S:2;
			unsigned char CS4S:2;
		} BIT;
	} PFCSS1;
	union {
		unsigned char BYTE;
		struct {
			unsigned char A15E:1;
			unsigned char A14E:1;
			unsigned char A13E:1;
			unsigned char A12E:1;
			unsigned char A11E:1;
			unsigned char A10E:1;
			unsigned char A9E:1;
			unsigned char A8E:1;
		} BIT;
	} PFAOE0;
	union {
		unsigned char BYTE;
		struct {
			unsigned char A23E:1;
			unsigned char A22E:1;
			unsigned char A21E:1;
			unsigned char A20E:1;
			unsigned char A19E:1;
			unsigned char A18E:1;
			unsigned char A17E:1;
			unsigned char A16E:1;
		} BIT;
	} PFAOE1;
	union {
		unsigned char BYTE;
		struct {
			unsigned char WR32BC32E:1;
			unsigned char WR1BC1E:1;
			unsigned char DH32E:1;
			unsigned char DHE:1;
			unsigned char :2;
			unsigned char ADRHMS:1;
			unsigned char ADRLE:1;
		} BIT;
	} PFBCR0;
	union {
		unsigned char BYTE;
		struct {
			unsigned char :5;
			unsigned char ALEOE:1;
			unsigned char WAITS:2;
		} BIT;
	} PFBCR1;
	char           wk1[12];
	union {
		unsigned char BYTE;
		struct {
			unsigned char :5;
			unsigned char PUPHZS:1;
		} BIT;
	} PFUSB0;
	char           wk2[10];
	union {
		unsigned char BYTE;
		struct {
			unsigned char B0WI:1;
			unsigned char PFSWE:1;
		} BIT;
	} PWPR;
	char           wk3[32];
	union {
		unsigned char BYTE;
		struct {
			unsigned char ASEL:1;
			unsigned char ISEL:1;
			unsigned char :1;
			unsigned char PSEL:5;
		} BIT;
	} P00PFS;
	union {
		unsigned char BYTE;
		struct {
			unsigned char ASEL:1;
			unsigned char ISEL:1;
			unsigned char :1;
			unsigned char PSEL:5;
		} BIT;
	} P01PFS;
	union {
		unsigned char BYTE;
		struct {
			unsigned char ASEL:1;
			unsigned char ISEL:1;
			unsigned char :1;
			unsigned char PSEL:5;
		} BIT;
	} P02PFS;
	union {
		unsigned char BYTE;
		struct {
			unsigned char ASEL:1;
			unsigned char ISEL:1;
			unsigned char :1;
			unsigned char PSEL:5;
		} BIT;
	} P03PFS;
	char           wk4[1];
	union {
		unsigned char BYTE;
		struct {
			unsigned char ASEL:1;
			unsigned char ISEL:1;
			unsigned char :1;
			unsigned char PSEL:5;
		} BIT;
	} P05PFS;
	char           wk5[1];
	union {
		unsigned char BYTE;
		struct {
			unsigned char :1;
			unsigned char ISEL:1;
			unsigned char :1;
			unsigned char PSEL:5;
		} BIT;
	} P07PFS;
	union {
		unsigned char BYTE;
		struct {
			unsigned char :1;
			unsigned char ISEL:1;
			unsigned char :1;
			unsigned char PSEL:5;
		} BIT;
	} P10PFS;
	union {
		unsigned char BYTE;
		struct {
			unsigned char :1;
			unsigned char ISEL:1;
			unsigned char :1;
			unsigned char PSEL:5;
		} BIT;
	} P11PFS;
	union {
		unsigned char BYTE;
		struct {
			unsigned char :1;
			unsigned char ISEL:1;
			unsigned char :1;
			unsigned char PSEL:5;
		} BIT;
	} P12PFS;
	union {
		unsigned char BYTE;
		struct {
			unsigned char :1;
			unsigned char ISEL:1;
			unsigned char :1;
			unsigned char PSEL:5;
		} BIT;
	} P13PFS;
	union {
		unsigned char BYTE;
		struct {
			unsigned char :1;
			unsigned char ISEL:1;
			unsigned char :1;
			unsigned char PSEL:5;
		} BIT;
	} P14PFS;
	union {
		unsigned char BYTE;
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
			unsigned short INV:1;
		} BIT;
	} MPOPI;
	union {
		unsigned long LONG;
		struct {
			unsigned long :8;
			unsigned long HITI:8;
			unsigned long :12;
			unsigned long UHACI:3;
		} BIT;
	} MHITI;
	union {
		unsigned long LONG;
		struct {
			unsigned long :8;
			unsigned long HITD:8;
			unsigned long :12;
			unsigned long UHACD:3;
		} BIT;
	} MHITD;
};

struct st_mtu {
	union {
		unsigned char BYTE;
		struct {
			unsigned char :2;
			unsigned char OE4D:1;
			unsigned char OE4C:1;
			unsigned char OE3D:1;
			unsigned char OE4B:1;
			unsigned char OE4A:1;
			unsigned char OE3B:1;
		} BIT;
	} TOER;
	char           wk0[2];
	union {
		unsigned char BYTE;
		struct {
			unsigned char :1;
			unsigned char BDC:1;
			unsigned char N:1;
			unsigned char P:1;
			unsigned char FB:1;
			unsigned char WF:1;
			unsigned char VF:1;
			unsigned char UF:1;
		} BIT;
	} TGCR;
	union {
		unsigned char BYTE;
		struct {
			unsigned char :1;
			unsigned char PSYE:1;
			unsigned char :2;
			unsigned char TOCL:1;
			unsigned char TOCS:1;
			unsigned char OLSN:1;
			unsigned char OLSP:1;
		} BIT;
	} TOCR1;
	union {
		unsigned char BYTE;
		struct {
			unsigned char BF:2;
			unsigned char OLS3N:1;
			unsigned char OLS3P:1;
			unsigned char OLS2N:1;
			unsigned char OLS2P:1;
			unsigned char OLS1N:1;
			unsigned char OLS1P:1;
		} BIT;
	} TOCR2;
	char           wk1[4];
	unsigned short TCDR;
	unsigned short TDDR;
	char           wk2[8];
	unsigned short TCNTS;
	unsigned short TCBR;
	char           wk3[12];
	union {
		unsigned char BYTE;
		struct {
			unsigned char T3AEN:1;
			unsigned char T3ACOR:3;
			unsigned char T4VEN:1;
			unsigned char T4VCOR:3;
		} BIT;
	} TITCR;
	union {
		unsigned char BYTE;
		struct {
			unsigned char :1;
			unsigned char T3ACNT:3;
			unsigned char :1;
			unsigned char T4VCNT:3;
		} BIT;
	} TITCNT;
	union {
		unsigned char BYTE;
		struct {
			unsigned char :6;
			unsigned char BTE:2;
		} BIT;
	} TBTER;
	char           wk4[1];
	union {
		unsigned char BYTE;
		struct {
			unsigned char :7;
			unsigned char TDER:1;
		} BIT;
	} TDER;
	char           wk5[1];
	union {
		unsigned char BYTE;
		struct {
			unsigned char :2;
			unsigned char OLS3N:1;
			unsigned char OLS3P:1;
			unsigned char OLS2N:1;
			unsigned char OLS2P:1;
			unsigned char OLS1N:1;
			unsigned char OLS1P:1;
		} BIT;
	} TOLBR;
	char           wk6[41];
	union {
		unsigned char BYTE;
		struct {
			unsigned char CCE:1;
			unsigned char :6;
			unsigned char WRE:1;
		} BIT;
	} TWCR;
	char           wk7[31];
	union {
		unsigned char BYTE;
		struct {
			unsigned char CST4:1;
			unsigned char CST3:1;
			unsigned char :3;
			unsigned char CST2:1;
			unsigned char CST1:1;
			unsigned char CST0:1;
		} BIT;
	} TSTR;
	union {
		unsigned char BYTE;
		struct {
			unsigned char SYNC4:1;
			unsigned char SYNC3:1;
			unsigned char :3;
			unsigned char SYNC2:1;
			unsigned char SYNC1:1;
			unsigned char SYNC0:1;
		} BIT;
	} TSYR;
	char           wk8[2];
	union {
		unsigned char BYTE;
		struct {
			unsigned char :7;
			unsigned char RWE:1;
		} BIT;
	} TRWER;
};

struct st_mtu0 {
	union {
		unsigned char BYTE;
		struct {
			unsigned char :2;
			unsigned char NFCS:2;
			unsigned char NFDEN:1;
			unsigned char NFCEN:1;
			unsigned char NFBEN:1;
			unsigned char NFAEN:1;
		} BIT;
	} NFCR;
	char           wk0[111];
	union {
		unsigned char BYTE;
		struct {
			unsigned char CCLR:3;
			unsigned char CKEG:2;
			unsigned char TPSC:3;
		} BIT;
	} TCR;
	union {
		unsigned char BYTE;
		struct {
			unsigned char :1;
			unsigned char BFE:1;
			unsigned char BFB:1;
			unsigned char BFA:1;
			unsigned char MD:4;
		} BIT;
	} TMDR;
	union {
		unsigned char BYTE;
		struct {
			unsigned char IOB:4;
			unsigned char IOA:4;
		} BIT;
	} TIORH;
	union {
		unsigned char BYTE;
		struct {
			unsigned char IOD:4;
			unsigned char IOC:4;
		} BIT;
	} TIORL;
	union {
		unsigned char BYTE;
		struct {
			unsigned char TTGE:1;
			unsigned char :2;
			unsigned char TCIEV:1;
			unsigned char TGIED:1;
			unsigned char TGIEC:1;
			unsigned char TGIEB:1;
			unsigned char TGIEA:1;
		} BIT;
	} TIER;
	union {
		unsigned char BYTE;
		struct {
			unsigned char TCFD:1;
		} BIT;
	} TSR;
	unsigned short TCNT;
	unsigned short TGRA;
	unsigned short TGRB;
	unsigned short TGRC;
	unsigned short TGRD;
	char           wk1[16];
	unsigned short TGRE;
	unsigned short TGRF;
	union {
		unsigned char BYTE;
		struct {
			unsigned char :6;
			unsigned char TGIEF:1;
			unsigned char TGIEE:1;
		} BIT;
	} TIER2;
	char           wk2[1];
	union {
		unsigned char BYTE;
		struct {
			unsigned char :5;
			unsigned char TTSE:1;
			unsigned char TTSB:1;
			unsigned char TTSA:1;
		} BIT;
	} TBTM;
};

struct st_mtu1 {
	char           wk0[1];
	union {
		unsigned char BYTE;
		struct {
			unsigned char :2;
			unsigned char NFCS:2;
			unsigned char NFDEN:1;
			unsigned char NFCEN:1;
			unsigned char NFBEN:1;
			unsigned char NFAEN:1;
		} BIT;
	} NFCR;
	char           wk1[238];
	union {
		unsigned char BYTE;
		struct {
			unsigned char :1;
			unsigned char CCLR:2;
			unsigned char CKEG:2;
			unsigned char TPSC:3;
		} BIT;
	} TCR;
	union {
		unsigned char BYTE;
		struct {
			unsigned char :4;
			unsigned char MD:4;
		} BIT;
	} TMDR;
	union {
		unsigned char BYTE;
		struct {
			unsigned char IOB:4;
			unsigned char IOA:4;
		} BIT;
	} TIOR;
	char           wk2[1];
	union {
		unsigned char BYTE;
		struct {
			unsigned char TTGE:1;
			unsigned char :1;
			unsigned char TCIEU:1;
			unsigned char TCIEV:1;
			unsigned char :2;
			unsigned char TGIEB:1;
			unsigned char TGIEA:1;
		} BIT;
	} TIER;
	union {
		unsigned char BYTE;
		struct {
			unsigned char TCFD:1;
		} BIT;
	} TSR;
	unsigned short TCNT;
	unsigned short TGRA;
	unsigned short TGRB;
	char           wk3[4];
	union {
		unsigned char BYTE;
		struct {
			unsigned char :4;
			unsigned char I2BE:1;
			unsigned char I2AE:1;
			unsigned char I1BE:1;
			unsigned char I1AE:1;
		} BIT;
	} TICCR;
};

struct st_mtu2 {
	union {
		unsigned char BYTE;
		struct {
			unsigned char :2;
			unsigned char NFCS:2;
			unsigned char NFDEN:1;
			unsigned char NFCEN:1;
			unsigned char NFBEN:1;
			unsigned char NFAEN:1;
		} BIT;
	} NFCR;
	char           wk0[365];
	union {
		unsigned char BYTE;
		struct {
			unsigned char :1;
			unsigned char CCLR:2;
			unsigned char CKEG:2;
			unsigned char TPSC:3;
		} BIT;
	} TCR;
	union {
		unsigned char BYTE;
		struct {
			unsigned char :4;
			unsigned char MD:4;
		} BIT;
	} TMDR;
	union {
		unsigned char BYTE;
		struct {
			unsigned char IOB:4;
			unsigned char IOA:4;
		} BIT;
	} TIOR;
	char           wk1[1];
	union {
		unsigned char BYTE;
		struct {
			unsigned char TTGE:1;
			unsigned char :1;
			unsigned char TCIEU:1;
			unsigned char TCIEV:1;
			unsigned char :2;
			unsigned char TGIEB:1;
			unsigned char TGIEA:1;
		} BIT;
	} TIER;
	union {
		unsigned char BYTE;
		struct {
			unsigned char TCFD:1;
		} BIT;
	} TSR;
	unsigned short TCNT;
	unsigned short TGRA;
	unsigned short TGRB;
};

struct st_mtu3 {
	union {
		unsigned char BYTE;
		struct {
			unsigned char CCLR:3;
			unsigned char CKEG:2;
			unsigned char TPSC:3;
		} BIT;
	} TCR;
	char           wk0[1];
	union {
		unsigned char BYTE;
		struct {
			unsigned char :2;
			unsigned char BFB:1;
			unsigned char BFA:1;
			unsigned char MD:4;
		} BIT;
	} TMDR;
	char           wk1[1];
	union {
		unsigned char BYTE;
		struct {
			unsigned char IOB:4;
			unsigned char IOA:4;
		} BIT;
	} TIORH;
	union {
		unsigned char BYTE;
		struct {
			unsigned char IOD:4;
			unsigned char IOC:4;
		} BIT;
	} TIORL;
	char           wk2[2];
	union {
		unsigned char BYTE;
		struct {
			unsigned char TTGE:1;
			unsigned char :2;
			unsigned char TCIEV:1;
			unsigned char TGIED:1;
			unsigned char TGIEC:1;
			unsigned char TGIEB:1;
			unsigned char TGIEA:1;
		} BIT;
	} TIER;
	char           wk3[7];
	unsigned short TCNT;
	char           wk4[6];
	unsigned short TGRA;
	unsigned short TGRB;
	char           wk5[8];
	unsigned short TGRC;
	unsigned short TGRD;
	char           wk6[4];
	union {
		unsigned char BYTE;
		struct {
			unsigned char TCFD:1;
		} BIT;
	} TSR;
	char           wk7[11];
	union {
		unsigned char BYTE;
		struct {
			unsigned char :5;
			unsigned char TTSE:1;
			unsigned char TTSB:1;
			unsigned char TTSA:1;
		} BIT;
	} TBTM;
	char           wk8[90];
	union {
		unsigned char BYTE;
		struct {
			unsigned char :2;
			unsigned char NFCS:2;
			unsigned char NFDEN:1;
			unsigned char NFCEN:1;
			unsigned char NFBEN:1;
			unsigned char NFAEN:1;
		} BIT;
	} NFCR;
};

struct st_mtu4 {
	char           wk0[1];
	union {
		unsigned char BYTE;
		struct {
			unsigned char CCLR:3;
			unsigned char CKEG:2;
			unsigned char TPSC:3;
		} BIT;
	} TCR;
	char           wk1[1];
	union {
		unsigned char BYTE;
		struct {
			unsigned char :2;
			unsigned char BFB:1;
			unsigned char BFA:1;
			unsigned char MD:4;
		} BIT;
	} TMDR;
	char           wk2[2];
	union {
		unsigned char BYTE;
		struct {
			unsigned char IOB:4;
			unsigned char IOA:4;
		} BIT;
	} TIORH;
	union {
		unsigned char BYTE;
		struct {
			unsigned char IOD:4;
			unsigned char IOC:4;
		} BIT;
	} TIORL;
	char           wk3[1];
	union {
		unsigned char BYTE;
		struct {
			unsigned char TTGE:1;
			unsigned char TTGE2:1;
			unsigned char :1;
			unsigned char TCIEV:1;
			unsigned char TGIED:1;
			unsigned char TGIEC:1;
			unsigned char TGIEB:1;
			unsigned char TGIEA:1;
		} BIT;
	} TIER;
	char           wk4[8];
	unsigned short TCNT;
	char           wk5[8];
	unsigned short TGRA;
	unsigned short TGRB;
	char           wk6[8];
	unsigned short TGRC;
	unsigned short TGRD;
	char           wk7[1];
	union {
		unsigned char BYTE;
		struct {
			unsigned char TCFD:1;
		} BIT;
	} TSR;
	char           wk8[11];
	union {
		unsigned char BYTE;
		struct {
			unsigned char :5;
			unsigned char TTSE:1;
			unsigned char TTSB:1;
			unsigned char TTSA:1;
		} BIT;
	} TBTM;
	char           wk9[6];
	union {
		unsigned short WORD;
		struct {
			unsigned short BF:2;
			unsigned short :6;
			unsigned short UT4AE:1;
			unsigned short DT4AE:1;
			unsigned short UT4BE:1;
			unsigned short DT4BE:1;
			unsigned short ITA3AE:1;
			unsigned short ITA4VE:1;
			unsigned short ITB3AE:1;
			unsigned short ITB4VE:1;
		} BIT;
	} TADCR;
	char           wk10[2];
	unsigned short TADCORA;
	unsigned short TADCORB;
	unsigned short TADCOBRA;
	unsigned short TADCOBRB;
	char           wk11[72];
	union {
		unsigned char BYTE;
		struct {
			unsigned char :2;
			unsigned char NFCS:2;
			unsigned char NFDEN:1;
			unsigned char NFCEN:1;
			unsigned char NFBEN:1;
			unsigned char NFAEN:1;
		} BIT;
	} NFCR;
};

struct st_mtu5 {
	char           wk0[1];
	union {
		unsigned char BYTE;
		struct {
			unsigned char :2;
			unsigned char NFCS:2;
			unsigned char :1;
			unsigned char NFWEN:1;
			unsigned char NFVEN:1;
			unsigned char NFUEN:1;
		} BIT;
	} NFCR;
	char           wk1[490];
	unsigned short TCNTU;
	unsigned short TGRU;
	union {
		unsigned char BYTE;
		struct {
			unsigned char :6;
			unsigned char TPSC:2;
		} BIT;
	} TCRU;
	char           wk2[1];
	union {
		unsigned char BYTE;
		struct {
			unsigned char :3;
			unsigned char IOC:5;
		} BIT;
	} TIORU;
	char           wk3[9];
	unsigned short TCNTV;
	unsigned short TGRV;
	union {
		unsigned char BYTE;
		struct {
			unsigned char :6;
			unsigned char TPSC:2;
		} BIT;
	} TCRV;
	char           wk4[1];
	union {
		unsigned char BYTE;
		struct {
			unsigned char :3;
			unsigned char IOC:5;
		} BIT;
	} TIORV;
	char           wk5[9];
	unsigned short TCNTW;
	unsigned short TGRW;
	union {
		unsigned char BYTE;
		struct {
			unsigned char :6;
			unsigned char TPSC:2;
		} BIT;
	} TCRW;
	char           wk6[1];
	union {
		unsigned char BYTE;
		struct {
			unsigned char :3;
			unsigned char IOC:5;
		} BIT;
	} TIORW;
	char           wk7[11];
	union {
		unsigned char BYTE;
		struct {
			unsigned char :5;
			unsigned char TGIE5U:1;
			unsigned char TGIE5V:1;
			unsigned char TGIE5W:1;
		} BIT;
	} TIER;
	char           wk8[1];
	union {
		unsigned char BYTE;
		struct {
			unsigned char :5;
			unsigned char CSTU5:1;
			unsigned char CSTV5:1;
			unsigned char CSTW5:1;
		} BIT;
	} TSTR;
	char           wk9[1];
	union {
		unsigned char BYTE;
		struct {
			unsigned char :5;
			unsigned char CMPCLR5U:1;
			unsigned char CMPCLR5V:1;
			unsigned char CMPCLR5W:1;
		} BIT;
	} TCNTCMPCLR;
};

struct st_poe {
	union {
		unsigned short WORD;
		struct {
			unsigned short POE3F:1;
			unsigned short POE2F:1;
			unsigned short POE1F:1;
			unsigned short POE0F:1;
			unsigned short :3;
			unsigned short PIE1:1;
			unsigned short POE3M:2;
			unsigned short POE2M:2;
			unsigned short POE1M:2;
			unsigned short POE0M:2;
		} BIT;
	} ICSR1;
	union {
		unsigned short WORD;
		struct {
			unsigned short OSF1:1;
			unsigned short :5;
			unsigned short OCE1:1;
			unsigned short OIE1:1;
		} BIT;
	} OCSR1;
	char           wk0[4];
	union {
		unsigned short WORD;
		struct {
			unsigned short :3;
			unsigned short POE8F:1;
			unsigned short :2;
			unsigned short POE8E:1;
			unsigned short PIE2:1;
			unsigned short :6;
			unsigned short POE8M:2;
		} BIT;
	} ICSR2;
	union {
		unsigned char BYTE;
		struct {
			unsigned char :6;
			unsigned char CH0HIZ:1;
			unsigned char CH34HIZ:1;
		} BIT;
	} SPOER;
	union {
		unsigned char BYTE;
		struct {
			unsigned char :4;
			unsigned char PE3ZE:1;
			unsigned char PE2ZE:1;
			unsigned char PE1ZE:1;
			unsigned char PE0ZE:1;
		} BIT;
	} POECR1;
	union {
		unsigned char BYTE;
		struct {
			unsigned char :1;
			unsigned char P1CZEA:1;
			unsigned char P2CZEA:1;
			unsigned char P3CZEA:1;
		} BIT;
	} POECR2;
	char           wk1[1];
	union {
		unsigned short WORD;
		struct {
			unsigned short :3;
			unsigned short OSTSTF:1;
			unsigned short :2;
			unsigned short OSTSTE:1;
		} BIT;
	} ICSR3;
};

struct st_port0 {
	union {
		unsigned char BYTE;
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
		} BIT;
	} PODRH;
	union {
		unsigned char BYTE;
		struct {
			unsigned char POD7:1;
			unsigned char POD6:1;
			unsigned char POD5:1;
			unsigned char POD4:1;
			unsigned char POD3:1;
			unsigned char POD2:1;
			unsigned char POD1:1;
			unsigned char POD0:1;
		} BIT;
	} PODRL;
	union {
		unsigned char BYTE;
		struct {
			unsigned char NDR15:1;
			unsigned char NDR14:1;
			unsigned char NDR13:1;
			unsigned char NDR12:1;
			unsigned char NDR11:1;
			unsigned char NDR10:1;
			unsigned char NDR9:1;
			unsigned char NDR8:1;
		} BIT;
	} NDRH;
	union {
		unsigned char BYTE;
		struct {
			unsigned char NDR7:1;
			unsigned char NDR6:1;
			unsigned char NDR5:1;
			unsigned char NDR4:1;
			unsigned char NDR3:1;
			unsigned char NDR2:1;
			unsigned char NDR1:1;
			unsigned char NDR0:1;
		} BIT;
	} NDRL;
	union {
		unsigned char BYTE;
		struct {
			unsigned char :4;
			unsigned char NDR11:1;
			unsigned char NDR10:1;
			unsigned char NDR9:1;
			unsigned char NDR8:1;
		} BIT;
	} NDRH2;
	union {
		unsigned char BYTE;
		struct {
			unsigned char :4;
			unsigned char NDR3:1;
			unsigned char NDR2:1;
			unsigned char NDR1:1;
			unsigned char NDR0:1;
		} BIT;
	} NDRL2;
};
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
