tonuonu/NASA-Sample-Return-Robot/PowerSupply/Code/tnroman.h

// font data

const unsigned char Ascii_1[][5] = {			   // Refer to "Times New Roman" Font Database...


	//   Basic Characters
    {0x00, 0x00, 0x4F, 0x00, 0x00},			   //   ( 01)
    {0x00, 0x00, 0x4F, 0x00, 0x00},			   //   ( 02)
    {0x00, 0x00, 0x4F, 0x00, 0x00},			   //   ( 03)
    {0x00, 0x00, 0x4F, 0x00, 0x00},			   //   ( 04)
    {0x00, 0x00, 0x4F, 0x00, 0x00},			   //   ( 05)
    {0x00, 0x00, 0x4F, 0x00, 0x00},			   //   ( 06)
    {0x00, 0x00, 0x4F, 0x00, 0x00},			   //   ( 07)
    {0x00, 0x00, 0x4F, 0x00, 0x00},			   //   ( 08)
    {0x00, 0x00, 0x4F, 0x00, 0x00},			   //   ( 09)
    {0x00, 0x00, 0x4F, 0x00, 0x00},			   //   ( 00)
    {0x00, 0x00, 0x4F, 0x00, 0x00},			   //   ( 01)
    {0x00, 0x00, 0x4F, 0x00, 0x00},			   //   ( 02)
    {0x00, 0x00, 0x4F, 0x00, 0x00},			   //   ( 03)
    {0x00, 0x00, 0x4F, 0x00, 0x00},			   //   ( 04)
    {0x00, 0x00, 0x4F, 0x00, 0x00},			   //   ( 05)
    {0x00, 0x00, 0x4F, 0x00, 0x00},			   //   ( 06)
    {0x00, 0x00, 0x4F, 0x00, 0x00},			   //   ( 07)
    {0x00, 0x00, 0x4F, 0x00, 0x00},			   //   ( 08)
    {0x00, 0x00, 0x4F, 0x00, 0x00},			   //   ( 09)
    {0x00, 0x00, 0x4F, 0x00, 0x00},			   //   ( 00)
    {0x00, 0x00, 0x4F, 0x00, 0x00},			   //   ( 01)
    {0x00, 0x00, 0x4F, 0x00, 0x00},			   //   ( 02)
    {0x00, 0x00, 0x4F, 0x00, 0x00},			   //   ( 03)
    {0x00, 0x00, 0x4F, 0x00, 0x00},			   //   ( 04)
    {0x00, 0x00, 0x4F, 0x00, 0x00},			   //   ( 05)
    {0x00, 0x00, 0x4F, 0x00, 0x00},			   //   ( 06)
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
    {0x17, 0x08, 0x04, 0x6A, 0x59},			   //   (120) /2 - 0x00BD Vulgar Fraction One Half
    {0x30, 0x48, 0x45, 0x40, 0x20},			   //   (121)  ? - 0x00BF Inverted Question Mark
    {0x70, 0x29, 0x26, 0x28, 0x70},			   //   (122) `A - 0x00C0 Latin Capital Letter A with Grave
    {0x70, 0x28, 0x26, 0x29, 0x70},			   //   (123) 'A - 0x00C1 Latin Capital Letter A with Acute
    {0x70, 0x2A, 0x25, 0x2A, 0x70},			   //   (124) ^A - 0x00C2 Latin Capital Letter A with Circumflex
    {0x72, 0x29, 0x26, 0x29, 0x70},			   //   (125) ~A - 0x00C3 Latin Capital Letter A with Tilde
    {0x70, 0x29, 0x24, 0x29, 0x70},			   //   (126) "A - 0x00C4 Latin Capital Letter A with Diaeresis
    {0x70, 0x2A, 0x2D, 0x2A, 0x70},			   //   (127)  A - 0x00C5 Latin Capital Letter A with Ring Above
    {0x7E, 0x11, 0x7F, 0x49, 0x49},			   //   (128) AE - 0x00C6 Latin Capital Letter Ae
    {0x0E, 0x51, 0x51, 0x71, 0x11},			   //   (129)  C - 0x00C7 Latin Capital Letter C with Cedilla
    {0x7C, 0x55, 0x56, 0x54, 0x44},			   //   (130) `E - 0x00C8 Latin Capital Letter E with Grave
    {0x7C, 0x55, 0x56, 0x54, 0x44},			   //   (131) 'E - 0x00C9 Latin Capital Letter E with Acute
    {0x7C, 0x56, 0x55, 0x56, 0x44},			   //   (132) ^E - 0x00CA Latin Capital Letter E with Circumflex
    {0x7C, 0x55, 0x54, 0x55, 0x44},			   //   (133) "E - 0x00CB Latin Capital Letter E with Diaeresis
    {0x00, 0x45, 0x7E, 0x44, 0x00},			   //   (134) `I - 0x00CC Latin Capital Letter I with Grave
    {0x00, 0x44, 0x7E, 0x45, 0x00},			   //   (135) 'I - 0x00CD Latin Capital Letter I with Acute
    {0x00, 0x46, 0x7D, 0x46, 0x00},			   //   (136) ^I - 0x00CE Latin Capital Letter I with Circumflex
    {0x00, 0x45, 0x7C, 0x45, 0x00},			   //   (137) "I - 0x00CF Latin Capital Letter I with Diaeresis
    {0x7F, 0x49, 0x49, 0x41, 0x3E},			   //   (138)  D - 0x00D0 Latin Capital Letter Eth
    {0x7C, 0x0A, 0x11, 0x22, 0x7D},			   //   (139) ~N - 0x00D1 Latin Capital Letter N with Tilde
    {0x38, 0x45, 0x46, 0x44, 0x38},			   //   (140) `O - 0x00D2 Latin Capital Letter O with Grave
    {0x38, 0x44, 0x46, 0x45, 0x38},			   //   (141) 'O - 0x00D3 Latin Capital Letter O with Acute
    {0x38, 0x46, 0x45, 0x46, 0x38},			   //   (142) ^O - 0x00D4 Latin Capital Letter O with Circumflex
    {0x38, 0x46, 0x45, 0x46, 0x39},			   //   (143) ~O - 0x00D5 Latin Capital Letter O with Tilde
    {0x38, 0x45, 0x44, 0x45, 0x38},			   //   (144) "O - 0x00D6 Latin Capital Letter O with Diaeresis
    {0x22, 0x14, 0x08, 0x14, 0x22},			   //   (145)  x - 0x00D7 Multiplcation Sign
    {0x2E, 0x51, 0x49, 0x45, 0x3A},			   //   (146)  O - 0x00D8 Latin Capital Letter O with Stroke
    {0x3C, 0x41, 0x42, 0x40, 0x3C},			   //   (147) `U - 0x00D9 Latin Capital Letter U with Grave
    {0x3C, 0x40, 0x42, 0x41, 0x3C},			   //   (148) 'U - 0x00DA Latin Capital Letter U with Acute
    {0x3C, 0x42, 0x41, 0x42, 0x3C},			   //   (149) ^U - 0x00DB Latin Capital Letter U with Circumflex
    {0x3C, 0x41, 0x40, 0x41, 0x3C},			   //   (150) "U - 0x00DC Latin Capital Letter U with Diaeresis
    {0x0C, 0x10, 0x62, 0x11, 0x0C},			   //   (151) `Y - 0x00DD Latin Capital Letter Y with Acute
    {0x7F, 0x12, 0x12, 0x12, 0x0C},			   //   (152)  P - 0x00DE Latin Capital Letter Thom
    {0x40, 0x3E, 0x01, 0x49, 0x36},			   //   (153)  B - 0x00DF Latin Capital Letter Sharp S
    {0x20, 0x55, 0x56, 0x54, 0x78},			   //   (154) `a - 0x00E0 Latin Small Letter A with Grave
    {0x20, 0x54, 0x56, 0x55, 0x78},			   //   (155) 'a - 0x00E1 Latin Small Letter A with Acute
    {0x20, 0x56, 0x55, 0x56, 0x78},			   //   (156) ^a - 0x00E2 Latin Small Letter A with Circumflex
    {0x20, 0x55, 0x56, 0x55, 0x78},			   //   (157) ~a - 0x00E3 Latin Small Letter A with Tilde
    {0x20, 0x55, 0x54, 0x55, 0x78},			   //   (158) "a - 0x00E4 Latin Small Letter A with Diaeresis
    {0x20, 0x56, 0x57, 0x56, 0x78},			   //   (159)  a - 0x00E5 Latin Small Letter A with Ring Above
    {0x24, 0x54, 0x78, 0x54, 0x58},			   //   (160) ae - 0x00E6 Latin Small Letter Ae
    {0x0C, 0x52, 0x52, 0x72, 0x13},			   //   (161)  c - 0x00E7 Latin Small Letter c with Cedilla
    {0x38, 0x55, 0x56, 0x54, 0x18},			   //   (162) `e - 0x00E8 Latin Small Letter E with Grave
    {0x38, 0x54, 0x56, 0x55, 0x18},			   //   (163) 'e - 0x00E9 Latin Small Letter E with Acute
    {0x38, 0x56, 0x55, 0x56, 0x18},			   //   (164) ^e - 0x00EA Latin Small Letter E with Circumflex
    {0x38, 0x55, 0x54, 0x55, 0x18},			   //   (165) "e - 0x00EB Latin Small Letter E with Diaeresis
    {0x00, 0x49, 0x7A, 0x40, 0x00},			   //   (166) `i - 0x00EC Latin Small Letter I with Grave
    {0x00, 0x48, 0x7A, 0x41, 0x00},			   //   (167) 'i - 0x00ED Latin Small Letter I with Acute
    {0x00, 0x4A, 0x79, 0x42, 0x00},			   //   (168) ^i - 0x00EE Latin Small Letter I with Circumflex
    {0x00, 0x4A, 0x78, 0x42, 0x00},			   //   (169) "i - 0x00EF Latin Small Letter I with Diaeresis
    {0x31, 0x4A, 0x4E, 0x4A, 0x30},			   //   (170)    - 0x00F0 Latin Small Letter Eth
    {0x7A, 0x11, 0x0A, 0x09, 0x70},			   //   (171) ~n - 0x00F1 Latin Small Letter N with Tilde
    {0x30, 0x49, 0x4A, 0x48, 0x30},			   //   (172) `o - 0x00F2 Latin Small Letter O with Grave
    {0x30, 0x48, 0x4A, 0x49, 0x30},			   //   (173) 'o - 0x00F3 Latin Small Letter O with Acute
    {0x30, 0x4A, 0x49, 0x4A, 0x30},			   //   (174) ^o - 0x00F4 Latin Small Letter O with Circumflex
    {0x30, 0x4A, 0x49, 0x4A, 0x31},			   //   (175) ~o - 0x00F5 Latin Small Letter O with Tilde
    {0x30, 0x4A, 0x48, 0x4A, 0x30},			   //   (176) "o - 0x00F6 Latin Small Letter O with Diaeresis
    {0x08, 0x08, 0x2A, 0x08, 0x08},			   //   (177)  + - 0x00F7 Division Sign
    {0x38, 0x64, 0x54, 0x4C, 0x38},			   //   (178)  o - 0x00F8 Latin Small Letter O with Stroke
    {0x38, 0x41, 0x42, 0x20, 0x78},			   //   (179) `u - 0x00F9 Latin Small Letter U with Grave
    {0x38, 0x40, 0x42, 0x21, 0x78},			   //   (180) 'u - 0x00FA Latin Small Letter U with Acute
    {0x38, 0x42, 0x41, 0x22, 0x78},			   //   (181) ^u - 0x00FB Latin Small Letter U with Circumflex
    {0x38, 0x42, 0x40, 0x22, 0x78},			   //   (182) "u - 0x00FC Latin Small Letter U with Diaeresis
    {0x0C, 0x50, 0x52, 0x51, 0x3C},			   //   (183) 'y - 0x00FD Latin Small Letter Y with Acute
    {0x7E, 0x14, 0x14, 0x14, 0x08},			   //   (184)  p - 0x00FE Latin Small Letter Thom
    {0x0C, 0x51, 0x50, 0x51, 0x3C},			   //   (185) "y - 0x00FF Latin Small Letter Y with Diaeresis
    {0x1E, 0x09, 0x09, 0x29, 0x5E},			   //   (186)  A - 0x0104 Latin Capital Letter A with Ogonek
    {0x08, 0x15, 0x15, 0x35, 0x4E},			   //   (187)  a - 0x0105 Latin Small Letter A with Ogonek
    {0x38, 0x44, 0x46, 0x45, 0x20},			   //   (188) 'C - 0x0106 Latin Capital Letter C with Acute
    {0x30, 0x48, 0x4A, 0x49, 0x20},			   //   (189) 'c - 0x0107 Latin Small Letter C with Acute
    {0x38, 0x45, 0x46, 0x45, 0x20},			   //   (190)  C - 0x010C Latin Capital Letter C with Caron
    {0x30, 0x49, 0x4A, 0x49, 0x20},			   //   (191)  c - 0x010D Latin Small Letter C with Caron
    {0x7C, 0x45, 0x46, 0x45, 0x38},			   //   (192)  D - 0x010E Latin Capital Letter D with Caron
    {0x20, 0x50, 0x50, 0x7C, 0x03},			   //   (193) d' - 0x010F Latin Small Letter D with Caron
    {0x1F, 0x15, 0x15, 0x35, 0x51},			   //   (194)  E - 0x0118 Latin Capital Letter E with Ogonek
    {0x0E, 0x15, 0x15, 0x35, 0x46},			   //   (195)  e - 0x0119 Latin Small Letter E with Ogonek
    {0x7C, 0x55, 0x56, 0x55, 0x44},			   //   (196)  E - 0x011A Latin Capital Letter E with Caron
    {0x38, 0x55, 0x56, 0x55, 0x18},			   //   (197)  e - 0x011B Latin Small Letter E with Caron
    {0x00, 0x44, 0x7C, 0x40, 0x00},			   //   (198)  i - 0x0131 Latin Small Letter Dotless I
    {0x7F, 0x48, 0x44, 0x40, 0x40},			   //   (199)  L - 0x0141 Latin Capital Letter L with Stroke
    {0x00, 0x49, 0x7F, 0x44, 0x00},			   //   (200)  l - 0x0142 Latin Small Letter L with Stroke
    {0x7C, 0x08, 0x12, 0x21, 0x7C},			   //   (201) 'N - 0x0143 Latin Capital Letter N with Acute
    {0x78, 0x10, 0x0A, 0x09, 0x70},			   //   (202) 'n - 0x0144 Latin Small Letter N with Acute
    {0x7C, 0x09, 0x12, 0x21, 0x7C},			   //   (203)  N - 0x0147 Latin Capital Letter N with Caron
    {0x78, 0x11, 0x0A, 0x09, 0x70},			   //   (204)  n - 0x0148 Latin Small Letter N with Caron
    {0x38, 0x47, 0x44, 0x47, 0x38},			   //   (205) "O - 0x0150 Latin Capital Letter O with Double Acute
    {0x30, 0x4B, 0x48, 0x4B, 0x30},			   //   (206) "o - 0x0151 Latin Small Letter O with Double Acute
    {0x3E, 0x41, 0x7F, 0x49, 0x49},			   //   (207) OE - 0x0152 Latin Capital Ligature Oe
    {0x38, 0x44, 0x38, 0x54, 0x58},			   //   (208) oe - 0x0153 Latin Small Ligature Oe
    {0x7C, 0x15, 0x16, 0x35, 0x48},			   //   (209)  R - 0x0158 Latin Capital Letter R with Caron
    {0x78, 0x11, 0x0A, 0x09, 0x10},			   //   (210)  r - 0x0159 Latin Small Letter R with Caron
    {0x48, 0x54, 0x56, 0x55, 0x20},			   //   (211) 'S - 0x015A Latin Capital Letter S with Acute
    {0x20, 0x48, 0x56, 0x55, 0x20},			   //   (212) 's - 0x015B Latin Small Letter S with Acute
    {0x48, 0x55, 0x56, 0x55, 0x20},			   //   (213)  S - 0x0160 Latin Capital Letter S with Caron
    {0x20, 0x49, 0x56, 0x55, 0x20},			   //   (214)  s - 0x0161 Latin Small Letter S with Caron
    {0x04, 0x05, 0x7E, 0x05, 0x04},			   //   (215)  T - 0x0164 Latin Capital Letter T with Caron
    {0x08, 0x3C, 0x48, 0x22, 0x01},			   //   (216) t' - 0x0165 Latin Small Letter T with Caron
    {0x3C, 0x42, 0x45, 0x42, 0x3C},			   //   (217)  U - 0x016E Latin Capital Letter U with Ring Above
    {0x38, 0x42, 0x45, 0x22, 0x78},			   //   (218)  u - 0x016F Latin Small Letter U with Ring Above
    {0x3C, 0x43, 0x40, 0x43, 0x3C},			   //   (219) "U - 0x0170 Latin Capital Letter U with Double Acute
    {0x38, 0x43, 0x40, 0x23, 0x78},			   //   (220) "u - 0x0171 Latin Small Letter U with Double Acute
    {0x0C, 0x11, 0x60, 0x11, 0x0C},			   //   (221) "Y - 0x0178 Latin Capital Letter Y with Diaeresis
    {0x44, 0x66, 0x55, 0x4C, 0x44},			   //   (222) 'Z - 0x0179 Latin Capital Letter Z with Acute
    {0x48, 0x6A, 0x59, 0x48, 0x00},			   //   (223) 'z - 0x017A Latin Small Letter Z with Acute
    {0x44, 0x64, 0x55, 0x4C, 0x44},			   //   (224)  Z - 0x017B Latin Capital Letter Z with Dot Above
    {0x48, 0x68, 0x5A, 0x48, 0x00},			   //   (225)  z - 0x017C Latin Small Letter Z with Dot Above
    {0x44, 0x65, 0x56, 0x4D, 0x44},			   //   (226)  Z - 0x017D Latin Capital Letter Z with Caron
    {0x48, 0x69, 0x5A, 0x49, 0x00},			   //   (227)  z - 0x017E Latin Small Letter Z with Caron
    {0x00, 0x02, 0x01, 0x02, 0x00},			   //   (228)  ^ - 0x02C6 Modifier Letter Circumflex Accent
    {0x00, 0x01, 0x02, 0x01, 0x00},			   //   (229)    - 0x02C7 Caron
    {0x00, 0x01, 0x01, 0x01, 0x00},			   //   (230)    - 0x02C9 Modifier Letter Macron
    {0x01, 0x02, 0x02, 0x01, 0x00},			   //   (231)    - 0x02D8 Breve
    {0x00, 0x00, 0x01, 0x00, 0x00},			   //   (232)    - 0x02D9 Dot Above
    {0x00, 0x02, 0x05, 0x02, 0x00},			   //   (233)    - 0x02DA Ring Above
    {0x02, 0x01, 0x02, 0x01, 0x00},			   //   (234)  ~ - 0x02DC Small Tilde
    {0x7F, 0x05, 0x15, 0x3A, 0x50},			   //   (235) Pt - 0x20A7 Peseta Sign
    {0x3E, 0x55, 0x55, 0x41, 0x22},			   //   (236)  C - 0x20AC Euro Sign
    {0x18, 0x14, 0x08, 0x14, 0x0C},			   //   (237)    - 0x221E Infinity
    {0x44, 0x4A, 0x4A, 0x51, 0x51},			   //   (238)  < - 0x2264 Less-Than or Equal to
    {0x51, 0x51, 0x4A, 0x4A, 0x44},			   //   (239)  > - 0x2265 Greater-Than or Equal to
    {0x74, 0x42, 0x41, 0x42, 0x74},			   //   (240)    - 0x2302 House
};

#if 0
const unsigned char Ascii_2[107][5] = {		   // Refer to "Times New Roman" Font Database...
    //   Greek & Japanese Letters
    {0x7E, 0x11, 0x11, 0x11, 0x7E},			   //   (  1)  A - 0x0391 Greek Capital Letter Alpha
    {0x7F, 0x49, 0x49, 0x49, 0x36},			   //   (  2)  B - 0x0392 Greek Capital Letter Beta
    {0x7F, 0x02, 0x01, 0x01, 0x03},			   //   (  3)    - 0x0393 Greek Capital Letter Gamma
    {0x70, 0x4E, 0x41, 0x4E, 0x70},			   //   (  4)    - 0x0394 Greek Capital Letter Delta
    {0x7F, 0x49, 0x49, 0x49, 0x41},			   //   (  5)  E - 0x0395 Greek Capital Letter Epsilon
    {0x61, 0x51, 0x49, 0x45, 0x43},			   //   (  6)  Z - 0x0396 Greek Capital Letter Zeta
    {0x7F, 0x08, 0x08, 0x08, 0x7F},			   //   (  7)  H - 0x0397 Greek Capital Letter Eta
    {0x3E, 0x49, 0x49, 0x49, 0x3E},			   //   (  8)    - 0x0398 Greek Capital Letter Theta
    {0x00, 0x41, 0x7F, 0x41, 0x00},			   //   (  9)  I - 0x0399 Greek Capital Letter Iota
    {0x7F, 0x08, 0x14, 0x22, 0x41},			   //   ( 10)  K - 0x039A Greek Capital Letter Kappa
    {0x70, 0x0E, 0x01, 0x0E, 0x70},			   //   ( 11)    - 0x039B Greek Capital Letter Lamda
    {0x7F, 0x02, 0x0C, 0x02, 0x7F},			   //   ( 12)  M - 0x039C Greek Capital Letter Mu
    {0x7F, 0x04, 0x08, 0x10, 0x7F},			   //   ( 13)  N - 0x039D Greek Capital Letter Nu
    {0x63, 0x5D, 0x49, 0x5D, 0x63},			   //   ( 14)    - 0x039E Greek Capital Letter Xi
    {0x3E, 0x41, 0x41, 0x41, 0x3E},			   //   ( 15)  O - 0x039F Greek Capital Letter Omicron
    {0x41, 0x3F, 0x01, 0x3F, 0x41},			   //   ( 16)    - 0x03A0 Greek Capital Letter Pi
    {0x7F, 0x09, 0x09, 0x09, 0x06},			   //   ( 17)  P - 0x03A1 Greek Capital Letter Rho
    {0x63, 0x55, 0x49, 0x41, 0x41},			   //   ( 18)    - 0x03A3 Greek Capital Letter Sigma
    {0x01, 0x01, 0x7F, 0x01, 0x01},			   //   ( 19)  T - 0x03A4 Greek Capital Letter Tau
    {0x03, 0x01, 0x7E, 0x01, 0x03},			   //   ( 20)    - 0x03A5 Greek Capital Letter Upsilon
    {0x08, 0x55, 0x7F, 0x55, 0x08},			   //   ( 21)    - 0x03A6 Greek Capital Letter Phi
    {0x63, 0x14, 0x08, 0x14, 0x63},			   //   ( 22)  X - 0x03A7 Greek Capital Letter Chi
    {0x07, 0x48, 0x7F, 0x48, 0x07},			   //   ( 23)    - 0x03A8 Greek Capital Letter Psi
    {0x5E, 0x61, 0x01, 0x61, 0x5E},			   //   ( 24)    - 0x03A9 Greek Capital Letter Omega
    {0x38, 0x44, 0x48, 0x30, 0x4C},			   //   ( 25)  a - 0x03B1 Greek Small Letter Alpha
    {0x7C, 0x2A, 0x2A, 0x2A, 0x14},			   //   ( 26)  B - 0x03B2 Greek Small Letter Beta
    {0x44, 0x38, 0x04, 0x04, 0x08},			   //   ( 27)  r - 0x03B3 Greek Small Letter Gamma
    {0x30, 0x4B, 0x4D, 0x59, 0x30},			   //   ( 28)    - 0x03B4 Greek Small Letter Delta
    {0x28, 0x54, 0x54, 0x44, 0x20},			   //   ( 29)    - 0x03B5 Greek Small Letter Epsilon
    {0x00, 0x18, 0x55, 0x52, 0x22},			   //   ( 30)    - 0x03B6 Greek Small Letter Zeta
    {0x3E, 0x04, 0x02, 0x02, 0x7C},			   //   ( 31)  n - 0x03B7 Greek Small Letter Eta
    {0x3C, 0x4A, 0x4A, 0x4A, 0x3C},			   //   ( 32)    - 0x03B8 Greek Small Letter Theta
    {0x00, 0x3C, 0x40, 0x20, 0x00},			   //   ( 33)  i - 0x03B9 Greek Small Letter Iota
    {0x7C, 0x10, 0x28, 0x44, 0x40},			   //   ( 34)  k - 0x03BA Greek Small Letter Kappa
    {0x41, 0x32, 0x0C, 0x30, 0x40},			   //   ( 35)    - 0x03BB Greek Small Letter Lamda
    {0x7E, 0x20, 0x20, 0x10, 0x3E},			   //   ( 36)  u - 0x03BC Greek Small Letter Mu
    {0x1C, 0x20, 0x40, 0x20, 0x1C},			   //   ( 37)  v - 0x03BD Greek Small Letter Nu
    {0x14, 0x2B, 0x2A, 0x2A, 0x60},			   //   ( 38)    - 0x03BE Greek Small Letter Xi
    {0x38, 0x44, 0x44, 0x44, 0x38},			   //   ( 39)  o - 0x03BF Greek Small Letter Omicron
    {0x44, 0x3C, 0x04, 0x7C, 0x44},			   //   ( 40)    - 0x03C0 Greek Small Letter Pi
    {0x70, 0x28, 0x24, 0x24, 0x18},			   //   ( 41)  p - 0x03C1 Greek Small Letter Rho
    {0x0C, 0x12, 0x12, 0x52, 0x60},			   //   ( 42)    - 0x03C2 Greek Small Letter Final Sigma
    {0x38, 0x44, 0x4C, 0x54, 0x24},			   //   ( 43)    - 0x03C3 Greek Small Letter Sigma
    {0x04, 0x3C, 0x44, 0x20, 0x00},			   //   ( 44)  t - 0x03C4 Greek Small Letter Tau
    {0x3C, 0x40, 0x40, 0x20, 0x1C},			   //   ( 45)  v - 0x03C5 Greek Small Letter Upsilon
    {0x18, 0x24, 0x7E, 0x24, 0x18},			   //   ( 46)    - 0x03C6 Greek Small Letter Phi
    {0x44, 0x28, 0x10, 0x28, 0x44},			   //   ( 47)  x - 0x03C7 Greek Small Letter Chi
    {0x0C, 0x10, 0x7E, 0x10, 0x0C},			   //   ( 48)    - 0x03C8 Greek Small Letter Psi
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
    {0x04, 0x05, 0x45, 0x25, 0x1C},			   //   ( 99)    - 0xFF97 Katakana Letter Ra
    {0x0F, 0x40, 0x20, 0x1F, 0x00},			   //   (100)    - 0xFF98 Katakana Letter Ri
    {0x7C, 0x00, 0x7E, 0x40, 0x30},			   //   (101)    - 0xFF99 Katakana Letter Ru
    {0x7E, 0x40, 0x20, 0x10, 0x08},			   //   (102)    - 0xFF9A Katakana Letter Re
    {0x7E, 0x42, 0x42, 0x42, 0x7E},			   //   (103)    - 0xFF9B Katakana Letter Ro
    {0x0E, 0x02, 0x42, 0x22, 0x1E},			   //   (104)    - 0xFF9C Katakana Letter Wa
    {0x42, 0x42, 0x40, 0x20, 0x18},			   //   (105)    - 0xFF9D Katakana Letter N
    {0x02, 0x04, 0x01, 0x02, 0x00},			   //   (106)    - 0xFF9E Katakana Voiced Sound Mark
    {0x07, 0x05, 0x07, 0x00, 0x00},			   //   (107)    - 0xFF9F Katakana Semi-Voiced Sound Mark
};

#endif
