tonuonu/NASA-Sample-Return-Robot/SPI-Gyro-shield/Code/SPI5.c

/*
 *  Copyright (c) 2013, 2014 Tonu Samuel
 *  All rights reserved.
 *
 *  This file is part of robot "Kuukulgur".
 *
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
 */

#include "ior32c111.h"
#include <intrinsics.h>
#include "hwsetup.h"
#include "main.h"
#include "SPI.h"

volatile unsigned char recv_bytenum=0;

static int min(const int a,const int b) {
    return (a < b) ? a : b;
}

static int max(const int a,const int b) {
    return (a > b) ? a : b;
}

__fast_interrupt void uart5_receive(void) {
    unsigned int transmit_byte=0xffff;		// Invalid byte value
    volatile unsigned char recvbyte=u5rb & 0xff;	// Reading u5rb enables receive for next byte

    if((CS5==0) && ENABLE_ARDUINO) {
        static unsigned char tmp;
        struct twobyte_st tmp2;
 
        static unsigned char command;
        static int motor_idx;

        switch(recv_bytenum) {
        case 0: // first byte received
            command=recvbyte & 0xFC;
            motor_idx=recvbyte & 0x03;
            tmp2.u.int16 = calc_median3((command == CMD_GET_VOLTAGE) ?
									voltage : cur_target_speed,motor_idx);
            transmit_byte=tmp2.u.byte[1];
            break;
        case 1:  // second byte received
            tmp=recvbyte;
            transmit_byte=tmp2.u.byte[0];
            break;
        case 2:
            if (command == CMD_SPEED || command == CMD_ACCELERATION) {
                    // receive second byte of speed/acceleration
                cur_cmd[motor_idx]=command;
                cur_cmd_param[motor_idx].u.byte[1]=tmp;
                cur_cmd_param[motor_idx].u.byte[0]=recvbyte;
                tmp2.u.int16 = min(255,max(-256,ticks[motor_idx].u.int16));
                tmp2.u.int16+= (motor_load[motor_idx] << 9);
                transmit_byte=tmp2.u.byte[1];
                ticks[motor_idx].u.int16=0; // clear accumulator
            }
            break;
        case 3:
            if (command == CMD_SPEED || command == CMD_ACCELERATION)
                transmit_byte=tmp2.u.byte[0];
            break;
        default:
            break;
        }
        recv_bytenum++;

    }

    if (transmit_byte <= 0xff) {
        TX5d=PD_OUTPUT;
        u5tb=transmit_byte;
    } else
        TX5d=PD_INPUT;

    /* Clear the 'reception complete' flag.	*/
    ir_s5ric = 0;
}

void
SPI5_Init(void) {
//    pu23=1; // Enable pullup to avoid floating pin noise on p7_7 (clock5)
//    pu24=1; // Enable pullup to avoid floating pin noise on p8_0 (rx5
    CLOCK5s = PF_UART;
    TX5d = PD_INPUT;	// To be changed to PD_OUTPUT for brief periods only, as needed
    TX5s = PF_UART;
    RX5s = PF_UART;

    smd0_u5mr  = 1;                                        // \ 
    smd1_u5mr  = 0;                                        //  | Synchronous Serial Mode
    smd2_u5mr  = 0;                                        // /

    ckdir_u5mr = 1;                                        // 1=external clock   
    stps_u5mr  = 0;                                        // 0=1 stop bit, 0 required
    pry_u5mr   = 0;                                        // Parity, 0=odd, 0 required 
    prye_u5mr  = 0;                                        // Parity Enable? 0=disable, 0 required 
    iopol_u5mr = myIOPOL;                                  // IO Polarity, 0=not inverted, 0 required

    clk0_u5c0 = 0;                                         // Clock source f1 for u5brg
    clk1_u5c0 = 0;                                         // 
    txept_u5c0 = 0;                                        // Transmit register empty flag 
    crd_u5c0 = 1;                                          // CTS disabled when 1
    nch_u5c0 = 0;                                          // 0=Output mode "push-pull" for TXD and CLOCK pin 
    ckpol_u5c0 = myCKPOL;                                  // CLK Polarity 0 rising edge, 1 falling edge
    uform_u5c0 = 1;                                        // 1=MSB first

    te_u5c1 = 1;                                           // 1=Transmission Enable
    ti_u5c1 = 0;                                           // Must be 0 to send or receive
    re_u5c1 = 1;                                           // Reception Enable when 1
    ri_u5c1 = 0;                                           // Receive complete flag - U5RB is empty.
    u5irs_u5c1 = 1;                                        // Interrupt when transmission is completed.
    u5rrm_u5c1 = 1;                                        // Continuous receive mode on
    u5lch_u5c1 = 1;                                        // Logical inversion off 

    u5smr = 0x00;
    u5smr2 = 0x00;

    sse_u5smr3 = 0;                                        // SS is disabled when 0
    ckph_u5smr3 = myCKPH;                                  // Non clock delayed 
    dinc_u5smr3 = 0;                                       // Slave mode when 1. Unsure if should be unless SS is used too
    nodc_u5smr3 = 0;                                       // Select a clock output  mode "push-pull" when 0 
    err_u5smr3 = 0;                                        // Error flag, no error when 0 
    dl0_u5smr3 = 0;                                        // Set 0 for no  delay 
    dl1_u5smr3 = 0;                                        // Set 0 for no  delay 
    dl2_u5smr3 = 0;                                        // Set 0 for no  delay 

    u5smr4 = 0x00;

    __disable_interrupt();
    /* 
     * Set fastest interrupt priority
     */
    fsit_ripl1 = 1;
    fsit_ripl2 = 1;
    __set_VCT_register((unsigned long)&uart5_receive);
    ilvl_s5ric = 7; // fast interrupt
    ir_s5ric   = 0;            
    ilvl_s5tic = 0;
    ir_s5tic   = 0;
    // we do not enable interrupts until FPGA code is loaded
}
