tonuonu/NASA-Sample-Return-Robot/PowerSupply/Code/hwsetup.cpp

/*
 *  Copyright (c) 2013 Tonu Samuel
 *  All rights reserved.
 *
 *  This file is part of robot "Kuukulgur".
 *
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
 */

#include <machine.h>
#include <stdint.h>

#include "iorx630.h"
#include "rskrx630def.h"
#include "oled.h"
#include "switch.h"
#include "hwsetup.h"
#include "led.h"

void HardwareSetup(void) {
  ConfigureOperatingFrequency();
  ConfigureOutputPorts();
  
  /* Set P3_4 (mode switch) as an input */
  PORT3.PDR.BIT.B4 = 0;
  PORT3.PMR.BIT.B4 = 0;
  /* Enable pullup */
  PORT3.PCR.BIT.B4 = 1;

  
  ConfigureInterrupts();
  EnablePeripheralModules();
  Init_DAC();
}

void ConfigureOperatingFrequency(void) {      
  uint16_t i = 0;
    
  /* Protection off */
  SYSTEM.PRCR.WORD = 0xA503;      

  /* Stop sub-clock */
  SYSTEM.SOSCCR.BYTE = 0x01;      

  /* Specify a wait state greater than 10ms at 12MHz (10.92 msec) */ 
  SYSTEM.MOSCWTCR.BYTE = 0x0D;    

  /* 4194304 state (default)*/
  /* wait over 12ms  @PLL=192MHz(12MHz*16) */                
  SYSTEM.PLLWTCR.BYTE = 0x0F;      

  /* x16 @PLL */
  SYSTEM.PLLCR.WORD = 0x0F00;  

  /* Configure the EXTAL pin */
  PORT3.PMR.BIT.B6 = 0;
  PORT3.PDR.BIT.B6 = 0;

  /* Configure the XTAL pin */
  PORT3.PMR.BIT.B7 = 0;
  PORT3.PDR.BIT.B7 = 0;    

  /* Turn on EXTAL */
  SYSTEM.MOSCCR.BYTE = 0x00;  
      
  /* Turn on the PLL and enable writing to the PLL control register */
  SYSTEM.PLLCR2.BYTE = 0x00;  
  
  /* Wait over 12ms */
  for(i=0; i<2075; i++) {
    nop();
  }
    
  /* Configure the clocks as follows -
  Clock Description              Frequency
  ----------------------------------------
  PLL Clock frequency...............192MHz
  System Clock Frequency.............96MHz
  Peripheral Module Clock B..........48MHz   
  FlashIF Clock......................48MHz
  External Bus Clock.................48MHz */       
  SYSTEM.SCKCR.LONG = 0x21821211; 
//  SYSTEM.SCKCR.BIT.BCK=6; // Change bus speed to lower, /64 divisor 
//  SYSTEM.SCKCR.BIT.PSTOP1=1; // Disable BCLK pin, it is useless for us;
  
  /* Configure the clocks as follows -
  Clock Description              Frequency
  ----------------------------------------
  USB Clock..........................48MHz    
  IEBus Clock........................24MHz */ 
  SYSTEM.SCKCR2.WORD = 0x0033;
  
  /* Set the clock source to PLL */
  SYSTEM.SCKCR3.WORD = 0x0400;
  
  /* Protection on */
  SYSTEM.PRCR.WORD = 0xA500;    
}

void ConfigureOutputPorts(void) {  

    /* Configure the LED pins (LED0-LED7) as outputs */
    LED0_PORT_DIR = 0x1;
    LED1_PORT_DIR = 0x1;
    LED2_PORT_DIR = 0x1;
    LED3_PORT_DIR = 0x1;
    LED4_PORT_DIR = 0x1;
    LED5_PORT_DIR = 0x1;
    LED6_PORT_DIR = 0x1;
    LED7_PORT_DIR = 0x1;

    LED_BLU_PORT_DIR = 0x1;
    LED_GRN_PORT_DIR = 0x1;
    LED_RED_PORT_DIR = 0x1;

    
    /* Set LED pin outputs as high (all LEDs off) */
    LED0 = LED_OFF;
    LED1 = LED_OFF;
    LED2 = LED_OFF;
    LED3 = LED_OFF;
    LED4 = LED_OFF;
    LED5 = LED_OFF;
    LED6 = LED_OFF;
    LED7 = LED_OFF;
    LED_RED = LED_OFF;
    LED_GRN = LED_OFF;
    LED_BLU = LED_OFF;



}

void Init_DAC(void)
{
    /* Protection off */
    SYSTEM.PRCR.WORD = 0xA503;
    
    /* PWPR.PFSWE write protect off */
    MPC.PWPR.BYTE = 0x00u;    
    
    /* PFS register write protect off */
    MPC.PWPR.BYTE = 0x40u;    
    
    /* Cancel the DAC module clock stop mode */
    MSTP_DA = 0;
    
    /* Set DAC output pin, P01, to output */
    PORT0.PDR.BIT.B5 = 0u;
    
    /* Set DAC output pin, P01, from general I/O to peripheral controlled. */
    PORT0.PMR.BIT.B5 = 0u;
    
    /* Set DAC output pin, P01, to an analog pin */
    MPC.P05PFS.BIT.ASEL = 1u;
        
    /* Enable ADC & DAC synchronization */
    DA.DAADSCR.BYTE = 0x01u;
    
    /* Configure DAC data register to align right (lsb = bit0) */
    DA.DADPR.BYTE = 0x00u;
        
    /* Enable DAC channel DA1 */
    DA.DACR.BIT.DAOE1 = 1u; 
    
    /* Set DAC data register to 0x0000 for first conversion */
    DA.DADR1 = 0x0000;
     
    /* Protection on */
    SYSTEM.PRCR.WORD = 0xA500u;
    
    /* Turn on PFS register write protect */
    MPC.PWPR.BYTE = 0x80u;    
        
}

void ConfigureInterrupts(void) {
  /* Configure switch interrupts */
  InitialiseSwitchInterrupts();
}

void EnablePeripheralModules(void) {
  /* Peripherals initialised in specific initialisation functions */
}
