tonuonu/NASA-Sample-Return-Robot/SPI-Gyro-shield/Code/hwsetup.c

/*
 *  Copyright (c) 2013 Tonu Samuel
 *  All rights reserved.
 *
 *  This file is part of robot "Kuukulgur".
 *
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
 */

#include "ior32c111.h"
#include "hwsetup.h"
#include <stdio.h>
#include <string.h>
#include <stddef.h>
#include <stdlib.h>
#include <stdarg.h>
#include "main.h"
#include "SPI.h"
#include "UART.h"


volatile struct statuses status;
unsigned int base_freq;

static void
ConfigureOperatingFrequency(char mode) {
    unsigned short i;

    prr = 0xAA;
    ccr = 0x1F; // 0001 1111
    prr = 0x00;
    prc0 = 1;
    pm3 = 0x60; // peripheral clock 48MHz
    prc0 = 0;
    prc2 = 1;
    *(unsigned short *) &plc0 = 0x0226; // 48MHz, PLL = 96MHz
//    *(unsigned short *) &plc0 = 0x0104; // 50MHz, PLL = 100MHz
    prc2 = 0;
    base_freq = 24000000;
//    base_freq = 25000000;

    for (i = 0; i < 0x8000u; i++);                         /* Add delay
                                                            * for PLL to
                                                            * stabilise. */
    /* 
     * Disable the port pins 
     */
    pd8_7 = 0;
    pd8_6 = 0;

    /* 
     * Disable the pull-up resistor 
     */
    pu25 = 0;

    /* 
     * Enable writing to CM0 
     */
    prc0 = 1;

    /* 
     * Start the 32KHz crystal 
     */
    cm04 = 1;

    /* 
     * Disable writing to CM0 
     */
    prc0 = 0;

    /* 
     * Enable writing to PM2 
     */
    prc1 = 1;
    /* 
     * Disable clock changes 
     */
    pm21 = 1;
    pm26 = 1;                                              
    /* 
     * Disable writing to PM2 
     */
    prc1 = 0;
    cst_tcspr = 0;
    tcspr = 0x08;
    cst_tcspr = 1;                                        
    cnt0_tcspr = 1; // f2n is 24Mhz / 16
    cnt1_tcspr = 1; // f2n is 24Mhz / 16
    cnt2_tcspr = 1; // f2n is 24Mhz / 16
    cnt3_tcspr = 1; // f2n is 24Mhz / 16
}

static void 
Led_Init(void) {
    LED1d  = PD_OUTPUT;
    LED2d  = PD_OUTPUT;
    LED3d  = PD_OUTPUT;
    LED4d  = PD_OUTPUT;
    LED5d  = PD_OUTPUT;
    LED1=LED2=LED3=LED4=0;
}

static void 
MotorIO_Init(void) {
    RESET0d = PD_OUTPUT;
    RESET1d = PD_OUTPUT;
    RESET2d = PD_OUTPUT;
    RESET3d = PD_OUTPUT;

#if 1
    RESET0=1;
    RESET1=1;
    RESET2=1;
    RESET3=1;
#endif    
    /* CDONE0...CDONE3 are inputs by default, skipping */
    
    MOTOR_ERRORd = PD_OUTPUT;
    
    udelay(1); // make sure high RESET* is noticed 
    
}

void
HardwareSetup(void) {
    /* 
     * Configures CPU clock 
     */
    __disable_interrupt();
    ConfigureOperatingFrequency(1);
//    __enable_interrupt();
    pu26=1; // Just to make sure unused P9_1 and P9_3 are not floating
    Led_Init();
    MotorIO_Init(); // Configure RESET and DONE pins. SPI conf is elsewhere
    Int_Init(); // Configure INT0 and INT2 interrupts

    /* Four motor ports, masters */
    SPI0_Init();
    SPI3_Init();
    SPI4_Init();
    SPI6_Init();

    /* Interface to Arduino, slave */
    SPI5_Init();

    /* Debug 3Mbps UART */
    UART1_Init();

}
