tonuonu/NASA-Sample-Return-Robot/PowerSupply/Code/hwsetup.h

/* Adapted for use with IAR Embedded Workbench */
/*******************************************************************************
* DISCLAIMER
* This software is supplied by Renesas Electronics Corporation and is only
* intended for use with Renesas products. No other uses are authorized. This
* software is owned by Renesas Electronics Corporation and is protected under
* all applicable laws, including copyright laws.
* THIS SOFTWARE IS PROVIDED "AS IS" AND RENESAS MAKES NO WARRANTIES REGARDING
* THIS SOFTWARE, WHETHER EXPRESS, IMPLIED OR STATUTORY, INCLUDING BUT NOT
* LIMITED TO WARRANTIES OF MERCHANTABILITY, FITNESS FOR A PARTICULAR PURPOSE
* AND NON-INFRINGEMENT. ALL SUCH WARRANTIES ARE EXPRESSLY DISCLAIMED.
* TO THE MAXIMUM EXTENT PERMITTED NOT PROHIBITED BY LAW, NEITHER RENESAS
* ELECTRONICS CORPORATION NOR ANY OF ITS AFFILIATED COMPANIES SHALL BE LIABLE
* FOR ANY DIRECT, INDIRECT, SPECIAL, INCIDENTAL OR CONSEQUENTIAL DAMAGES FOR
* ANY REASON RELATED TO THIS SOFTWARE, EVEN IF RENESAS OR ITS AFFILIATES HAVE
* BEEN ADVISED OF THE POSSIBILITY OF SUCH DAMAGES.
* Renesas reserves the right, without notice, to make changes to this software
* and to discontinue the availability of this software. By using this software,
* you agree to the additional terms and conditions found by accessing the
* following link:
* http://www.renesas.com/disclaimer
*******************************************************************************/
/* Copyright (C) 2012 Renesas Electronics Corporation. All rights reserved.   */
/*******************************************************************************
* File Name    : hwsetup.h
* Version     : 1.00
* Device     : R5F5630E
* Tool-Chain   : Renesas RX Toolchain 1.2.0.0
* H/W Platform  : RSKRX630
* Description   : Hardware setup header file.  
*******************************************************************************/
/*******************************************************************************
* History     : 23 Jan. 2012  Ver. 1.00 First Release
*******************************************************************************/

/*******************************************************************************
* Macro Definitions
*******************************************************************************/
/* Multiple inclusion prevention macro */
#ifndef HWSETUP_H
#define HWSETUP_H

#define ENABLE_PWR                  PORT1.PODR.BIT.B2
#define ENABLE_PWR_DIR              PORT1.PDR.BIT.B2


/*******************************************************************************
* Global Function Prototypes
*******************************************************************************/
/* MCU clock configuration function declaration */
void ConfigureOperatingFrequency(void);
/* MCU I/O port configuration function declaration */
void ConfigureOutputPorts(void);
/* Interrupt configuration function declaration */
void ConfigureInterrupts(void);
/* MCU peripheral module configuration function declaration */
void EnablePeripheralModules(void);
/* Hardware setup function declaration */
void HardwareSetup(void);
void Init_DAC(void);

/* End of multiple inclusion prevention macro */
#endif
