tonuonu/NASA-Sample-Return-Robot/SPI-Gyro-shield/Code/SPI6.c

/*
 *  Copyright (c) 2013 Tonu Samuel
 *  All rights reserved.
 *
 *  This file is part of robot "Kuukulgur".
 *
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
 */

#include "ior32c111.h"
#include <intrinsics.h>
#include "hwsetup.h"
#include "main.h"
#include "SPI.h"

void
SPI6_Init(void) {
    u6brg =  (unsigned char)(((base_freq)/(1*MOTORS_SPI_SPEED))-1);
    CS3d = PD_OUTPUT;
    CS3=1;
    CLOCK6d = PD_OUTPUT;
    CLOCK6s = PF_UART;
    TX6d = PD_OUTPUT;
    TX6s = PF_UART;
    RX6s = PF_UART;

    smd0_u6mr  = 1;                                        // \ 
    smd1_u6mr  = 0;                                        //  | Synchronous Serial Mode
    smd2_u6mr  = 0;                                        // /

    ckdir_u6mr = 0;                                        // 0=internal clock   
    stps_u6mr  = 0;                                        // 0=1 stop bit, 0 required
    pry_u6mr   = 0;                                        // Parity, 0=odd, 0 required 
    prye_u6mr  = 0;                                        // Parity Enable? 0=disable, 0 required 
    iopol_u6mr = myIOPOL;                                        // IO Polarity, 0=not inverted, 0 required

    clk0_u6c0 = 0;                                         // Clock source f1 for u6brg
    clk1_u6c0 = 0;                                         // 
    txept_u6c0 = 0;                                        // Transmit register empty flag 
    crd_u6c0 = 1;                                          // CTS disabled when 1
    nch_u6c0 = 0;                                          // 0=Output mode "push-pull" for TXD and CLOCK pin 
    ckpol_u6c0 = myCKPOL;                                        // CLK Polarity 0 rising edge, 1 falling edge
    uform_u6c0 = 1;                                        // 1=MSB first

    te_u6c1 = 1;                                           // 1=Transmission Enable
    ti_u6c1 = 0;                                           // Must be 0 to send or receive
    re_u6c1 = 1;                                           // Reception Enable when 1
    ri_u6c1 = 0;                                           // Receive complete flag - u6RB is empty.
    u6irs_u6c1 = 1;                                        // Interrupt  when transmission is completed. 
    u6rrm_u6c1 = 0;                                        // Continuous receive mode off
    u6lch_u6c1 = 1;                                        // Logical inversion off 

    u6smr = 0x00;
    u6smr2 = 0x00;

    sse_u6smr3 = 0;                                        // SS is disabled when 0
    ckph_u6smr3 = myCKPH;                                       // Non clock delayed 
    dinc_u6smr3 = 0;                                       // Master mode when 0
    nodc_u6smr3 = 0;                                       // Select a clock output  mode "push-pull" when 0 
    err_u6smr3 = 0;                                        // Error flag, no error when 0 
    dl0_u6smr3 = 0;                                        // Set 0 for no  delay 
    dl1_u6smr3 = 0;                                        // Set 0 for no  delay 
    dl2_u6smr3 = 0;                                        // Set 0 for no  delay 

    u6smr4 = 0x00;
#if 0
    __disable_interrupt();
    /* 
     * No interrupts
     */
    ilvl_s6ric =0;
    ir_s6ric   =0;            
    ilvl_s6tic =0;
    ir_s6tic   =0;            
    __enable_interrupt();
#endif
}
