tonuonu/NASA-Sample-Return-Robot/SPI-Gyro-shield/Code/SPI0.c

/*
 *  Copyright (c) 2013 Tonu Samuel
 *  All rights reserved.
 *
 *  This file is part of robot "Kuukulgur".
 *
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
 */

#include "ior32c111.h"
#include <intrinsics.h>
#include "hwsetup.h"
#include "main.h"
#include "SPI.h"

void
SPI0_Init(void) {
    u0brg =  (unsigned char)(((base_freq)/(1*MOTORS_SPI_SPEED))-1);

    CS0d = PD_OUTPUT;
    CS0=1;
    CLOCK0d = PD_OUTPUT;
    CLOCK0s = PF_UART;
    TX0d = PD_OUTPUT;
    TX0s = PF_UART;
    RX0s = PF_UART;

    smd0_u0mr  = 1;                                        // \ 
    smd1_u0mr  = 0;                                        //  | Synchronous Serial Mode
    smd2_u0mr  = 0;                                        // /

    ckdir_u0mr = 0;                                        // 0=internal clock   
    stps_u0mr  = 0;                                        // 0=1 stop bit, 0 required
    pry_u0mr   = 0;                                        // Parity, 0=odd, 0 required 
    prye_u0mr  = 0;                                        // Parity Enable? 0=disable, 0 required 
    iopol_u0mr = myIOPOL;                                        // IO Polarity, 0=not inverted, 0 required

    clk0_u0c0 = 0;                                         // Clock source f1 for u0brg
    clk1_u0c0 = 0;                                         // 
    txept_u0c0 = 0;                                        // Transmit register empty flag 
    crd_u0c0 = 1;                                          // CTS disabled when 1
    nch_u0c0 = 0;                                          // 0=Output mode "push-pull" for TXD and CLOCK pin 
    ckpol_u0c0 = myCKPOL;                                  // CLK Polarity 0 rising edge, 1 falling edge
    uform_u0c0 = 1;                                        // 1=MSB first

    te_u0c1 = 1;                                           // 1=Transmission Enable
    ti_u0c1 = 0;                                           // Must be 0 to send or receive
    re_u0c1 = 1;                                           // Reception Enable when 1
    ri_u0c1 = 0;                                           // Receive complete flag - U2RB is empty.
    u0irs_u0c1 = 1;                                        // Interrupt  when transmission is completed. 
    u0rrm_u0c1 = 0;                                        // Continuous receive mode off
    u0lch_u0c1 = 1;                                        // Logical inversion off 

    u0smr = 0x00;
    u0smr2 = 0x00;

    sse_u0smr3 = 0;                                        // SS is disabled when 0
    ckph_u0smr3 = myCKPH;                                  // Non clock delayed 
    dinc_u0smr3 = 0;                                       // Master mode when 0
    nodc_u0smr3 = 0;                                       // Select a clock output  mode "push-pull" when 0 
    err_u0smr3 = 0;                                        // Error flag, no error when 0 
    dl0_u0smr3 = 0;                                        // Set 0 for no  delay 
    dl1_u0smr3 = 0;                                        // Set 0 for no  delay 
    dl2_u0smr3 = 0;                                        // Set 0 for no  delay 

    u0smr4 = 0x00;
}
