tonuonu/NASA-Sample-Return-Robot/PowerSupply/Code/spi.h

/*
 *  Copyright (c) 2013 Tonu Samuel
 *  All rights reserved.
 *
 *  This file is part of robot "Kuukulgur".
 *
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
 */
#ifndef SPI_H
#define SPI_H


// Configuration bits MPU6000
#define BIT_SLEEP                   0x40
#define BIT_H_RESET                 0x80
#define BITS_CLKSEL                 0x07
#define MPU_CLK_SEL_PLLGYROX        0x01
#define MPU_CLK_SEL_PLLGYROZ        0x03
#define MPU_EXT_SYNC_GYROX          0x02
#define BITS_FS_250DPS              0x00
#define BITS_FS_500DPS              0x08
#define BITS_FS_1000DPS             0x10
#define BITS_FS_2000DPS             0x18
#define BITS_FS_2G                  0x00
#define BITS_FS_4G                  0x08
#define BITS_FS_8G                  0x10
#define BITS_FS_16G                 0x18
#define BITS_FS_MASK                0x18
#define BITS_DLPF_CFG_256HZ_NOLPF2  0x00
#define BITS_DLPF_CFG_188HZ         0x01
#define BITS_DLPF_CFG_98HZ          0x02
#define BITS_DLPF_CFG_42HZ          0x03
#define BITS_DLPF_CFG_20HZ          0x04
#define BITS_DLPF_CFG_10HZ          0x05
#define BITS_DLPF_CFG_5HZ           0x06
#define BITS_DLPF_CFG_2100HZ_NOLPF  0x07
#define BITS_DLPF_CFG_MASK          0x07
#define BIT_INT_ANYRD_2CLEAR        0x10
#define BIT_RAW_RDY_EN              0x01
#define BIT_I2C_IF_DIS              0x10    
#define MPUREG_SMPLRT_DIV           0x19
#define MPUREG_CONFIG               0x1A
#define MPUREG_GYRO_CONFIG          0x1B
#define MPUREG_ACCEL_CONFIG         0x1C
#define MPUREG_INT_PIN_CFG          0x37
#define MPUREG_INT_ENABLE           0x38
#define MPUREG_USER_CTRL            0x6A
#define MPUREG_PWR_MGMT_1           0x6B
#define MPUREG_PWR_MGMT_2           0x6C
#define MPUREG_WHOAMI               0x75

#define MPUREG_TEMP_OUT             0x41

#define MPUREG_GYRO_XOUT            0x43
#define MPUREG_GYRO_YOUT            0x45
#define MPUREG_GYRO_ZOUT            0x47

#define MPUREG_ACCEL_XOUT            0x3B
#define MPUREG_ACCEL_YOUT            0x3D
#define MPUREG_ACCEL_ZOUT            0x3F



#ifdef __cplusplus
extern "C" {
#endif
#include <stdint.h>

  
extern volatile int16_t gyro0[3];
extern volatile int16_t gyro1[3];
extern volatile int16_t accel0[3];
extern volatile int16_t accel1[3];
void Init_SPI(void);
//void MasterSend_SPI(uint16_t, uint8_t *);
void Init_Gyros(void);
void sendspi24(uint8_t cmd);
void read_gyro(void) ;

#ifdef __cplusplus
} // extern "C"
#endif

/* End of multiple inclusion prevention macro */
#endif
