tonuonu/NASA-Sample-Return-Robot/PowerSupply/Code/adc12repeat.h

#ifdef __cplusplus
extern "C" {
#endif

/* Multiple inclusion prevention macro */
#ifndef ADC12_REPEAT_H
#define ADC12_REPEAT_H

/* Define a macro to indicate selection of a periodic timer mode */
#define PERIODIC_MODE 0x1
volatile extern float adc[8] ;
volatile extern float adapter;
volatile extern float imon1, imon1max ;
volatile extern float imon2, imon2max ;

/*******************************************************************************
* Global Function Prototypes
*******************************************************************************/
/* ADC initialisation function prototype declaration */
void Init_ADC12Repeat(void);
//void uint16_ToString(uint8_t *output_string, uint8_t pos, uint16_t input_number);

/* End of multiple inclusion prevention macro */
#endif

#ifdef __cplusplus
}
#endif
