tonuonu/NASA-Sample-Return-Robot/PowerSupply/Code/log.h

#ifdef __cplusplus
extern "C" {
#endif


/* Multiple inclusion prevention macro */
#ifndef LOG_H
#define LOG_H

void logerror(char *buf);
  
/* End of multiple inclusion prevention macro */
#endif

#ifdef __cplusplus
}
#endif
