tonuonu/NASA-Sample-Return-Robot/PowerSupply/Code/low_voltage_detection.cpp

/*
 *  Copyright (c) 2013 Tonu Samuel
 *  All rights reserved.
 *
 *  This file is part of robot "Kuukulgur".
 *
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
 */

#include "delay.h"
#include "hwsetup.h"
#include "oled.h"
#include "tnroman.h"
#include "iorx630.h"
#include "rskrx630def.h"
#include "low_voltage_detection.h"

bool gVCCAboveVdet = true;

void Init_VoltageDetect(void) {	
	/* Disable write protection of the system registers */
	SYSTEM.PRCR.WORD = 0xA508;
	
	/* Set vdet1 to 2.95V */
	SYSTEM.LVDLVLR.BYTE = 0x0Au;
	
	/* Disable digital filter */
	SYSTEM.LVD1CR0.BIT.LVD1DFDIS = 1u;

	/* Enable vdet1 interrupt */
	SYSTEM.LVD1CR0.BIT.LVD1RI = 0;
	
	/* Set vdet1 to trigger when VCC is below trigger value */
	SYSTEM.LVD1CR1.BYTE = 0x02u;
	
	/* Enable output comparison */
	SYSTEM.LVD1CR0.BIT.LVD1CMPE = 1u;
	
	/* Clear the vdet1 flag */
	SYSTEM.LVD1SR.BIT.LVD1DET = 0;
	
	/* Ensure vdet flag is cleared */
	while(SYSTEM.LVD1SR.BIT.LVD1DET);
			
	/* Enable vdet1 interrupt */		
	SYSTEM.LVD1CR0.BIT.LVD1RIE = 1u;	
			
	/* Enable vdet1 */
	SYSTEM.LVCMPCR.BIT.LVD1E = 1u;		
			
	/* Enable vdet1 NMI interrupt */
	ICU.NMIER.BIT.LVD1EN = 1u;

	/* Re-enable write protection of the system registers */
	//SYSTEM.PRCR.BIT.PRC3 = 0xA50u;
}

/*******************************************************************************
* Outline 		: NonMaskableInterrupt
* Description 	: NMI interrupt handler. The function is called when an NMI 
*				  interrupt is triggered (voltage detection interrupt triggers
*				  an NMI). If VCC < VDET, the function sets the voltage detect
*				  point to above VDET and vice versa. The function also updates
*				  the gVCCAboveVdet flag.
*******************************************************************************/
void NonMaskableInterrupt(void) {
	/* Clear vdet1 passage detection flag */
	SYSTEM.LVD1SR.BIT.LVD1DET = 0;
	
	/* Clear NMI interrupt flag */
	ICU.NMICLR.BIT.LVD1CLR = 1;
	
	/* Check if VCC is below trigger voltage */
	if(SYSTEM.LVD1SR.BIT.LVD1MON == 0) {
		/* Set vdet to trigger when VCC > trigger voltage */
		SYSTEM.LVD1CR1.BYTE = 0x00u;
		
		/* Set global vdet status flag */
		gVCCAboveVdet = false;	
	} else	{	/* VCC is above trigger voltage */
		/* Set vdet to trigger VCC < trigger voltage */
		SYSTEM.LVD1CR1.BYTE = 0x02u;	
		
		/* Set global vdet status flag */
		gVCCAboveVdet = true;
		
	}	
}
