tonuonu/NASA-Sample-Return-Robot/(commit log)

2013-10-27 new power supply initial code commit
2013-11-09 5 x SPI skeleton in
2013-11-09 TX interrupt skeletons added
2013-11-10 Work on SPI system
2013-11-10 spi5 receive interrupt works!
2013-11-24 Eagle files in
    [kulgurpower.brd, kulgurpower.sch, kulgurpowerMCU.brd, kulgurpowerMCU.sch, kulgurpowerproto.brd, kulgurpowerproto.sch, kulgurpowerproto2.brd, kulgurpowerproto2.sch]
2013-11-25 More schematics in
    [kulgurpower.sch, kulgurpowerMCU2.brd, kulgurpowerMCU2.sch]
2013-12-01 Lot of changes to schematics. A lot.
    [kulgurpower.brd, kulgurpower.sch, kulgurpowerMCU2.brd, kulgurpowerMCU2.sch]
2013-12-07 lot of work done on schematics
    [Arduino_kuukulgur-alternatiivne.brd, Arduino_kuukulgur-alternatiivne.sch, kulgurpower.brd, kulgurpower.sch, kulgurpowerMCU2.brd, kulgurpowerMCU2.sch]
2013-12-08 More work on electronics
    [kulgurpower.brd, kulgurpowerMCU2.brd, kulgurpowerMCU2.sch]
2013-12-08 PWM code fixes
2013-12-09 Converted into 2 layer board from 4 layer. Seems to be OK for production
    [kulgurpower.brd, kulgurpower.sch, kulgurpowerMCU2.brd, kulgurpowerMCU2.sch]
2013-12-10 Silkscreen fixes
    [kulgurpower.brd, kulgurpower.sch, kulgurpowerMCU2.brd]
2013-12-14 Minor bugfixes to boards.
    [Arduino_kuukulgur-alternatiivne.brd, Arduino_kuukulgur-alternatiivne.sch, kulgurpowerMCU2.brd, kulgurpowerMCU2.sch]
2013-12-14 Seems I got SPI signalling now right
2013-12-15 Fully interrupt driven solution was too slow. Rewrote to main loop state machine way.
    [SPI.h, SPI0.c, SPI3.c, SPI4.c, SPI5.c, hwsetup.c, interrupt.c, main.c]
2013-12-15 Clarifications in schematic
    [Arduino_kuukulgur-alternatiivne.brd, Arduino_kuukulgur-alternatiivne.sch]
2013-12-22 Wait for data transmissions to end before letting CS go high Enable fast interrupt for UART5 RX
2013-12-23 Minor fixes to PCB
    [kulgurpower.brd, kulgurpower.sch]
2013-12-23 Garbage cleanup
    [kulgurpowerMCU.brd, kulgurpowerMCU.sch]
2013-12-29 New version of Arduino shield implemented
    [Arduino_kuukulgur-alternatiivne2.brd, Arduino_kuukulgur-alternatiivne2.sch]
2014-01-01 New hardware revision needs some fixes
    [hwsetup.cpp, oled.cpp, oled.h, pwm.cpp, rskrx630def.h]
2014-01-01 Switch stuff modified for 4 switches RGB LED PWM stuff modified
2014-01-01 Cosmetic fixes to switch logic
    [switch.cpp]
2014-01-05 ADC works POWER_EN works
2014-01-05 ADC does now 4 times measurement in hardware and averages result. Battery enable outputs are configured
2014-01-05 Imon1, Imon2 inputs done temperature stuff removed Adapter voltage measurement done ADC12 averaging added Out1...out5 configuration added
2014-01-05 Two resistors in ladder were swapped Nominals rised for pullup. Next power bill will be smaller!
    [kulgurpower.brd, kulgurpower.sch, kulgurpowerMCU2.brd, kulgurpowerMCU2.sch]
2014-01-13 Misc fixes about ADCs Basic menu system implemented Clarifications about MAX1614 driving basic errorlog implementation
    [adc12repeat.cpp, main.cpp, oled.h, rskrx630def.h, rtc.cpp, switch.cpp]
2014-01-13 MCU board version 3
    [kulgurpowerMCU3.brd, kulgurpowerMCU3.sch]
2014-01-13 Powersupply main board new version added
    [kulgurpower2.brd, kulgurpower2.sch]
2014-01-18 Misc fixes of nominals
    [Arduino_kuukulgur-alternatiivne2.brd, Arduino_kuukulgur-alternatiivne2.sch]
2014-01-18 Gyroscope code addad. Nonworking yet.
2014-01-24 SPI2 instead of SPI6 now. P7_0 and P7_1 are open collector outputs only and not fit for our work.
    [SPI3.c, SPI5.c, SPI6.c, hwsetup.h, main.c]
2014-01-24 New shield PCB version.
    [Arduino_kuukulgur-alternatiivne3.brd, Arduino_kuukulgur-alternatiivne3.sch]
2014-01-24 Both gyros work on basic level
2014-01-24 Gyros, step 2
2014-01-26 gyro on usb works
2014-01-26 Misc USB shell fixes
    [main.cpp, shell.c, spi.c, usb.c]
2014-01-26 Now regular interrupt is ran 1000 times per second. Timings are fixed, so we have plenty of free time. Gyroscope settings are fixed.
    [main.cpp, spi.c, spi.h]
2014-01-26 Oops, removed too much.
    [spi.c]
2014-02-13 Shield PCB as ordered in.
    [Arduino_kuukulgur-alternatiivne3.brd, Arduino_kuukulgur-alternatiivne3.sch]
2014-02-13 Never MCU board of power supply in. 19.2Mhz oscillator added
    [kulgurpowerMCU3.brd, kulgurpowerMCU3.sch]
2014-02-13 New lower PCB of power supply in
    [kulgurpower2.brd, kulgurpower2.sch]
2014-02-19 Things like this for steering servos:
    robot:/#
    robot:/# setsteering 0 0
    robot:/# setsteering 100 100
    robot:/# setsteering -100 1
    robot:/# setsteering -100 -100
    robot:/#
    Verified on oscilloscope.
2014-02-27 Steering servo current measuring UI and calculations fixed, maximum value now always known. Added screen to manage steering power supply Added Power Good info. Extended steering servo range
    [adc12repeat.cpp, adc12repeat.h, hwsetup.h, interrupt-main.cpp, main.cpp, oled.cpp, oled.h, rskrx630def.h]
2014-03-31 Returning ACS712 correct constant
    [interrupt-main.cpp]
2014-03-31 Setsteering off implemented Steering angle is wider now Disable automatic start of servo PWMs
2014-03-31 New versions of PCBs in. This version went to Seeedstudio order
    [kulgurpower2-unrouted.brd, kulgurpower2-unrouted.sch, kulgurpowerMCU3-unrouted.brd, kulgurpowerMCU3-unrouted.sch]
2014-04-10 More fixes on motor issues
    [SPI.h, SPI0.c, SPI5.c, main.c, main.h]
2014-04-10 Added support for different motors having different currend commands (CMD_SPEED or CMD_ACCELERATION)
2014-04-10 Fixed a syntax error
    [main.c]
2014-04-10 Implemented CMD_GET_CUR_TARGET_SPEED; also CMD_SPEED/CMD_ACCELERATION now return cur target speed (even though the Arduino code currently does not use it)
2014-04-10 PCB updates
    [Arduino_kuukulgur-alternatiivne3.sch, kulgurpower.brd, kulgurpower.sch, kulgurpowerMCU3-unrouted.brd]
2014-04-10 typo fix unneccessary delay removed
    [SPI5.c, main.c]
2014-04-11 Make RESET on INT0 Clarification
    [interrupt.c, main.h]
2014-04-11 Misc schematic clarifications
    [Arduino_kuukulgur-alternatiivne3.brd, Arduino_kuukulgur-alternatiivne3.sch]
2014-04-19 TX5 pin is now PD_INPUT for most of the time, to be changed to PD_OUTPUT only for brief periods when needed
2014-04-19 Changed SPI5 motor load/switchcount protocol to be the same as in motor controller protocol
2014-04-19 Fixed a compiler warning
    [SPI5.c]
2014-04-19 Fixed a bug where SPI5 receive stopped after any SPI5 transaction with CS5 HIGH
    [SPI5.c]
2014-04-19 Changed motor controller reset logic
    [main.c]
2014-04-19 Simplified motor tickcount and load calculations
2014-04-19 Hopefully fixed complete_*tx() handling in send_cur_cmd() for RX bytes
    [main.c, main.h]
2014-04-19 Again, hopefully fixed complete_*tx() handling in send_cur_cmd() for RX bytes
    [main.c]
2014-04-19 For motors that are not ready, consider voltage/load/ticks/cur_speed to be all 0
2014-04-19 Added a 100ms delay to the end of motor controller reset procedure, as apparently motor controller reports garbage values during that period
    [main.c]
2014-04-19 For motors that report voltage=0, consider load/ticks/cur_speed to be all 0
2014-04-19 get_voltage() is now done before send_cur_cmd(), to detect failed motors (voltage=0) earlier
    [main.c]
2014-04-19 Reverted change "Added a 100ms delay to the end of motor controller reset procedure, as apparently motor controller reports garbage values during that period"
    [main.c]
2014-04-19 Reduced the length of time when interrupts are disabled in receive_ticks()
2014-04-20 Schematic component type fixes
    [kulgurpower2-unrouted.brd, kulgurpower2-unrouted.sch]
2014-04-20 Motor controller reset procedure now waits until all motors report nonzero voltage (max wait 300ms)
    [main.c]
2014-04-20 voltage and cur_target_speed are now reported to SPI5 as median of last 3 values
2014-04-20 Motor status LEDs now use motor_online[] flags instead of CDONE*
2014-04-20 Some values changed in schematic
    [kulgurpower2-unrouted.brd, kulgurpower2-unrouted.sch]
2014-04-20 Voltage 0xffff is now considered invalid, just like voltage 0
2014-04-20 Fixed voltage 0xffff check
    [main.c]
2014-04-20 Motor controller reset is now triggered based on motor_online[] instead of CDONE*
    [main.c]
2014-04-20 Reordered pin definitions to be more logical
2014-04-23 After downloading FPGA image to motor controllers, send CMD_SPEED repeatedly to workaround a motor controller bug
    [main.c]
2014-04-23 Fixed a recently introduced bug that shortened motor valid voltage wait cycle
    [main.c]
2014-04-23 Added automatic detection of motor IDs, allowing any motor to be connected to any UART socket
2014-04-23 Fixed a bug when setting backup UART_to_motor_id[] values
    [main.c]
2014-04-23 Renamed CDONEx numbers to correspond to the same ordering as CSx/MxTX/MxRX/motor_id
2014-04-23 Fixed a bug where CDONE checks did not use UART_to_motor_id[]
    [main.c]
2014-05-14 Cleanup, indent Mode switch added New current formula for imon1/2 More tolerant to little overvoltage Chargers have faster, 30kHz PWM now
2014-05-14 PCB/sch small changes. 19.2Mhz fix additional transistor PSU resistor fixes
    [kulgurpower2-unrouted.brd, kulgurpower2-unrouted.sch, kulgurpowerMCU3-unrouted.brd, kulgurpowerMCU3-unrouted.sch]
2014-05-19 Values changed
    [kulgurpower2-unrouted.brd, kulgurpower2-unrouted.sch]
2014-05-19 cat /switch implemented
2014-05-21 Motors are now reset and FPGA image sent only when all motors are stopped, and max once in 30 seconds
    [main.c]
2014-05-22 Fixed a bug in all_motors_stopped handling
    [main.c]
2014-05-24 turn off current protection
2014-05-24 5V is important
    [kulgurpower2-unrouted.brd, kulgurpower2-unrouted.sch]
2014-05-30 AD input and interrupt are much faster now RGB LED code is better slightly DA code added
2014-05-31 Show adapter voltage on OLED Disable current indication if battery is not connected. Otherwise they show 8.8A because lack of 5V on current sensors
2014-05-31 !SKIP0..!SKIP3 port configuration added
    [rskrx630def.h]
2014-05-31 Shell command cat /power/status added
2014-05-31 Charging solution. Does not work yet :(
    [interrupt-main.cpp]
2014-06-09 PGOOD problems are detected and fix attempted ADC now makes 4 readings and averages their value instead of 1 reading Before making suicide OLED is updated, red LED is lit
    [adc12repeat.cpp, interrupt-main.cpp]
2014-06-09 Debugging 3Mbps serial interface added to Renesas shield code Competition standard motor controller FPGA image included
2014-06-13 NASA level 1 (2nd try) (whistling)
    [Rubeet.xlsx]
